sl33pinging/SplitSys/docs/HW_CHECKLIST.md

# SplitSys Phase H hardware checklist

Owner: `fpga-integrator`. Other agents contribute rows through the lead.
Phase H starts only after `red-team-reviewer` passes S4 (docs/PLAN.md).

**Rules for the session.** One physical action per message. Before each step the lead states the exact command and what the human should see. On any mismatch: **stop**, capture the evidence named in the row, and hand off for simulation reproduction (`verification-engineer`) **before** any rebuild or reprogram. Never overwrite `fpga/known_good/`.

All commands run from the repo root `C:\Users\danie\FPGA_Projects\Calhack2026` in **Git Bash** unless marked otherwise.

---

## Session results (Sat 2026-10-24; source: docs/STATUS.md decisions log)

| Step | KG1 = build `52a66216` (md5 6a85a822…) | KG2 = build `38a3950a` (md5 63dea71f…) |
| --- | --- | --- |
| H-1 heartbeat / LEDs / 7-seg | PASS (~12:45–12:58). Found two issues: 7-seg digit order reversed, RGB LEDs glow (PULLUP) | PASS (14:19–16:19): `S 14.4` reads in the right order, RGB dark |
| H-2 UART echo | PASS (~13:00): 10,000 B and 100,000 B, 0 mismatched. UART direction from the schematic confirmed | not rerun (UART RTL and pins unchanged) |
| H-3 packet / memory | PASS 13:19: 10,000 frames, 0 bad bytes | not rerun |
| H-4 self-test | PASS 13:26: 0/256 OBUF bytes differ | PASS 16:19: 0/256 |
| H-5 random GEMMs | PASS 13:37: 200 GEMMs, 0 output/counter mismatches | PASS 16:29: 200 GEMMs, 0 mismatches |
| H-6 benchmarks | PASS 13:41: 56/56, model error 0.000 % | not rerun |
| H-7 dashboard cold start | PASS (dashboard part, ~13:52–14:15, not clock-read): live kiosk on the monitor, BOARD LIVE build 52a66216, scripted demo (Space) ran and ended on Scene 2 with HW data (human screenshot); 16 dashboard records @52a66216 committed cd75ccc. Cold-start drill not possible without flash → done on KG2 | PASS 17:04 (with H-8e): `start_demo.ps1` 1.9 s wall (~2 s); STATUS records total ≈ 3–5 s; target < 60 s |
| H-8 QSPI flash + boot | not flashed | PASS: flash programmed and verified 16:42 (34 s); cold power-up from flash in **~1 s** (~16:50) |
| Archived | KG1 ~13:43 (7b3af2c), kept | KG2 16:31 (ccd7e3b); **`fpga/known_good/CURRENT` → KG2** |

**Booth configuration.** The board boots KG2 from QSPI flash. **Jumper J14 must stay fitted** (M2 tied to GND = Master SPI boot). If J14 is removed, the board powers up unconfigured. The live dashboard runs on **COM3**.

**Fallbacks** (each one replaces the running design, so stop the dashboard first; then restart it as in H-7):
- **KG2 over JTAG.** `program.tcl` works with J14 fitted, so the jumper can stay: `scripts/vivado -mode batch -source fpga/tcl/program.tcl -tclargs fpga/known_good/CURRENT` → `PROGRAM_OK`. JTAG configuration lasts until the next power cycle, after which the board reboots from flash (KG2).
- **KG1 over JTAG**, if KG2 misbehaves: `scripts/vivado -mode batch -source fpga/tcl/program.tcl -tclargs fpga/known_good/KG1/top.bit` (build 52a66216; known cosmetic quirks: reversed 7-seg digits, RGB LEDs lit). Do not edit `CURRENT` by hand.
- **Flash problems**: see the H-8 failure branch (`--verify-only`, rewrite, `--erase`, remove J14).

---

## Pre-flight (do once, in order)

| # | Check | Command / action | Expected |
| --- | --- | --- | --- |
| P-1 | USB strategy | Read `docs/ENV.md` "USB strategy". Default **(b)**: host runs natively on Windows on the board's COM port; Windows Vivado programs over JTAG. | Strategy (b) confirmed by the human. |
| P-2 | Board not attached to WSL | PowerShell: `usbipd list` | The Urbana's USB device is **not** "Attached". If it is: `usbipd detach --busid <id>`. |
| P-3 | Board connected | Human: plug the micro-USB cable into the Urbana and the laptop; set the power switch on. | Board power LED on. |
| P-4 | Windows sees the COM port | PowerShell: `Get-CimInstance Win32_SerialPort \| Select-Object DeviceID,Description` (or Device Manager → Ports) | One new COM port appears when the board is plugged in. Record it here: `COM__`. |
| P-5 | Vivado sees the device | `scripts/vivado -mode batch -source fpga/tcl/program.tcl -tclargs <bit>` is the first real use; if in doubt, open Vivado Hardware Manager → Open Target → Auto Connect. | One device `xc7s50_0`. |
| P-5a | Windows host binary | PowerShell: `powershell -NoProfile -ExecutionPolicy Bypass -File scripts\win_build_host.ps1` (docs/ENV.md "Windows host build (USB strategy b)"; needs Windows rustup/cargo, the script prints install steps and exits 2 if they are missing) | Ends with `OK: ...sw\target\release\splitsys-host.exe`; the COM ports it lists include the board's. **The exe must be newer than the last commit touching `demo/` or `sw/crates/host`** (the dashboard is compiled into the binary): compare Git Bash `git log -1 --format=%cd -- demo sw/crates/host` with `ls -l --time-style=full-iso sw/target/release/splitsys-host.exe`; if the exe is older, or either tree has uncommitted changes (`git status --short demo sw/crates/host` not empty), rerun this script. Checked 12:37 on 2026-10-24: last change 12:20:26, exe 12:35:20 (current). With the board connected, `scripts\win_build_host.ps1 -Ping -Transport serial:COM__` once a packet bitstream (H-3 onward) is loaded. |
| P-6 | Bitstreams present and current | `cat fpga/reports/<tag>/summary.json` for each tag used below; `git log --oneline -1` | `"pass":true`, `"git_dirty":"false"`, `wns_ns` ≥ 0. The `build_id` you will see on the board is the `build_id` field. If `fpga/build/<tag>/top.bit` is missing (it is gitignored), rebuild with the command in the row; the build_id then changes to the new HEAD hash. |

---

## Board facts (verified in Phase S from the vendor files; confirmed on hardware in Phase H)

Sources: master XDC `fpga/xdc/urbana_master.xdc` ("URBANA BOARD CONSTRAINTS V2I1 1/3/2023") and the schematic `C:\Users\danie\Downloads\Urbana_V2I1_SCH_2023-01-03.PDF` (19 pages, V2I1). Schematic facts were read from the PDF's embedded net/pin annotations (text extraction with pypdf; the pages were not rendered).

| Fact | Value | Evidence |
| --- | --- | --- |
| Clock | 100 MHz on FPGA N15 | master:2–4; sch p11: oscillator IC16 `ASEM1-100.000MHZ` → buffer IC15 → net `CLK_100MHZ` → N15 |
| USB-UART direction | **FPGA receives on B16, transmits on A16.** The master-XDC names are from the FTDI's side. | sch p12: B16 = net `UART_TXD`, A16 = net `UART_RXD`. sch p10: `UART_TXD` = FT2232HQ (IC6) pin 38 = BDBUS0, `UART_RXD` = pin 39 = BDBUS1; channel A pins 16–19 are JTAG (FT_TCK/TDI/TDO/TMS), so channel B is the UART, where BDBUS0 = TXD (FTDI output) and BDBUS1 = RXD (FTDI input), per the FTDI DS_FT2232H pin table (vendor datasheet, from knowledge; not in the repo). Project XDC: port `UART_RXD` → B16, `UART_TXD` → A16. **Confirmed on hardware at H-2** (2026-10-24, COM3, build 52a66216): 10,000-byte echo and a 100,000-byte soak, 0 mismatched, with the default pins. |
| Buttons BTN0–3 | **Active high** (pressed = 1), external 10k pull-down | sch p4: each button ties `VCCp2V5` to a node with 10k to GND (R60–R63); that node reaches net BTNn through 10k (R43/R47/R52/R57). FPGA pins J2/J1/G2/H2 (sch p13, master:48–51). **Confirmed on hardware at H-1**: BTN0–3 held → LED8–11 on (`BTN_ACTIVE_LOW = 0` is correct). |
| LEDs LD0–15 | **Active high** | sch p4: net LDn → 330R → LED anode; all LED cathodes on GND. **Confirmed on hardware at H-1** (LED14 steadily on, LED15 1 Hz). |
| 7-seg anodes D0/D1_AN | **Active low** | sch p4: each AN net drives a PNP (MBT3906DW1) high-side switch base through 1.5k. Master XDC also says "Active LOW". |
| 7-seg segments D0/D1_SEG | **Active low**, SEG[0..7] = A, B, C, D, E, F, G, DP | sch p4: SEG nets → 100R → cathode pins of the common-anode KW4-281ASB (SEG_0→pin 11 CA, SEG_1→7 CB, SEG_2→4 CC, SEG_3→2 CD, SEG_4→1 CE, SEG_5→10 CF, SEG_6→5 CG, SEG_7→3 DP). |
| Which display is left; which AN is the leftmost digit | **D0 is the LEFT display; AN[0] is the LEFTMOST digit of each display** (AN[3] the rightmost). Left to right the 8 digits are D0 AN[0..3], then D1 AN[0..3]. | **Measured at H-1** (2026-10-24): `heartbeat_uart_echo` showed `6.126 6A25` for build_id 0x52A66216 (see H-1 item 3 for the derivation). The schematic cannot tell this (layout). rtl-designer set `LEFT_IS_D1 = 0`, `AN0_IS_RIGHT = 0` in `rtl/top.sv` / `rtl/board_io.sv` in dc1dea0, **after** the 52a66216 build: every bitstream at 52a66216, including `top` / KG1, still has the old assumption (`LEFT_IS_D1 = 1`, `AN0_IS_RIGHT = 1`), so on those bitstreams any host `SET_DISPLAY` text reads **reversed** (logical digit p appears at physical position 7−p). All-`-` (the H-4 power-up display) looks the same either way. Fixed in the first build after dc1dea0: build 38a3950a (KG2 candidate; synth log binds `LEFT_IS_D1`/`AN0_IS_RIGHT` to 1'b0 in `top`/`top_nostrip`, `packet_mem` uses the 0/0 board_io defaults). `heartbeat_uart_echo` has its own display glue, so at H-1 it still shows the build_id reversed with the DP after the first digit: `A.059 3A83` for 0x38A3950A. |
| RGB LEDs RGB0/RGB1 | Not used by any SplitSys top. **Lit at full brightness on every 52a66216 bitstream** (cosmetic, not a failure). | **Seen at H-1.** The unused pins (C9 A9 A10 / A11 C10 B11, master:54–59) get the bitstream's unused-pin pull; the XDC copied `BITSTREAM.CONFIG.UNUSEDPIN PULLUP` from master:465, and sch p4 shows each RGBn_x net driving the IN pin of a low-side switch (Q5–Q10, pins GND/IN/OUT) on a VCCp5V0 LED, so a pull-up turns it on. `fpga/xdc/urbana_splitsys.xdc` now sets **PULLDOWN** (also the Vivado default); effective from the next build only. |
| Unused-pin pull-down safety | PULLDOWN is safe on this board | Dedicated config/JTAG pins (CCLK, DONE, INIT_B, PROGRAM_B, M0–M2, TCK/TMS/TDI/TDO, CFGBVS) are not user I/O, so UNUSEDPIN does not touch them. The pull applies only after configuration, so it cannot affect a later JTAG or QSPI boot. The multi-function bank-14 pins that become user I/O after configuration do get it (QSPI FCS_B M13, D00–D03 K17/K18/L14/M15, QSPI_RESET_B N13, PUDC_B L15), but sch p11 shows external pull-ups to VCCp3V3 on QSPI_CS_B (R168, 4.7k), DQ2 (R165), DQ3 (R166) and QSPI_RESET_B (R167, 4.7k). Those beat the FPGA's weak pull-down (tens of µA), so the flash stays deselected and out of reset. Other unused peripherals only see a weak low: the MAX3421E USB host is held in reset (USB_RESET_B V13), the DDR3 stays in reset (ddr3_reset_n M5, CKE T5), and SPKL/SPKR are silent. **Some unused pins are active low, so the pull-down asserts them:** USB_SS_B (T12) is the MAX3421E's SPI chip select, and ddr3_ras_n/cas_n/we_n (U2/U1/T2) are the DDR3 command strobes. That is harmless because the reset of each device (USB_RESET_B, ddr3_reset_n) is pulled low too, so both stay in reset and ignore their selects and strobes. SEL_JOYSTICK (F6) also goes low. The master XDC does not say what it selects, and no SplitSys top uses it. No power-switch control was found (checked by pin name in the master XDC; the schematic was read from extracted text, not rendered). Observed on KG2 (PULLDOWN): H-1/H-4/H-5/H-8 pass, RGB LEDs dark. The XDC comment points here. |
| QSPI flash and boot-mode jumper | Flash **IC10 = Micron MT25QL128ABA8ESF** (3 V, 128 Mbit = 16 MB). Vivado 2025.2.1 cfgmem part **`mt25ql128-spi-x1_x2_x4`**. Boot mode is set by **jumper J14** (2-pin header on M2): **J14 fitted = M[2:0] 001 = Master SPI (boots from flash at power-up)**; J14 open = 101 = JTAG (the board's default). JTAG programming works in both positions. | sch p11 ("FPGA BANK 0, XADC and Clock"): IC10 `MT25QL128ABA8ESF` with SDI/DQ0, SDO/DQ1, WP/DQ2, HOLD/DQ3, SCK, CS, RESET# on nets QSPI_DQ0..3, QSPI_SCK (CCLK_0 C8 via R174 0R), QSPI_CS_B, QSPI_RESET_B; the table "Configuration Mode M[2:0]: Master SPI 001, JTAG 101 Default"; M0_0 (T10) 1k pull-up R169, M1_0 (U10) 100R R171 to GND, M2_0 (U9) 1k pull-up R170 and J14 pin 1; J14 pin 2 = GND (net list). sch p12: QSPI_DQ0..3 = K17/K18/L14/M15 (IO_L1P_T0_D00_MOSI_14 .. IO_L2N_T0_D03_14), QSPI_CS_B = M13 (IO_L6P_T0_FCS_B_14); master:143-149 agree (QSPI_RESET_B = N13, 4.7k pull-up R167). `get_cfgmem_parts *mt25ql128*`: `mt25ql128-spi-x1_x2_x4` is the entry with `COMPATIBLE_PARTS` incl. spartan7, Micron, `MEM_DENSITY` 128, `MEM_TYPE` spi (the `-qspi-` names are Zynq-only). Read from extracted PDF text, not a rendered drawing: J14's position on the PCB was **not** checked; find it by the silkscreen label `J14`. |

---

## Bitstream manifest

Generated by `python fpga/tcl/manifest.py` (called by `fpga/tcl/s4_rebuild.sh`); do not edit by hand. Every Phase H bitstream comes from ONE commit. Before programming, compare the md5 of `fpga/build/<tag>/top.bit` with this table (PowerShell `Get-FileHash -Algorithm MD5 <file>`); a mismatch means the file on disk is not the reviewed build: rebuild with `fpga/tcl/s4_rebuild.sh`.

**`top_uartswap` is retired** (H-2 confirmed the default UART pins). It was removed from the default `TAGS` in `fpga/tcl/manifest.py` (2026-10-24), and `s4_rebuild.sh` never built it, so its row disappears the next time the manifest is regenerated. Its 52a66216 reports stay committed in `fpga/reports/top_uartswap/` for history. `heartbeat_uart_echo_uartswap` and `packet_mem_uartswap` are retired for the same reason: dropped from `s4_rebuild.sh` and the manifest `TAGS` (2026-10-24), so the rebuild is 4 tags; their 52a66216 reports stay committed for history.

<!-- MANIFEST:BEGIN -->
| Tag | Used at | build_id | git | WNS / WHS (ns) | UART pins | bit md5 |
| --- | --- | --- | --- | --- | --- | --- |
| `heartbeat_uart_echo` | H-1, H-2 | `0x38A3950A` | `38a3950a` | +5.769 / +0.118 | RX B16 / TX A16 | `20fc1de9b4ae92bed3da9df622fa8126` |
| `packet_mem` | H-3 | `0x38A3950A` | `38a3950a` | +2.780 / +0.082 | RX B16 / TX A16 | `225d7a576ca4af5b5c50949b72000e1a` |
| `top` | H-4 .. H-7 (KG source) | `0x38A3950A` | `38a3950a` | +0.744 / +0.029 | RX B16 / TX A16 | `63dea71fd7e8c151f836143c8bac2b2a` |
| `top_nostrip` | cost build only (results/cost.json); never programmed for the demo | `0x38A3950A` | `38a3950a` | +2.188 / +0.040 | RX B16 / TX A16 | `5159a21b81870acfd325c9a72fd90d49` |
<!-- MANIFEST:END -->

---

## H-1 — Heartbeat, LEDs, 7-segment lamp test

| Field | Value |
| --- | --- |
| Bitstream | `fpga/build/heartbeat_uart_echo/top.bit` |
| Build | `scripts/vivado -mode batch -source fpga/tcl/build.tcl -tclargs heartbeat_uart_echo heartbeat_uart_echo PHYS_OPT=AggressiveFanoutOpt POST_ROUTE_PHYS_OPT=1` (normally run by `fpga/tcl/s4_rebuild.sh`; result `fpga/reports/heartbeat_uart_echo/summary.json`) |
| build_id | See **Bitstream manifest** (top of this file), row `heartbeat_uart_echo`: build_id, git hash and bit md5. Check the md5 of the file you program: PowerShell `Get-FileHash -Algorithm MD5 fpga\build\heartbeat_uart_echo\top.bit`. |
| Program command | `scripts/vivado -mode batch -source fpga/tcl/program.tcl -tclargs fpga/build/heartbeat_uart_echo/top.bit` |
| Physical action | None beyond pre-flight. After programming: **watch the board for 5 seconds**, then **press and hold BTN0** for 2 s, release, and do the same for BTN1, BTN2, BTN3 (one at a time). |
| Host command | none |
| Expected observation | 1. Console prints `PROGRAM_OK` and `DONE pin = '1'`.<br>2. For the first **2 s** every segment and every decimal point of all **8** digits is lit (lamp test).<br>3. Then the display shows the `heartbeat_uart_echo` build_id from the manifest, **written backwards, with one DP after the leftmost digit**. For the current bitstream (build_id `0x52A66216`) you read, left to right: **`6.126 6A25`**. This is what H-1 showed on 2026-10-24. Why: the bring-up logic (`fpga/bringup/heartbeat_uart_echo/heartbeat_uart_echo.sv`, left unchanged on purpose as a diagnostic) puts BUILD_ID[15:0] on D0 and BUILD_ID[31:16] on D1, shows nibble k of each half on AN[k], and lights only the DP of D0 AN[0]. On this board D0 is the left display and AN[0] is the leftmost digit (Board facts). So physical position p (0 = leftmost … 7 = rightmost) shows BUILD_ID nibble p: positions 0–3 are D0 AN[0..3] = nibbles 0–3, and positions 4–7 are D1 AN[0..3] = nibbles 4–7. General rule: take the 8 hex digits of the build_id, reverse them, and put the DP after the first one. `52A66216` reversed is `61266A25` → `6.126 6A25`. `A` is the uppercase A shape (segments a b c e f g); `6` has its top segment lit. Any other string (e.g. `52A6 6216.`) means the wrong bitstream or a different board: stop and capture a photo.<br>4. **LED15 blinks at 1 Hz** (0.5 s on, 0.5 s off: count 10 blinks in ~10 s).<br>5. **LED14 is steadily on.** All other LEDs off (LED3 may flash once if the COM port is opened). RGB0/RGB1 glow at full brightness on every 52a66216 bitstream: this is cosmetic (unused-pin pull-up, Board facts) and not a failure.<br>6. While a button BTNn is held, LED(8+n) is **on**; it goes off when released (the schematic says the buttons are active high). |
| Record (resolved at H-1 on 2026-10-24; now re-checks only) | (a) the exact 8-character string read left to right and where the lit DP is. It must be the build_id reversed with the DP after the first digit (`6.126 6A25` for `0x52A66216`). H-1 recorded exactly that, which settled D0 = left display and AN[0] = leftmost digit (Board facts).<br>(b) confirm LED8–11 are off when released and on when pressed (active high, sch p4). **Confirmed at H-1**, so `BTN_ACTIVE_LOW = 0` is right. (If a different board ever shows them reversed, `top` needs `BTN_ACTIVE_LOW=1` from `rtl-designer`, or BTN1 holds `top` in reset.)<br>(c) LED14 lit (LED logic 1 = on, sch p4). **Confirmed at H-1.** |
| Failure branch | Capture: the full program console output, a photo of the board (LEDs + display), and `usbipd list`. Likely causes, in order: (1) no JTAG target → cable/power, or device attached to WSL (P-2); (2) `PROGRAM_FAIL: DONE` → wrong part or corrupt bit, rebuild; (3) programmed but nothing lit → check LED14 (active high per sch p4; all-dark means the design is not running: check DONE, the clock); (4) LED15 wrong rate → clock is not 100 MHz (check schematic oscillator; SPEC CLK_HZ must change via `spec-steward`); (5) 7-seg blank but LEDs fine → anode/segment polarity (active-low per master XDC and sch p4). |

## H-2 — UART echo, 10,000 bytes

| Field | Value |
| --- | --- |
| Bitstream | same as H-1 (`fpga/build/heartbeat_uart_echo/top.bit`); no reprogram needed if H-1 just passed. |
| Program command | (only if power-cycled) `scripts/vivado -mode batch -source fpga/tcl/program.tcl -tclargs fpga/build/heartbeat_uart_echo/top.bit` |
| Physical action | none |
| Host command | Windows (strategy b): `splitsys-host --transport serial:COM__ echo --bytes 10000` (default baud 115200 from the spec). Before it, a quick link check with the Windows build script: `powershell -NoProfile -ExecutionPolicy Bypass -File scripts\win_build_host.ps1 -Ping -Transport serial:COM__` (**on this bitstream the ping is EXPECTED to fail**: the echo top has no packet layer, so the host gets its own request bytes back, never a response frame, and after its retries prints `splitsys-host: error: PING ...` (timed out / retries exhausted) followed by the red `win_build_host: ping over serial:COM__ failed (exit 1)` and a non-zero exit. That is a pass for this step if the error is a timeout and not an `I/O error` / port-open error: it shows only that the port opens and the binary runs). Link settings: 115200 baud, 8N1, no flow control. <br>Fallback sanity check if the host is not ready: PuTTY (Serial, COM__, 115200, 8N1, flow control None); type characters. |
| Expected observation | Host prints exactly one line, **`ECHO 10000 bytes, 0 mismatched, <ms> ms`** (format from `sw/crates/host/src/main.rs` `Cmd::Echo`; `<ms>` with one decimal; expect a few seconds, since the 10,000 bytes go out in 64-byte bursts and each burst waits for its echo, so the time includes USB-serial latency; it is not a pass criterion), and exits 0. Any nonzero `mismatched` count exits 1. A missing-byte failure is not this line but `splitsys-host: error: echo: timeout after N of 10000 bytes returned` (2 s per 64-byte burst). LED3 lit during the transfer. LED4 (frame error) and LED5 (FIFO overflow) stay **off**. In PuTTY: each typed character appears once. |
| Board facts used | FPGA **receives on B16** (schematic net `UART_TXD` = FTDI TXD) and **transmits on A16** (net `UART_RXD` = FTDI RXD); see Board facts (sch p10, p12). **Confirmed by this step on 2026-10-24** (COM3: `ECHO 10000 bytes, 0 mismatched`, 2.5 s; 100,000-byte soak, 0 mismatched). Effective baud = 100 MHz / (54 × 16) = 115,741 (+0.47 %); the echo top has a 64-byte FIFO, and RX tolerates about ±4 %. |
| Failure branch | Capture: host console output (`> h2_echo.log`), first 64 bytes sent vs received in hex, LED3/4/5 states, a photo.<br>**UART-swap branch: NOT NEEDED. H-2 passed with the default pins on 2026-10-24, so the direction is confirmed.** The branch below is kept for the record only. `top_uartswap` is retired (see the Bitstream manifest note). On this board a 0-byte echo means a COM-port or cable problem, not the pins.<br>Historical: **`echo: timeout after 0 of 10000 bytes returned`** (0 bytes echoed, the COM port is right and not held by another program) → the UART pins may be the other way round; the FT2232H pin function behind the default came from the datasheet as recalled, not a file in the repo. Program the prebuilt fallback and repeat H-2:<br>`scripts/vivado -mode batch -source fpga/tcl/program.tcl -tclargs fpga/build/heartbeat_uart_echo_uartswap/top.bit`<br>(FPGA RX = A16, TX = B16; build_id and md5 in the manifest, row `heartbeat_uart_echo_uartswap`).<br>**If H-2 needs the swap (the swap bitstream echoes correctly): H-3 uses `fpga/build/packet_mem_uartswap/top.bit`, H-4 and later use `fpga/build/top_uartswap/top.bit`** (both prebuilt at the same commit, rows `packet_mem_uartswap` / `top_uartswap` in the manifest; `top_uartswap` = the full `top`, ENABLE_STRIP=1, FPGA RX = A16 / TX = B16; read-only copy in `C:\Users\danie\FPGA_Projects\SplitSys_reviewed_bits\52a66216\top_uartswap\top.bit`). No rebuild is needed. KG1 then archives `top_uartswap` instead of `top` (H-6). The cost build `top_nostrip` is never programmed, so its pins do not matter. **Record that the default pin mapping (RX B16 / TX A16 in `fpga/xdc/urbana_uart.xdc`) was wrong**: write it in docs/ENV.md and in the H-2 result here. Do not edit the XDC during Phase H; flipping the default means rebuilding and re-reviewing every bitstream, so it waits until after the demo.<br>Other likely causes, in order: (1) wrong COM port or the port held by another program; (2) LED3 lights but nothing comes back (`timeout after 0 of 10000`) → TX pin (swap as above); `timeout after N of 10000` with N > 0 → bytes stopped mid-run: check LED5/LED4 and see (4)/(5); (3) garbage bytes → baud mismatch (host not at 115200, or clock not 100 MHz: compare the H-1 heartbeat rate); (4) occasional drops with LED5 on → host sending much faster than 115200 or the FIFO too small (report to lead); (5) LED4 on only after opening the port → a glitch on port open; press and release BTN1 (clears LED4/LED5) and retry. |
| Then | If the plan raises the baud (SPEC §3.8: only after 10,000 packets at 115200 pass), that is a later H-3 decision, not part of this bitstream. |

## H-3 — Packet layer and memory round trips

| Field | Value |
| --- | --- |
| Bitstream | `fpga/build/packet_mem/top.bit` (top `fpga/bringup/packet_mem/packet_mem.sv`: production uart_rx/tx + packet + 4× buffers + board_io; sequencer, self-test and counters are **stubs**) |
| Build | `scripts/vivado -mode batch -source fpga/tcl/build.tcl -tclargs packet_mem packet_mem PHYS_OPT=AggressiveFanoutOpt POST_ROUTE_PHYS_OPT=1` (normally run by `fpga/tcl/s4_rebuild.sh`; result `fpga/reports/packet_mem/summary.json`) |
| build_id | See **Bitstream manifest** (top of this file), row `packet_mem`. |
| Program command | `scripts/vivado -mode batch -source fpga/tcl/program.tcl -tclargs fpga/build/packet_mem/top.bit` (the swap variant is not needed: the UART pins were confirmed at H-2) |
| Physical action | none |
| Host command | 1. `splitsys-host --transport serial:COM__ ping`<br>2. `splitsys-host --transport serial:COM__ memtest --frames 10000 --seed 1` (random region, unaligned address and length; WRITE_MEM then READ_MEM and compare; added by host-dashboard in 93f0944) |
| Expected observation | 1. `PING ok: build_id <packet_mem build_id from the manifest, lowercase, no 0x>  proto v1`.<br>2. `MEMTEST PASS`, NACK_CRC 0, and all four `regions (frames)` counts > 0 (WBUF, ABUF, OBUF, RQPARAM). LED15 1 Hz heartbeat, LED3 flickers during traffic. The 7-segment display shows `-` on every digit (board_io before the first SET_DISPLAY). |
| Do NOT use with this bitstream | `selftest` (the stub answers pass = 0 with zero checksums), `run` / `bench` (RUN_GEMM is accepted but nothing is computed), `READ_COUNTERS` (all zeros). |
| Failure branch | Capture: host console with `RUST_LOG`/verbose output if available, the failing frame (region, address, length, first differing byte), a photo. Likely causes, in order: (1) PING times out but H-2 echo passed → packet-layer bug: reproduce with `bash fpga/bringup/packet_mem/sim/run.sh` and the same bytes (`verification-engineer`); (2) NACK_CRC bursts → link noise or baud mismatch: rerun H-2; (3) data mismatches in one region only → buffers or mux for that region; (4) mismatches at word boundaries → byte-enable handling. |

## H-4 — Self-test (BTN0 and SELFTEST opcode)

| Field | Value |
| --- | --- |
| Bitstream | `fpga/build/top/top.bit` (full design, ENABLE_STRIP=1; result `fpga/reports/top/summary.json`, timing in the manifest, 96 DSP, 26 BRAM; self-test ROM read from `sw/crates/vec/out/selftest_rom.mem` and kept as 1 RAMB18 in `u_selftest`). If `rtl/` changes after this commit, rebuild and update this row. |
| Build | `scripts/vivado -mode batch -source fpga/tcl/build.tcl -tclargs top top PHYS_OPT=AggressiveFanoutOpt POST_ROUTE_PHYS_OPT=1` (ROM `sw/crates/vec/out/selftest_rom.mem`; must have `"pass":true`, `"git_dirty":"false"`, `dsp` ≥ 64) |
| build_id | See **Bitstream manifest** (top of this file), row `top`. |
| Program command | `scripts/vivado -mode batch -source fpga/tcl/program.tcl -tclargs fpga/build/top/top.bit` (`top_uartswap` is retired: the UART pins were confirmed at H-2) |
| Physical action | After programming: **press BTN0 once** (short press). |
| Host command | then `splitsys-host --transport serial:COM__ ping`, then (primary) `splitsys-host --transport serial:COM__ selftest --dump` (runs the SELFTEST opcode, then reads back each job's OBUF and diffs it against golden; host-dashboard e7ad5bf) |
| Expected observation | 1. After programming: LED15 heartbeat at 1 Hz; display shows `-` on every digit; LED0/LED1 off.<br>2. BTN0: the self-test takes about 2.3k cycles (~23 µs), so LED2 (busy) is too short to see; **LED0 (FULL pass) and LED1 (STRIP pass) light and stay lit**. BTN0 starts the self-test only while the packet layer is idle; if nothing happens, press again.<br>3. `ping` prints `PING ok: build_id <build_id>  proto v1`.<br>4. `selftest --dump` prints `SELFTEST FULL : PASS (fletcher32 6c1d81af)` and `SELFTEST STRIP: PASS (fletcher32 8b1c6e80)`, then for both jobs a PASS with **0 differ**, and read-back checksums equal to the ROM values 6c1d81af / 8b1c6e80; exit 0. The expected values are from `sw/crates/vec/out/selftest_expected.json`; recheck them if the ROM is regenerated. |
| Failure branch | Capture: the full `selftest --dump` output, in particular **every per-byte `C[m,n] tile PE(r,c) Qk` line** (output element, tile, PE and quadrant of each differing byte); then dump the raw OBUF: `splitsys-host --transport serial:COM__ dump --region obuf --addr 0 --len 256 --out h4_obuf.bin`; plus a LED0/1/2 photo and the `ping` output. Hand these to verification-engineer via triage **T-1** below. Likely causes, in order: (1) nothing happens on BTN0 and LED0/1 stay off, but `selftest` over UART passes → button polarity or debounce (`BTN_ACTIVE_LOW`; H-1 record (b)); (2) the design looks held in reset (no heartbeat) → BTN1 polarity: `BTN_ACTIVE_LOW` is wrong, so BTN1 reads as held; (3) FULL fails with a checksum different from expected → datapath bug: hand the checksum to `verification-engineer` to reproduce in `tb/system` with the same ROM; (4) FULL passes, STRIP fails → STRIP-specific path (skew/lower-half alignment); (5) `selftest` times out → the self-test engine never pulses `st_done`. **Verification triage:** see "Hardware failure triage (verification)" at the end of H-5, branches T-1 (self-test) and T-4 (hardware-only suspects). |

## H-5 — Random GEMMs, both modes

| Field | Value |
| --- | --- |
| Bitstream | same as H-4 (`fpga/build/top/top.bit`); no reprogram after H-4 passes. |
| Physical action | none |
| Host command | `splitsys-host --transport serial:COM__ run --random 100 --mode both --seed 1` (100 random GEMMs per mode, each checked bit-exact against golden and counters against the model; added by host-dashboard in 93f0944). Keep the OBUF poisoning on (do not pass `--no-poison`), so 100 runs per mode take several minutes at 115200. |
| Expected observation | `BATCH PASS: ... mismatches 0 counter_mismatches 0 invariant_failures 0 errors 0`, i.e. bit-exact and every counter equal to the cycle model. All latencies were confirmed in sim (D-017). If hardware counters still differ from the model by a constant, PLAN allows one calibration (perf-modeler, via spec-steward), after which the latencies are frozen and the batch is rerun; anything else is a bug. Run records go to `results/hw/` with `source: "hw"`. |
| Failure branch | Capture: the full console output, and **copy the `first failure:` line** (it carries the exact `splitsys-vec gemm ...` sim command, the job index, desc_hex, and the PE/quadrant of the first differing output); hand it to `verification-engineer` for sim reproduction before any change. Also keep the run-record JSON from `results/hw/`. Likely causes, in order: (1) counters off by a constant in every run → provisional latency; calibrate once (perf-modeler); (2) mismatches only in STRIP → STRIP datapath; (3) mismatches only for some M/N → tiling/edge handling in the sequencer; (4) sporadic mismatches that don't repeat with the same seed → UART/link issue: rerun H-3 memtest. |

### Hardware failure triage (verification)

Contributed by `verification-engineer`. These branches apply to **H-4 and H-5**.

The rule is the same in every branch:
1. Capture the evidence first.
2. Reproduce the failure in simulation, using the RTL that is in the bitstream.
3. Only then change anything.

RTL is frozen at `adca4a3` for Phase H. Never edit RTL, golden, or the cycle model to make hardware match.

All commands below run from the repo root in Git Bash. `<B>` is the 8-hex-digit git hash that `ping` prints as `build_id`. For the reviewed S4 build it is the `build_id` / git column of the **Bitstream manifest** row `top` (at the time of writing `52a66216`, built and recorded by commit 8ccb333; `rtl/` is identical from `adca4a3` to `52a66216`). Pass it as `RTL_REV=<B>`. The testbench then simulates exactly the `rtl/` that went into the bitstream (`git archive <B> rtl`).

**Before any triage**, check these two things:
- `splitsys-host --transport serial:COM__ ping` must print the build_id in the H-4 row. If it doesn't, the wrong bitstream is loaded: reprogram and stop triaging.
- `git diff <B> -- sw/crates/vec/out/selftest_rom.mem sw/crates/vec/out/selftest_expected.json` must print nothing. If it prints anything, the expected values on the laptop no longer match the ROM inside the bitstream.

| Branch | Trigger | Capture (save under `results/hw/triage/<time>/`) | Simulation reproduction (WSL, through `scripts/wsl '...'`) | Decision |
| --- | --- | --- | --- | --- |
| **T-1 Self-test fails** (H-4) | LED0 and/or LED1 off after BTN0, or `selftest` prints FAIL | <ul><li>Full console output of `ping` and `selftest`, including both `fletcher32` values.</li><li>A photo of LED0/1/2/15 and the 7-segment display.</li><li>The `ping` build_id.</li></ul> | 1. `scripts/wsl 'SPLITSYS_CACHE_TAG=hw make -C tb/system SUITES=selftest RTL_REV=<B>'`. This runs the same ROM through the real UART pins of `top` (SELFTEST opcode, BTN0, BUSY cases). It must print PASS with `fletcher32` FULL `6c1d81af` / STRIP `8b1c6e80`.<br>2. Repeat with the X-initial-state variant: append `RAND_RESET=1`.<br>3. Localize on hardware without reprogramming: `splitsys-host --transport serial:COM__ run --random 4 --mode both --seed 1`. Each failing run reports `first mismatch`; map it with the table in T-2. | <ul><li>Sim fails with the same checksum → RTL bug. Hand to `rtl-designer` with the sim command; `verification-engineer` minimizes it with `tb/core`.</li><li>Sim passes, hardware fails → T-4.</li><li>Both checksums wrong and equal to the checksum of an all-zero OBUF → suspect the ROM `$readmemh` path (T-4 item 4).</li></ul> |
| **T-2 Random GEMM mismatch** (H-5) | `BATCH FAIL` with `mismatches` > 0 or `errors` > 0 | <ul><li>The whole console output.</li><li>**The `first failure:` line, verbatim.** It contains the job name (e.g. `gemm_full_s1_17`), the job index, the exact `splitsys-vec gemm --seed S --n N --mode M --max-m 64 --max-k 256 --max-n 256` command, M/K/N, requant, `desc_hex`, and the seed.</li><li>The run-record JSONs in `results/hw/`. `check.first_mismatch` is the row-major index `m*N+n` of the first wrong in-bounds output.</li></ul> | 1. Same job, same generator, through the UART pins: `scripts/wsl 'SPLITSYS_CACHE_TAG=hw make -C tb/system SUITES=<mode> N_FULL=<N> N_STRIP=<N> SEED=<S> ONLY=<job name> RTL_REV=<B>'`. `<mode>` is `full` or `strip`, and `<N>` is the `--n` from the `first failure:` line. tb/system uses the same generator and the same default limits as the host, so `ONLY=gemm_full_s1_17` is the identical job.<br>2. Add `WAVES=1` for an FST of that job only, under the run's log directory in `waves/`.<br>3. Repeat with `RAND_RESET=1`.<br>4. Whole H-5 batch in sim: `scripts/wsl 'SPLITSYS_CACHE_TAG=hw make -C tb/system SUITES=full,strip N_FULL=100 N_STRIP=100 SEED=1 RTL_REV=<B>'`. | **Map `first_mismatch` to hardware.** With m = idx / N and n = idx % N:<ul><li>FULL: tile row r = m % 8 and column c = n % 8 give PE(r, c), in quadrant 2·⌊r/4⌋ + ⌊c/4⌋.</li><li>STRIP: i = m % 4 and j = n % 16. If j < 8 the element is in PE(i, j); otherwise it is in PE(4+i, j−8), the lower half fed by W lanes 8–15.</li></ul>If sim reproduces the failure → RTL bug, minimized by `verification-engineer` in `tb/core`. If sim passes → T-4. |
| **T-3 Counters-only mismatch** (H-5) | Outputs bit-exact (`mismatches 0`) but `counter_mismatches` > 0 (`counter <name>: measured vs model` lines) | <ul><li>Every `counter ...` line.</li><li>The run records (`counters` and `model` blocks).</li><li>Note whether the difference is the same constant on every run, or depends on M/N/K or the mode.</li></ul> | Run the same job in sim (T-2 step 1). tb/system compares every counter against `splitsys-cycle predict`. For a faster check without UART, run `scripts/wsl 'SPLITSYS_CACHE_TAG=hw make -C tb core RTL_REV=<B>'`; it compares all 12 counters on 300+ jobs, and was 0 diffs at sign-off. | <ul><li>**Never tweak the model, the latencies, or the RTL to match.**</li><li>Sim counters equal the model but hardware differs → a hardware-only effect. A synchronous design should not do this, so suspect timing or clock (T-4 items 5 and 3). Hand the evidence to `perf-modeler` and the lead.</li><li>Sim differs too → model/RTL disagreement → `perf-modeler` reconciles via `spec-steward`.</li><li>PLAN allows **one** calibration, only for a constant offset seen on every run. After it the model is frozen and the batch is rerun. Record the decision in `docs/DECISIONS.md`.</li></ul> |
| **T-4 Sim passes, hardware fails** | Any of T-1 to T-3 where the reproduction with `RTL_REV=<B>` passes | The `build_id`, `fpga/reports/top/summary.json`, the build log, and the H-1 to H-3 results. | — | Check the hardware-only suspects below, in order. |

**Hardware-only suspects for T-4, in order:**
1. **Wrong or stale bitstream.**
   - Check: `ping` build_id and the bit md5 against the H-4 row.
2. **Pins / UART swap.**
   - H-2/H-3 passed with the default pins (FPGA RX = B16 / TX = A16) on 2026-10-24, so the UART pins are proven for data. The swap fallback was not used.
   - Data errors with an intact frame CRC are not a pin problem.
3. **Clock / baud divisor.**
   - Check `DIV_OVERRIDE`: `grep -n "Parameter DIV_OVERRIDE bound to" fpga/reports/top/build.log` must show only `32'b00000000000000000000000000000000` lines (one per UART instance; build.tcl refuses a nonzero override). `summary.json` does **not** carry DIV_OVERRIDE or CLK_HZ; it has only `clk_period_ns` (must be `10.0`) and the `generics` (BUILD_ID, ENABLE_STRIP, ROM_FILE).
   - Check `CLK_HZ`: it is a package constant, not a generic: `git show <B>:rtl/gen/splitsys_pkg.sv | grep "CLK_HZ ="` must print `100000000`, matching `create_clock -period 10.000` on `CLK_100MHZ` (N15) in `fpga/xdc/urbana_splitsys.xdc`.
   - A wrong divisor breaks H-2 first.
4. **BRAM init / ROM `$readmemh` path.**
   - The self-test ROM must come from `sw/crates/vec/out/selftest_rom.mem` at `<B>`.
   - Check the build log for `$readmemh` warnings or "file not found", and `summary.json` for the ROM path.
   - An all-zero ROM gives the zero-output checksum on both jobs.
5. **Timing.**
   - Check: `fpga/reports/top/summary.json` `wns_ns`/`whs_ns` ≥ 0 for this exact build, equal to the manifest row `top` (S4 build: **+0.523 / +0.036 ns**), and the bit md5 equal to the manifest.
   - Errors that are data-dependent, sporadic, or temperature-dependent point here.
   - There is **no** prebuilt fallback bitstream (no 75 MHz or alternate-clock build exists). If a timing-related failure is suspected: first re-run the sim reproduction (T-1/T-2 with `RTL_REV=<B>`, plus `RAND_RESET=1`); only if it passes in sim and the evidence points at timing does the lead decide on a rebuild: `rtl-designer` adds `max_fanout` on the reset replica nets (`u_board/rst_r` → `rst_core_reg_rep__*`, the worst paths of `top` in `fpga/reports/top/paths.rpt`) and on the sequencer `int32_q`, full sim regression (`make -C tb signoff`, `make -C tb/system SIGNOFF=1`), then `bash fpga/tcl/s4_rebuild.sh` (new build_id, new manifest), then `red-team-reviewer` re-review before the board is touched. Never debug on a build with negative slack.
6. **Reset polarity / button level** (`BTN_ACTIVE_LOW`, H-1 record (b)).
   - No heartbeat → BTN1 is read as held, so the design sits in reset.
   - BTN0 does nothing but the SELFTEST opcode passes → BTN0 polarity or debounce.
7. **Power-up state.**
   - Sim with `RAND_RESET=1` covers random initial flops.
   - BRAM powers up as zero, and OBUF poisoning is on in H-5.
   - If only the first job after power-up fails, power-cycle and rerun H-4 before H-5.
8. **USB-UART link drops.**
   - Failures don't repeat with the same seed, and NACK_CRC or timeouts appear in the log → rerun the H-3 memtest.
   - The link is not the datapath.

Only after the cause is identified and the fix is re-verified in simulation (`make -C tb signoff` and `make -C tb/system SIGNOFF=1`) is a new bitstream built and the board touched again.

## H-6 — Benchmarks and KG1

| Field | Value |
| --- | --- |
| Bitstream | same as H-4/H-5 |
| Physical action | none |
| Host command | `splitsys-host --transport serial:COM__ bench bench`, then `splitsys-host --transport serial:COM__ bench sweep` |
| Expected observation | Every run bit-exact, counters equal the model; records in `results/hw/`. |
| Archive KG1 (lead runs it; fpga-integrator checks) | Run this **before any rebuild**: `s4_rebuild.sh` deletes `fpga/build/top/`. First save each step's console output to a file (the H-3, H-4 and H-5 logs; add the H-6 bench log if there is one). Then, from the repo root in Git Bash:<br>`bash fpga/tcl/archive_kg.sh KG1 top <h3 log> <h4 log> <h5 log> [<h6 log>]`<br>The script only reads `fpga/build/`. It **refuses (exit 1, writes nothing)** in these cases:<ul><li>the md5 of `fpga/build/top/top.bit` is not the md5 in the `top` row of `fpga/reports/manifest.json` (`6a85a822b28e7d9f2097a8a902d865bf`);</li><li>`fpga/reports/top/summary.json` is not pass, clean, and at the manifest's git hash;</li><li>`fpga/known_good/KG1` already exists;</li><li>a log file is missing or empty.</li></ul>Otherwise it writes `fpga/known_good/KG1/` with:<ul><li>`top.bit` (md5 checked again after the copy);</li><li>`reports/` (a copy of `fpga/reports/top/`);</li><li>`summary.json`;</li><li>`manifest_row.json`;</li><li>`git_hash.txt` = the **build** commit `52a66216`, which is what `ping` prints (not the HEAD at archive time);</li><li>`archive.txt` (archive time, HEAD at archive time, md5, where each log came from);</li><li>`logs/`.</li></ul>It then sets `fpga/known_good/CURRENT` to `fpga/known_good/KG1/top.bit` and commits only those two paths. Expected last lines: `archive_kg: committed <hash> [fpga-integrator] KG1: archive top bit (md5 6a85a822b28e7d9f2097a8a902d865bf, build 52a66216) ...` and `ARCHIVE_KG_OK KG1 top 6a85a822b28e7d9f2097a8a902d865bf`. Check: `cat fpga/known_good/CURRENT` and `git show --stat HEAD`. To inspect before committing, add `--no-commit`. Never overwrite or delete an existing KG; the next one is `KG2`. |
| Archive failure branch | `md5 ... != manifest`: `fpga/build/top/top.bit` is not the file that was tested. **Do not rebuild.** Compare it with the read-only reviewed copy `C:\Users\danie\FPGA_Projects\SplitSys_reviewed_bits\52a66216\top\top.bit` (md5 `6a85a822b28e7d9f2097a8a902d865bf`, checked 2026-10-24 13:38) and with `ping` (must print build_id 52a66216), then ask the lead. `already exists`: use the next KG number. `summary ...` errors: the reports changed after the build; stop and ask the lead. |
| Failure branch | As H-5. If only the sweep fails at some M, keep the passing bench results, record the failing M, and do not archive KG1 until the lead decides. |

## H-7 — Dashboard cold start

| Field | Value |
| --- | --- |
| Bitstream | `fpga/known_good/CURRENT` (now `fpga/known_good/KG2/top.bit`, build `38a3950a`; check with `cat fpga/known_good/CURRENT`). At the booth the board already boots this KG from QSPI flash (H-8, Booth configuration), so the program command below is the JTAG fallback, not a required step. |
| Program command | `scripts/vivado -mode batch -source fpga/tcl/program.tcl -tclargs fpga/known_good/CURRENT` (program.tcl follows the pointer file) |
| Physical action | Human: **power-cycle the board** (switch off, on), start a stopwatch. |
| Host command | 1. the program command above; 2. PowerShell: `powershell -ExecutionPolicy Bypass -File demo\start_demo.ps1 -Transport serial:COM__` (prebuilt `sw\target\release\splitsys-host.exe` required). |
| Expected observation | Within **60 s** of the power-cycle: board programmed (`PROGRAM_OK`, `DONE pin = '1'`). The start script (`demo/start_demo.ps1`) then prints, in order:<br>`host: C:\Users\danie\FPGA_Projects\Calhack2026\sw\target\release\splitsys-host.exe` (unless `SPLITSYS_HOST` is set)<br>`PING ok: build_id <B>  proto v1  via serial:COM__ ...  source hw`, where `<B>` = `git_hash.txt` in the KG directory that `fpga/known_good/CURRENT` points to (= the `top` row of `fpga/reports/manifest.json`), lowercase; with CURRENT → KG2 that is **`38a3950a`** (H-8e saw exactly this). `source hw`, never `model`. If you deliberately fell back to KG1 over JTAG, expect `52a66216` instead<br>`server pid <pid> on http://127.0.0.1:8080/`<br>`ready in <N> s. Keys: 1/2/3 scenes, Space demo, A attract, R replay, F fullscreen. Alt+F4 closes the kiosk.` (green)<br>Not expected: the yellow `PING failed. Check the USB cable / COM port ...` or the red `dashboard did not come up on http://127.0.0.1:8080/` (script exits 1). Then Edge opens in kiosk mode with dashboard Scene 1 live on the monitor, with a green `BOARD LIVE` badge and HW-labelled data, and the build_id on screen matches the CURRENT KG's `git_hash.txt` (KG2: `38a3950a`). On the board (KG2): LED15 heartbeat; RGB0/RGB1 dark; `SET_DISPLAY` text reads in the right order. Only on the KG1 fallback: RGB0/RGB1 lit at full brightness (cosmetic, unused-pin pull-up) and `SET_DISPLAY` text reversed (built before the H-1 display fix); see Board facts. |
| Failure branch | Capture: the timings of each step, the start-script console output. Likely causes: (1) programming takes most of the 60 s, or Vivado is unavailable → boot from QSPI flash instead (**H-8**); (2) PING fails → COM port changed after the power cycle (use `-Transport serial:auto` or recheck P-4); (3) dashboard shows MODEL/SIM data → wrong results directory, or the exe is older than the dashboard sources (P-5a); (4) `splitsys-host.exe not found` → run P-5a; (5) `dashboard did not come up` → port 8080 in use by an old server: close the minimized `splitsys-host` window (or PowerShell `Stop-Process -Name splitsys-host`) and rerun. |

## H-8 — Flash KG to QSPI + cold-start drill

Prepared 2026-10-24 16:30 PDT; **run and passed 16:42–17:04** (see "Session results" at the top). Run this **after KG2 is archived** (`cat fpga/known_good/CURRENT` gives `fpga/known_good/KG2/top.bit`). When this works, the board configures itself at power-up and the demo needs neither Vivado nor JTAG. The H-7 JTAG path (`program.tcl`) stays available as the fallback: JTAG works whether J14 is fitted or not. **Do not start H-8 while a host batch is running:** step H-8b first loads Vivado's SPI helper design into the FPGA, which replaces the running SplitSys design until the boot at the end.

| Field | Value |
| --- | --- |
| Bitstream | `fpga/known_good/CURRENT` → `fpga/known_good/KG2/top.bit`, build_id `0x38A3950A` (`38a3950a`), md5 `63dea71fd7e8c151f836143c8bac2b2a` (manifest row `top`). The reviewed `.bit` is used **unchanged**, with no rebuild and no re-review: at 38a3950a the project XDC already sets `BITSTREAM.Config.SPI_buswidth 4`, `CONFIG_VOLTAGE 3.3`, `CFGBVS VCCO`, `BITSTREAM.GENERAL.COMPRESS TRUE`; `CONFIGRATE` stays at the default. |
| Flash part | IC10 **MT25QL128ABA8ESF** (16 MB); Vivado part `mt25ql128-spi-x1_x2_x4`. Evidence: Board facts row "QSPI flash and boot-mode jumper". |
| Flash image | `fpga/build/flash/KG2.bin` (+ `KG2.prm`, `KG2.txt` with both md5s), written by `fpga/tcl/flash.tcl` with `write_cfgmem -format bin -interface SPIx4 -size 16 -loadbit {up 0x00000000 <bit>}`. **Expected md5 `81547a2596be6283032d9b1e3448c4ba`**, 1,315,316 bytes, address range 0x000000–0x1411F3. That md5 is from the same `.bit` before archiving (`fpga/build/flash/top.bin`, 16:23). The image is deterministic (generated twice, same md5) and equals the `.bit` minus its 131-byte header (`cmp` checked). Pre-check, no hardware involved: `scripts/vivado -mode batch -source fpga/tcl/flash.tcl -tclargs fpga/known_good/CURRENT --image-only` → `FLASH_IMAGE_OK: .../fpga/build/flash/KG2.bin`, then `md5sum fpga/build/flash/KG2.bin`. If the md5 differs, **stop**: the archived `.bit` is not the reviewed one. |
| H-8a physical action | Human: **power switch off; fit a jumper on J14** (2-pin header labelled `J14`, which ties mode pin M2 to GND); **power switch on**. The USB cable stays plugged in. |
| H-8a expected | Board power LED on. The FPGA tries to boot from the flash (blank or an old image), so it is most likely **unconfigured**: no LED15 heartbeat, display dark. This is expected at this point. |
| H-8b program command | `scripts/vivado -mode batch -source fpga/tcl/flash.tcl -tclargs fpga/known_good/CURRENT` (default mode `--program`: image, erase, blank-check, program, verify, `boot_hw_device`, DONE check) |
| H-8b expected | Console, in order:<br>`FLASH: cfgmem part mt25ql128-spi-x1_x2_x4 (Micron, 128 Mbit, spi x1_x2_x4)`<br>`FLASH: bit .../fpga/known_good/KG2/top.bit md5 63dea71fd7e8c151f836143c8bac2b2a`<br>`FLASH: image .../fpga/build/flash/KG2.bin (1315316 bytes) md5 81547a2596be6283032d9b1e3448c4ba`<br>`FLASH: mode program, operations: ERASE 1 BLANK_CHECK 1 CFG_PROGRAM 1 VERIFY 1`<br>`FLASH: program_hw_cfgmem (program) ok in <N> s` (N is roughly 30–120 s, an estimate, not measured)<br>`FLASH: after boot_hw_device DONE pin = '1'`<br>`FLASH_OK: ... written, verified, FPGA booted from flash`, exit 0.<br>Board: during the flash step it shows nothing (the helper design is running); after the boot it shows the H-4 power-up state: **LED15 heartbeat at 1 Hz, `-` on all 8 digits, LED0/LED1 off, RGB LEDs off**. |
| H-8c physical action (cold-start drill) | Human: **power switch off, wait 5 s, power switch on**, start a stopwatch. Do not run Vivado. |
| H-8c expected | Within about **2 s** of switch-on (estimate: 1.3 MB compressed bitstream, x4 bus at the default CCLK rate), the board configures from the flash by itself: **LED15 heartbeat at 1 Hz, `-` on all 8 digits, LED0/LED1 off, RGB LEDs off**. If the board's green DONE LED is present, it lights (sch p11 draws LD21 GREEN in the DONE circuit; its silkscreen position was not checked). |
| H-8d physical action | Human: **press BTN0 once**. |
| H-8d expected | **LED0 (FULL pass) and LED1 (STRIP pass) light and stay lit**, with no Vivado and no host involved (as in H-4 item 2). |
| H-8e host command | `splitsys-host --transport serial:COM__ ping` (check the COM port again after the power cycle: P-4), then the H-7 start script **without** the program step: PowerShell `powershell -ExecutionPolicy Bypass -File demo\start_demo.ps1 -Transport serial:COM__` |
| H-8e expected | `PING ok: build_id 38a3950a  proto v1` (= `fpga/known_good/KG2/git_hash.txt`). The start script prints the H-7 sequence with `build_id 38a3950a ... source hw` and reaches `ready in <N> s`; the dashboard shows `BOARD LIVE`. Record the stopwatch time from switch-on to `ready`. Optional flash check: `scripts/vivado -mode batch -source fpga/tcl/flash.tcl -tclargs fpga/known_good/CURRENT --verify-only` → `FLASH_VERIFY_OK` (this re-boots the FPGA from the flash; run it only between host sessions). |
| Failure branch | Capture: the full `flash.tcl` console (Vivado log in `fpga/build/vivado_logs/`), a photo of the board LEDs and display (including the DONE/INIT LEDs near the FPGA), the J14 position, the stopwatch time. Branches:<br>**`FLASH_FAIL: open_hw_target` / `hw_device`** → P-2 (usbipd detach) and P-3 (cable, power), then rerun.<br>**`FLASH_FAIL: create_hw_cfgmem` / `cfgmem_helper_bitstream` / `program_hw_cfgmem`** (an ID, erase, blank-check or verify error) → rerun once. If it fails again, **stop**: read the marking on IC10 against `MT25QL128ABA8ESF` and the board revision against V2I1. Do not try other cfgmem part names by guesswork. Restore the demo over JTAG (below).<br>**exit 4 `FLASH_BOOT_FAIL`** (flash written and verified, DONE low after boot) → most likely J14 is not fitted or not making contact. Power off, reseat J14, power on: the board should come up as in H-8c, with no rewrite needed. If it is still dark, run `--verify-only`.<br>**Cold start dark (H-8c)** → (1) J14 not fitted; (2) flash content wrong: `--verify-only`; (3) this board revision straps the mode pins differently from the V2I1 schematic: stop and report.<br>**Wrong build_id at H-8e** → the flash holds another image: check `fpga/build/flash/KG2.txt` and `cat fpga/known_good/CURRENT`, then rerun H-8b.<br>**Restore the demo at any time over JTAG** (works with J14 fitted or open): `scripts/vivado -mode batch -source fpga/tcl/program.tcl -tclargs fpga/known_good/CURRENT` → `PROGRAM_OK`, then continue as in H-7.<br>**Undo flash boot**: remove J14 (power off first). The board then powers up unconfigured as before, and the flash content does not matter. To also erase the image: `scripts/vivado -mode batch -source fpga/tcl/flash.tcl -tclargs fpga/known_good/CURRENT --erase` → `FLASH_ERASE_OK` (this erases the image's address range and leaves the SPI helper design in the FPGA), then run the JTAG restore command above. |

---

## KG3 (1,562,500 baud) qualification

Prepared 2026-10-24 21:46 PDT by `fpga-integrator`; **not yet run on hardware**. KG3 is the D-020 baud change only: spec commit `21dd685` sets `BAUD` 1,562,500 / `BAUD_DIV` 4 (exact at 100 MHz; 64 cycles per bit, 6.4 µs per character). From KG2 (`38a3950a`) to `21dd6850` the build inputs differ only in `rtl/gen/splitsys_pkg.sv` (`BAUD`, `BAUD_DIV`) and a comment in `fpga/xdc/urbana_splitsys.xdc`. `rtl/*.sv`, `fpga/bringup/`, `fpga/tcl/build.tcl` and the self-test ROM are byte-identical (`git diff --stat 38a3950a 21dd6850 -- rtl sw/crates/vec/out fpga/xdc fpga/bringup fpga/tcl/build.tcl`). The datapath is unchanged, so `results/cost.json` keeps the KG2 cost numbers and was not rebuilt.

**KG2 stays the demo and the fallback until every step below passes.** The board boots KG2 (115200) from QSPI flash. Every KG3 step up to Q-8 programs over JTAG, which is volatile: **a power cycle always brings back KG2 at 115200**. Do not flash or archive anything before Q-8. The Bitstream manifest table above and `fpga/reports/manifest.json` still describe KG2 and are not changed by KG3. The KG3 bitstreams have their own manifest, `fpga/reports/kg3_manifest.json` (`python fpga/tcl/manifest.py --out fpga/reports/kg3_manifest.json kg3_heartbeat_uart_echo kg3_packet_mem kg3_top`):

| Tag | Used at | build_id | git | WNS / WHS (ns) | LUT / FF / DSP / BRAM | bit md5 |
| --- | --- | --- | --- | --- | --- | --- |
| `kg3_heartbeat_uart_echo` (`fpga/build/kg3_heartbeat_uart_echo/top.bit`) | Q-1 | `0x21DD6850` | `21dd6850` | +5.145 / +0.024 | 176 / 308 / 0 / 0 | `7429e8659d6994a1363e280336b1d502` |
| `kg3_packet_mem` (`fpga/build/kg3_packet_mem/top.bit`) | optional (not in the steps; H-3-style memtest at 1,562,500) | `0x21DD6850` | `21dd6850` | +3.230 / +0.089 | 1332 / 1236 / 0 / 25 | `5ef34d4aa4421b54a1c4b41a3795cd04` |
| `kg3_top` (`fpga/build/kg3_top/top.bit`) | Q-2 .. Q-8 (KG3 source) | `0x21DD6850` | `21dd6850` | +0.473 / +0.022 | 7377 / 7928 / 96 / 26 | `94bb7160ee61aff4b7f8cb9112cd7ed9` |

Built 21:28–21:40 PDT 2026-10-24 with the canonical flow (`PHYS_OPT=AggressiveFanoutOpt POST_ROUTE_PHYS_OPT=1 GIT_HASH=21dd6850`): `"pass":true`, `"git_dirty":"false"`, 0 DRC errors, 0 latches, `kg3_top` DSP 96 (≥ 64 enforced, top = `top`). Each build log (`fpga/reports/kg3_*/build.log`) binds every `DIV_OVERRIDE` to 0. `kg3_top` binds `LEFT_IS_D1`/`AN0_IS_RIGHT` to 0 and reads the ROM (`$readmem data file ... is read successfully`; 1 RAMB18 kept in `u_selftest`). The XDC sets `UNUSEDPIN PULLDOWN`. **The divisor actually used is 4:** in the routed netlists of all three tags `u_rx/div_cnt` is 2 bits ($clog2(4)) and `u_tx/cyc` is 6 bits ($clog2(4 × 16)); the KG2 heartbeat netlist (`BAUD_DIV` 54) has 6 and 10 bits. Read-only copies: `C:\Users\danie\FPGA_Projects\SplitSys_reviewed_bits\21dd6850\<tag>\top.bit`. Against KG2 `top` (38a3950a): LUT 7,377 vs 7,389 and FF 7,928 vs 7,936 (the smaller UART counters), DSP 96 and BRAM 26 equal, WNS +0.473 vs +0.744 ns (a different placement; the worst setup path is the reset replica `rst_core_reg_rep__8`, not the UART). `results/cost.json` keeps the KG2 numbers.

**Host binary.** Every host command below passes **`--baud 1562500` explicitly**. The Windows `sw\target\release\splitsys-host.exe` (built 19:57) predates `21dd685`, so its default is still 115200. A host rebuilt at or after `21dd685` defaults to 1,562,500, and then needs **`--baud 115200`** to talk to KG2. `demo\start_demo.ps1` has no `-Baud` option yet (host-dashboard follow-up in D-020), so it talks at the exe's default baud.

| Step | Program command / physical action | Host command (Git Bash, repo root) | Expected observation | Failure branch |
| --- | --- | --- | --- | --- |
| Q-0 pre-flight | Stop every host process using COM3 (the LM recording, the dashboard: PowerShell `Stop-Process -Name splitsys-host`). Check md5s: PowerShell `Get-FileHash -Algorithm MD5 fpga\build\kg3_heartbeat_uart_echo\top.bit, fpga\build\kg3_top\top.bit` | — | md5s equal the table above. `usbipd list` shows the Urbana not attached (P-2). | md5 differs → the file on disk is not the reviewed build: compare with the read-only copy in `SplitSys_reviewed_bits\21dd6850\`. Do not rebuild without the lead. |
| Q-1 UART echo at 1,562,500 | `scripts/vivado -mode batch -source fpga/tcl/program.tcl -tclargs fpga/build/kg3_heartbeat_uart_echo/top.bit` | `splitsys-host --transport serial:COM3 --baud 1562500 echo --bytes 100000` | `PROGRAM_OK`, `DONE pin = '1'`. After the 2 s lamp test the display reads, left to right, **`0.586 dd12`** (build_id `21DD6850` reversed with the DP after the first digit, the H-1 rule; `d` is the lowercase d shape). LED15 1 Hz, LED14 on. Host: **`ECHO 100000 bytes, 0 mismatched, <ms> ms`**, exit 0. LED4 (frame error) and LED5 (FIFO overflow) stay off. Optional negative check: `splitsys-host --transport serial:COM3 --baud 115200 echo --bytes 64` must **fail** (mismatches or a timeout), which shows the bitstream is not at 115200. | Capture the console (`> q1_echo.log`) and a photo of LED3/4/5 and the display. Wrong display string → wrong bitstream (Q-0). `timeout after 0 of 100000` → the host is not at 1,562,500 (check `--baud`) or the FTDI driver refused the rate (look for a port-open or baud error). Mismatches with LED4 on → baud error at the bridge (the FT2232H is +0.72 % / −0.90 % off at this rate, inside the 2 % budget of D-014): stop and report. LED5 on → FIFO overflow in the echo top: report to the lead. **Any failure: stop KG3 here and power-cycle → KG2 at 115200.** |
| Q-2 program KG3 top | `scripts/vivado -mode batch -source fpga/tcl/program.tcl -tclargs fpga/build/kg3_top/top.bit` (JTAG, volatile; the flash still holds KG2) | `splitsys-host --transport serial:COM3 --baud 1562500 ping` | `PROGRAM_OK`, `DONE pin = '1'`. LED15 1 Hz, `-` on all 8 digits, LED0/LED1 off, RGB dark. **`PING ok: build_id 21dd6850  proto v1`**. | PING timeout → rerun Q-1 (link) before suspecting the packet layer. Wrong build_id → wrong bitstream. |
| Q-3 self-test | Press **BTN0** once: LED0 and LED1 light and stay lit. Then the host command. | `splitsys-host --transport serial:COM3 --baud 1562500 selftest --dump` | `SELFTEST FULL : PASS (fletcher32 6c1d81af)`, `SELFTEST STRIP: PASS (fletcher32 8b1c6e80)`, 0 differ in both read-backs, exit 0 (the ROM is unchanged since KG2). | As H-4 / triage T-1, with `RTL_REV=21dd6850`. |
| Q-4 SPEC §3.8 gate: 10,000 packets | none | `splitsys-host --transport serial:COM3 --baud 1562500 memtest --frames 10000 --seed 1` | **`MEMTEST PASS`**, **NACK_CRC 0**, all four region counts > 0. This is the SPEC §3.8 / D-020 gate: 10,000 packets with zero errors at the new baud, on hardware. | Any NACK_CRC, timeout or mismatch fails the gate. Capture the log; KG3 is not trusted at this baud. Do not rerun until it passes by luck: report to the lead (KG2 at 115200 stays). |
| Q-5 random GEMMs | none | `splitsys-host --transport serial:COM3 --baud 1562500 run --random 100 --mode both --seed 1` | `BATCH PASS: ... mismatches 0 counter_mismatches 0 invariant_failures 0 errors 0`. The counters count on-chip cycles, so the baud does not change them. | As H-5 / triage T-2..T-4, with `RTL_REV=21dd6850`. |
| Q-6 LM timing run (FTDI latency timer as it is) | none | `mkdir -p results/hw/logs/KG3` then `splitsys-host --transport serial:COM3 --baud 1562500 lm --tokens 8 2>&1 \| tee results/hw/logs/KG3/G5_lm_stories260k_8tok_lat16.log` | Text equals golden (`Once upon a time, there was a little girl`), 444/444 linear-layer GEMMs bit-exact, counters equal to the model. Record the wall time per step. KG2 at 115200 took **30.76 s per step** (`results/hw/logs/KG2/G5_lm_stories260k_8tok.log`); D-020 projects about 9 s (a projection, not a measurement). | Wrong text or a mismatch → as H-5 (sim reproduction first). Correct but slow → not a failure; continue. |
| Q-7 human: FTDI latency timer → 1 ms | Human (Windows): **Device Manager → Ports (COM & LPT) → USB Serial Port (COM3) → Properties → Port Settings → Advanced… → Latency Timer (msec) = 1 → OK → OK.** Write down the old value first (FTDI default 16). Close every program using COM3 before the change. | `splitsys-host --transport serial:COM3 --baud 1562500 ping`, then rerun Q-6 with the log name `G5_lm_stories260k_8tok_lat1.log` | PING ok `21dd6850`. LM text and checks as in Q-6, and the wall time per step should drop (at this baud the per-request USB turnaround dominates). The setting belongs to the COM port on this laptop, so it also applies to KG2 at 115200 (harmless). | COM3 renamed or missing after the change → recheck P-4. No speedup → record both numbers; not a failure. |
| Q-8 archive KG3, then flash (lead runs; **only if Q-1 to Q-7 all passed**) | Save the console logs to files first. Archive: `MANIFEST=fpga/reports/kg3_manifest.json bash fpga/tcl/archive_kg.sh KG3 kg3_top <q1 log> <q3 log> <q4 log> <q5 log> <q6 log> <q7 log>`. Then stop all host processes and flash: `scripts/vivado -mode batch -source fpga/tcl/flash.tcl -tclargs fpga/known_good/CURRENT` (image `fpga/build/flash/KG3.bin`). Then human: **power off, wait 5 s, power on** (J14 stays fitted). | `splitsys-host --transport serial:COM3 --baud 1562500 ping`. Dashboard: `demo\start_demo.ps1` only with a host exe whose default baud is 1,562,500 (rebuilt at or after `21dd685`, P-5a), or once the script has a `-Baud` option. | `ARCHIVE_KG_OK KG3 kg3_top <kg3_top md5 from the table>`. `cat fpga/known_good/CURRENT` → `fpga/known_good/KG3/top.bit`. `fpga/known_good/KG3/git_hash.txt` = `21dd6850`. KG1 and KG2 stay. `FLASH_OK`. After the power cycle: LED15 1 Hz and `-` on all digits within about 2 s, `PING ok: build_id 21dd6850`, dashboard `BOARD LIVE` with build `21dd6850`. | Archive `md5 ... != manifest` → **do not rebuild**: compare with the read-only copy and with `ping`, then ask the lead. Flash problems → as H-8. |

**Fallback to KG2 (115200) at any point:**
- **Before Q-8 flashes KG3:** **power-cycle the board.** It boots KG2 from flash. Every host command then uses `--baud 115200` (required with a host exe built at or after `21dd685`; the 19:57 exe already defaults to 115200). `ping` must print `build_id 38a3950a`.
- **After KG3 is in flash:** JTAG `scripts/vivado -mode batch -source fpga/tcl/program.tcl -tclargs fpga/known_good/KG2/top.bit` → `PROGRAM_OK` (volatile), host at `--baud 115200`. To make the board boot KG2 again: `scripts/vivado -mode batch -source fpga/tcl/flash.tcl -tclargs fpga/known_good/KG2/top.bit` (image md5 `81547a2596be6283032d9b1e3448c4ba`, H-8). Only the lead changes `fpga/known_good/CURRENT`. Never edit it by hand, and never delete a KG.
