sl33pinging/SplitSys/docs/ENV.md

# ENV — machine facts for SplitSys (verified 2026-10-24, toolchain-engineer)

Every fact here was observed on this laptop with the commands shown, not taken from memory.
Re-check everything with:

```
scripts/wsl 'scripts/check_env.sh'            # from Git Bash (or: scripts/check_env.sh, it re-execs in WSL)
source scripts/env.sh && scripts/check_env.sh # from a WSL shell at the repo root
scripts/check_env.sh --quick                  # skip launching Vivado (~30 s)
scripts/check_env.sh --smoke                  # also run the cocotb+Verilator smoke test
```

Last result: `ALL REQUIRED OK`, exit 0. Optional WARNs: socat, ccache, mold (wait on the sudo command below), Windows-side cargo (pre-Phase-H item).

## How to run things (read this first)

| From | Linux tools (cargo, verilator, make, cocotb) | Vivado |
| --- | --- | --- |
| Git Bash (agents' Bash tool) | `scripts/wsl '<command>'` | `scripts/vivado -mode batch -source fpga/tcl/x.tcl -tclargs ...` (or via `scripts/wsl 'vivado ...'`) |
| WSL shell at repo root | `source scripts/env.sh` once, then run normally | `vivado ...` (resolves to `scripts/vivado` after `env.sh`) |

- **`scripts/wsl '<cmd>'`** runs `<cmd>` with `bash` in WSL, `cd` to the repo root (`/mnt/c/Users/danie/FPGA_Projects/Calhack2026`), with `scripts/env.sh` sourced. The command string is base64-encoded on the Windows side, so quotes, `$`, and `/mnt/...` paths reach WSL unchanged (no `MSYS_NO_PATHCONV` needed). The exit status is preserved (`scripts/wsl 'exit 7'` returns 7); stdin is forwarded. It also works when called from inside WSL.
- **`scripts/env.sh`** (source it; idempotent, never touches rc files) exports:
  - `SPLITSYS_ROOT` (repo root), `SPLITSYS_CACHE=~/.cache/splitsys`
  - `CARGO_TARGET_DIR=~/.cache/splitsys/target`: Rust builds live on ext4, **not** in `sw/target`. Binaries are at `$CARGO_TARGET_DIR/{debug,release}/<bin>`.
  - `SPLITSYS_VENV=~/.cache/splitsys/venv`, and activates it (`VIRTUAL_ENV`, PATH)
  - `SPLITSYS_SIM_BUILD=~/.cache/splitsys/sim_build`: the suggested root for cocotb/Verilator build directories (`SIM_BUILD=$SPLITSYS_SIM_BUILD/<module>` in tb Makefiles). This keeps the slow C++ compile off `/mnt/c`.
  - `SPLITSYS_VIVADO_VERSION=2025.2.1`
  - `OBJCACHE=ccache` and `CCACHE_DIR` when ccache is installed (Verilator picks this up automatically)
  - PATH order: venv/bin, ~/.local/bin, ~/.cargo/bin, `$SPLITSYS_ROOT/scripts`, then the system PATH. The WSL PATH also carries the Windows PATH (interop `appendWindowsPath`), so `vivado` resolves to the **2025.1** install unless `env.sh` is sourced. Always source `env.sh`.
- **`scripts/wsl_keepalive start|status|stop`**: stops WSL from shutting down when idle (see Known issues). **Recommended for every session.** Run `start` once at the beginning. It is running now: at 17:09 PDT on 2026-10-24, `status` showed pid 927, with the distro up 18303 s (since about 12:04, with no idle restarts).
- **`scripts/screenshot <url> <out.png> [W,H]`**: a headless Windows Edge screenshot. See "Dashboard screenshots".

## Inventory

**Host and WSL**
- Laptop: ASUS ROG Zephyrus G14 (2025), Windows 11 Home 10.0.26200.
- WSL 2.6.1.0, kernel `6.6.87.2-microsoft-standard-WSL2`, WSLg 1.0.66. Distro **Ubuntu 24.04.3 LTS**, user `qwer`, `/etc/wsl.conf` has only `[boot] systemd=true`. No `C:\Users\danie\.wslconfig`, so networking is the default NAT with localhost forwarding.
- 24 CPUs (`nproc`), 15 GiB RAM, WSL root ext4 1007 GB with 937 GB free. `C:` (`/mnt/c`) has 160 GB free of 875 GB.

**Tools on PATH before any install** (`command -v` / `--version`)
- apt: build-essential (gcc/g++ 13.3.0), GNU Make 4.3, git 2.43.0, flex 2.6.4, bison 3.8.2, perl 5.38.2, m4, python3 3.12.3 (+venv, dev, pip), libfl-dev, zlib1g-dev, cmake, pkg-config, iverilog 12.0, gtkwave 3.3.116, node v18.19.1 / npm 9.2.0, curl, wget.
- Pre-existing under `$HOME` (not installed by us): `~/.local/bin/uv` 0.9.21, `~/.local/bin/z3` 5.1.0 (Verilator's configure picked it up as its constraint solver), `~/.local/bin/python3.12`.
- Rust: rustup stable 1.99.1 with clippy and rustfmt in `~/.cargo` (installed earlier by the lead; verified, not reinstalled).
- `/usr/local/bin`: `openFPGALoader`, `magic`, `netgen`, `xschem`, `ext2sim`, `ext2spice`, `rawtovcd`. There is **no `/usr/local/bin/vivado` wrapper** (CLAUDE.md assumed one; `scripts/vivado` replaces it). `/opt` is empty.
- `~/oss-cad-suite` (2026-08-18 bundle, **not on PATH**) has yosys, nextpnr-*, iverilog, and a *devel* Verilator 5.051 (`rev v5.050-196`). Keep it off PATH: it would shadow our pinned Verilator.
- Missing: autoconf, automake, help2man, ccache, mold, libgoogle-perftools-dev, numactl, socat, unzip, any Linux Chromium or Playwright. apt's verilator candidate is only 5.020, which is too old for cocotb 2.1.0.

**Other `$HOME` contents (existence noted only, not opened; hackathon rule):** `~/6205_python`, `~/eda`, `~/workspace`, `~/downloads`, `~/src` (ours, see below), `~/openFPGALoader` (source checkout), `~/vivado-boards` (`new/board_files/zedboard`, `old/board_parts`; no Urbana board files). Under `C:\Users\danie\FPGA_Projects` there are old projects (`18240`, `lab01`..`lab04`, `Mini_GPU`, `Simple_CPU`, `Syetemverilog_CPU`, `Projects`, a few loose `.sv`/`.bit` files). **None of their code was opened or copied.**

**Windows side (read-only)**
- `C:\Xilinx`: `2025.1`, `2025.2.1`, `DocNav`, `Downloads`, `xic`.
- The Vivado user init script `C:\Users\danie\AppData\Roaming\Xilinx\Vivado\Vivado_init.tcl` runs on **every** Vivado launch. Its single line is `set_param board.repoPaths [list "//wsl.localhost/Ubuntu-24.04/home/qwer/vivado-boards/new/board_files"]`. It adds a board repo on a `\\wsl.localhost` UNC path, which has no Urbana board file. Vivado reports critical warnings about that repo; `fpga-integrator` silences them in `fpga/tcl`. `scripts/vivado` needs no change. The file was not modified.
- Microsoft Edge: `C:\Program Files (x86)\Microsoft\Edge\Application\msedge.exe`. Chrome: `C:\Program Files\Google\Chrome\Application\chrome.exe`.
- usbipd-win 5.3.0 at `C:\Program Files\usbipd-win\usbipd.exe`.
- Windows Rust: `where.exe cargo rustup` finds nothing. **Not installed** (see USB strategy).
- Windows Python 3.13 and nvm/node exist on the Windows PATH (not used by the project).

## Installed (what and how). All user-level, no sudo.

| What | How | Where |
| --- | --- | --- |
| autoconf 2.72 | `scripts/setup_env.sh autotools` (GNU tarball, `./configure --prefix=~/.local`) | `~/.local/bin/autoconf`, source in `~/src/autoconf-2.72` |
| help2man 1.49.3 | same | `~/.local/bin/help2man` |
| **Verilator 5.052** (tag `v5.052`, 2026-09-05, the latest stable tag on GitHub at setup time) | `scripts/setup_env.sh verilator`: git clone, checkout tag, `autoconf && ./configure --prefix=$HOME/.local && make -j24 && make install`. Build log: `~/.cache/splitsys/verilator_build.log` | `~/.local/bin/verilator`, `~/.local/share/verilator`; source `~/src/verilator` |
| Python venv (python 3.12.3) with cocotb 2.1.0, pytest 9.1.1 | `scripts/setup_env.sh venv` (`pip install -r scripts/requirements.txt`) | `~/.cache/splitsys/venv` |
| rust-std for `x86_64-pc-windows-msvc` (WSL-side rustup target, 23.6 MB) | `rustup target add x86_64-pc-windows-msvc`. Lets WSL type-check the host for Windows (`cargo check --target x86_64-pc-windows-msvc`). It cannot link Windows binaries. | `~/.rustup` |

**Venv decision:** the venv is at `~/.cache/splitsys/venv` (ext4), not `.venv/` on `/mnt/c`, for import and build speed. `env.sh` activates it. `.venv/` is unused (and gitignored).

Verilator was configured before the optional apt packages arrived, so it has no tcmalloc and no mold. That costs only some speed. Do **not** rebuild it mid-event (it works). ccache *is* used at simulation time once installed, via `OBJCACHE`.

Recreate everything: `scripts/setup_env.sh` (steps `rust verilator venv`; each skips what already exists).

## Versions (pinned)

| Tool | Version | Pin location |
| --- | --- | --- |
| rustc / cargo | 1.99.1 stable (clippy 0.1.99, rustfmt 1.10.0) | rustup default `stable-x86_64-unknown-linux-gnu`. Do not `rustup update` mid-event. |
| Verilator | 5.052 | `VERILATOR_TAG` in `scripts/setup_env.sh` |
| cocotb | 2.1.0 | `scripts/requirements.txt` |
| cocotb's minimum Verilator | **5.036** ("cocotb supports Verilator 5.036+", https://docs.cocotb.org/en/v2.1.0/simulator_support.html) | enforced by `check_env.sh` |
| pytest | 9.1.1 | `scripts/requirements.txt` |
| matplotlib / numpy / pillow | 3.9.2 / 2.5.4 / 13.0.0 (installed by demo-storyteller for `results/plots/make_plots.py`; `check_env` requires matplotlib 3.9.2) | `scripts/requirements.txt` (a fresh venv from it gives an identical `pip freeze`) |
| Python | 3.12.3 | system python3 (venv base) |
| Vivado | **2025.2.1** (64-bit), batch mode verified | `SPLITSYS_VIVADO_VERSION` in `scripts/env.sh` |
| iverilog | 12.0 (apt, optional) | |

cocotb 2.x notes for testbench authors: use `COCOTB_TOPLEVEL` / `COCOTB_TEST_MODULES` in Makefiles (the 1.x names `TOPLEVEL`/`MODULE` are deprecated), `Clock(dut.clk, 10, unit="ns")` (`unit`, not `units`), and `cocotb.start_soon(...)`. `scripts/smoke_cocotb.sh` is a minimal working example of all three.

## Vivado path rules

**Chosen: Vivado 2025.2.1** at `C:\Xilinx\2025.2.1\Vivado\bin\vivado.bat`. It is the version CLAUDE.md names, it runs in batch mode, and it has the target part. 2025.1 is also installed and is a fallback (`SPLITSYS_VIVADO_VERSION=2025.1 scripts/vivado ...`), but it was not smoke-tested.

**Smoke test** (`scripts/vivado -mode batch -source scripts/vivado_smoke.tcl`, about 30 s, exit 0):
```
SMOKE_VERSION: 2025.2.1
SMOKE_PARTS: xc7s50csga324-1 xc7s50csga324-1IL xc7s50csga324-1Q xc7s50csga324-2 xc7s50fgga484-1 ... xc7s50ftgb196-2
SMOKE_OK xc7s50csga324-2
```
So `xc7s50csga324-2` exists. The csga324 speed grades available are -1, -1IL, -1Q, and -2. The grade on the physical board still has to be confirmed against its marking or the RealDigital docs in Phase H. CLAUDE.md says -2.

**`scripts/vivado` rules** (it works the same from Git Bash and WSL):
1. Vivado is a Windows program, started as `cmd.exe /d /c C:\Xilinx\2025.2.1\Vivado\bin\vivado.bat <args>`. Its working directory must be on `C:`. If you call it from a WSL-only directory (`/tmp`, `~`), the script `cd`s to the repo root first.
2. **Prefer repo-relative paths with forward slashes** (`fpga/tcl/build.tcl`). Vivado's Tcl accepts `/` on Windows.
3. Absolute `/mnt/c/...` (WSL) or `/c/...` (Git Bash) arguments are rewritten to `C:/...`. Absolute paths that exist only in WSL (`/home/...`, `/tmp/...`) are **rejected** (exit 2). Vivado on `\\wsl.localhost\...` UNC paths is unreliable, so keep every Vivado input and output under the repo. Inside Tcl, derive paths from `[file dirname [info script]]`, not from WSL paths.
4. No spaces or cmd metacharacters (`& | < > ^ %`) in any argument (rejected, exit 2), because cmd.exe re-parses the command line.
5. Unless you pass `-log/-journal/-nolog/-nojournal`, logs go to `fpga/build/vivado_logs/vivado_<stamp>.{log,jou}` (gitignored), not the cwd. `-version` gets no log flags.
6. The exit code propagates: Tcl `exit 3` gives `scripts/vivado` exit 3 (tested from WSL with `-tclargs foo bar`, and `$argv` arrived as `foo bar`).
7. `scripts/vivado --which` prints the `.bat` that would run.
8. Inside WSL after `source scripts/env.sh`, plain `vivado` is `scripts/vivado`, so the canonical commands in CLAUDE.md (`vivado -mode batch -source fpga/tcl/build.tcl -tclargs <tag>`) work as written from the repo root.

## Board files and XDC

**Found:** the RealDigital Urbana master XDC.
- **Origin:** `C:\Users\danie\Downloads\Urbana.xdc` (WSL: `/mnt/c/Users/danie/Downloads/Urbana.xdc`), 24993 bytes, 468 lines, mtime 2026-03-04, md5 `efdc408b5aab32e8ff03770e47cd6c47` (CRLF original). Header: `# URBANA BOARD CONSTRAINTS V2I1 1/3/2023`. It covers every board resource (100 MHz clock, switches, LEDs, buttons, RGB LEDs, two 7-segment displays, HDMI, USB host, SD, audio, analog, UART + BLE UART, servo, PMODs, DDR3).
- **Copied verbatim** to `fpga/xdc/urbana_master.xdc`. Git normalizes it to LF on commit (`.gitattributes`); the content is otherwise unchanged.
- The same folder holds the schematic `C:\Users\danie\Downloads\Urbana_V2I1_SCH_2023-01-03.PDF` (plus two duplicate downloads). It was not copied; read it in place when needed.
- Facts read from the file: clock `CLK_100MHZ` on **N15** LVCMOS33 (its `create_clock` line is commented out and names port `clk_100MHz`). USB-UART lines: the master's port names are `UART_TXD` on B16 and `UART_RXD` on A16 (LVCMOS33). **These names are from the USB bridge's side, not the FPGA's; see the table below.** Switches use LVCMOS25, LEDs LVCMOS33. `CFGBVS VCCO`, `CONFIG_VOLTAGE 3.3`, `SPI_buswidth 4`.

### Board facts (copied from `docs/HW_CHECKLIST.md`, owner `fpga-integrator`; that file is authoritative)

`fpga-integrator` extracted these from the master XDC and the schematic `C:\Users\danie\Downloads\Urbana_V2I1_SCH_2023-01-03.PDF` (19 pages, V2I1). The PDF's embedded net/pin annotations were read with pypdf text extraction; the pages were not rendered. "sch pN" means schematic page N, and "master:N" means line N of `fpga/xdc/urbana_master.xdc`.

| Fact | Value | Evidence |
| --- | --- | --- |
| Clock | 100 MHz on FPGA N15 | master:2–4; sch p11: oscillator IC16 `ASEM1-100.000MHZ` → buffer IC15 → net `CLK_100MHZ` → N15 |
| USB-UART direction | **FPGA receives on B16, transmits on A16.** The master-XDC names are from the FTDI's side. | sch p12: B16 = net `UART_TXD`, A16 = net `UART_RXD`. sch p10: `UART_TXD` = FT2232HQ (IC6) pin 38 = BDBUS0, `UART_RXD` = pin 39 = BDBUS1. Channel A pins 16–19 are JTAG, so channel B is the UART, where BDBUS0 = TXD (FTDI output) and BDBUS1 = RXD (FTDI input). Project XDC: port `UART_RXD` → B16, `UART_TXD` → A16. |
| Buttons BTN0–3 | **Active high** (pressed = 1), external 10k pull-down | sch p4: R60–R63 pull-downs, R43/R47/R52/R57 series. FPGA pins J2/J1/G2/H2 (sch p13, master:48–51). |
| LEDs LD0–15 | **Active high** | sch p4: net LDn → 330R → LED anode; cathodes to GND. |
| 7-seg anodes D0/D1_AN | **Active low** | sch p4: each AN net drives the base of a PNP (MBT3906DW1) high-side switch through 1.5k; the master XDC also says "Active LOW". |
| 7-seg segments D0/D1_SEG | **Active low**, SEG[0..7] = A, B, C, D, E, F, G, DP | sch p4: SEG nets → 100R → cathodes of the common-anode KW4-281ASB. |
| Which display is left; which AN is the leftmost digit | **D0 is the LEFT display; AN[0] is the LEFTMOST digit of each display** (AN[3] the rightmost) | **Measured at H-1** (2026-10-24, build 52a66216: `heartbeat_uart_echo` showed `6.126 6A25` for 0x52A66216). The schematic cannot tell this (layout). RTL defaults `LEFT_IS_D1 = 0`, `AN0_IS_RIGHT = 0` since dc1dea0; bitstreams built at 52a66216 (incl. KG1) still have the old assumption (D1 left, AN[3] leftmost). Details: docs/HW_CHECKLIST.md Board facts. |
| QSPI flash and boot mode | Flash IC10 = **Micron MT25QL128** (MT25QL128ABA8ESF, 3 V, 128 Mbit = **16 MB**). Vivado cfgmem part **`mt25ql128-spi-x1_x2_x4`** (the `-qspi-` names are Zynq-only). **Jumper J14 fitted = Master SPI (boots from flash at power-up); J14 open = JTAG (the board's default).** JTAG programming works in both positions. **KG2 is in the flash (H-8, Sat 2026-10-24) and the board boots from it in about 1 s**; cold start to dashboard takes about 2 s. | sch p11 (IC10, mode table "Master SPI 001, JTAG 101 Default", J14 on M2). `get_cfgmem_parts *mt25ql128*`. H-8: `results/hw/logs/KG2/H-8_flash_program.log` (`program_hw_cfgmem ok in 34 s`, `DONE pin = '1'`, `FLASH_OK`, image md5 `81547a2596be6283032d9b1e3448c4ba`). Flash commands and the undo steps: docs/HW_CHECKLIST.md H-8. |

**UART direction: confirmed on hardware at H-2** (2026-10-24, COM3, build 52a66216). With the default pins (FPGA RX = B16, TX = A16) a 10,000-byte echo and a 100,000-byte soak both came back with 0 mismatched bytes. The FTDI pin-direction step in the table, which was from memory of DS_FT2232H, is therefore settled. The swapped-pin fallback bitstream was not needed and has been retired. Source: docs/HW_CHECKLIST.md H-2 row.
- **Vendor-file quirks (do not "fix" the master; handle them in the project XDC):** every `set_property` line is *active* (318 of them, none commented out), so a project XDC must use only the needed lines. HDMI lines use the misspelled IOSTANDARD `TDMS_33` (Vivado's name is `TMDS_33`). There is a port typo `HDMI_DO_P` (letter O) and a port name with a hyphen, `HDMI_I2C-SDA`. The header says V2I1. Confirm against the board silkscreen in Phase H.

**Searches run (bounded, read-only):**
```
find $HOME -maxdepth 4 (prune .cache .cargo .rustup src) \( -iname '*urbana*' -o -iname '*.xdc' -o -iname '*board*' \)
find ~/vivado-boards -maxdepth 6 \( -iname '*urbana*' -o -iname '*.xdc' \)
find /mnt/c/Xilinx -maxdepth 6 \( -iname '*urbana*' -o -iname '*realdigital*' \)
find /mnt/c/Users/*/{Downloads,Documents,Desktop} /mnt/c/Users/*/OneDrive/{Documents,Desktop} -maxdepth 4 \( -iname '*urbana*' -o -iname '*.xdc' \)
find /mnt/c/Users/danie/FPGA_Projects -maxdepth 3 (prune Calhack2026) \( -iname '*urbana*' -o -iname '*.xdc' \)
```
Other candidates found and **not used**: `Downloads/Boolean240.xdc` and `Downloads/boolean_original.xdc` (Boolean board, a different board), `Downloads/pwm_servo_control.xdc` (a project file), openFPGALoader `spiOverJtag/constr_*.xdc` (generic), and `FPGA_Projects/{lab01,lab02}/xdc/top_level.xdc` (coursework derived from the Urbana file; not opened beyond line 1, not copied). There are no Urbana Vivado board files in `/mnt/c/Xilinx` or `~/vivado-boards`. They are not needed, because the project uses the part number plus the XDC.

## Dashboard screenshots

Use **Windows-side headless Edge**. No Linux browser and no sudo needed.
```
scripts/screenshot http://127.0.0.1:8080/ results/plots/scene1.png 1920,1080
```
- Verified: `python3 -m http.server 8765 --bind 127.0.0.1` in WSL gives HTTP 200 from Windows `curl` (WSL2 localhost forwarding works). Edge rendered it to a 1920x1080 PNG, from both Git Bash and WSL.
- Options: `--timeout-s N` sets a hard timeout (default 30 s; on expiry, exit 1). `--budget-ms N` gives page JS N ms of *virtual* time before the shot. `--kill-stale` kills leftover headless Edge processes from older runs, then exits.
- **Do not use `--budget-ms` on pages that keep a connection open (SSE, WebSocket, long-poll).** Edge's virtual time does not advance while a fetch is pending, so Edge never takes the shot and keeps running. Reproduced with an SSE test page: with the budget there was no PNG and 16 msedge.exe processes were left behind; without it the PNG was written in about 2 s. Without a budget, the shot is taken at page load. For an SSE dashboard, the first event had already rendered ("tick 0"). On a static page, `--budget-ms 5000` correctly waited for a 2 s JS timer.
- Process hygiene: every run uses its own profile directory, `%TEMP%\splitsys_edge_headless\run_<time>_<pid>_<rand>`. After success, failure, or timeout, the script kills **only** the `msedge.exe` processes whose command line contains that run's directory (found with PowerShell `Get-CimInstance Win32_Process`). Concurrent runs do not interfere. `scripts/screenshot --kill-stale` kills any process using a `splitsys_edge_headless*` profile. Use it only when no other screenshot run is in flight.
- Raw command, if needed: `"C:\Program Files (x86)\Microsoft\Edge\Application\msedge.exe" --headless=new --disable-gpu --hide-scrollbars --no-first-run --user-data-dir=%TEMP%\splitsys_edge_headless\run_X --window-size=1920,1080 --screenshot=C:\path\out.png http://127.0.0.1:8080/`
- Gotchas: `--user-data-dir` is required (without it, Edge hands off to the running browser instance and writes nothing). The `msedge.exe` launcher can return at once while the browser keeps running, so the script polls for the PNG until its size is stable, not for the launcher. The output must be on `C:` (any repo path works).
- Playwright and Linux Chromium were **not** installed. They would need sudo for system libraries.

## USB strategy

**In use: (b), confirmed in Phase H.** Build and run `splitsys-host` natively on Windows against the board's COM port. Windows Vivado programs over JTAG (or the board boots KG2 from QSPI flash with J14 fitted; see Board facts). Nothing moves between WSL and Windows during the demo.
- Windows-side Rust is **installed and the host build is verified** (next section).
- **COM port facts seen in Phase H:** the board's USB bridge is an **FT2232H, VID:PID 0403:6010**. **Channel B = UART = COM3** on this laptop (its PnP DeviceID is `FTDIBUS\...B\0000`), and **channel A = JTAG** (used by Vivado's hw_server). `usbipd list` shows the device as **Shared**, not Attached. That is correct for (b): Windows keeps the device. Only strategy (a) would need `usbipd attach --wsl`. COM numbers are per machine, so on another laptop use `serial:auto` or check Device Manager.
- Strategy (a) fallback: usbipd-win 5.3.0 is installed (`usbipd.exe` present), so `usbipd attach --wsl` is available if (b) fails. Attaching takes the device away from Windows (COM3 and Vivado JTAG disappear), so run `usbipd detach` before going back to (b) (docs/HW_CHECKLIST.md P-2).

## Windows host build (USB strategy b)

**Status: verified in Phase H (2026-10-24).** Windows rustup is installed with toolchain **`1.99.1-x86_64-pc-windows-msvc`** (the same pin as WSL). `scripts\win_build_host.ps1` builds `sw\target\release\splitsys-host.exe` with the MSVC linker; a release build takes **about 52 s**. The host ran every Phase H step over `serial:COM3`. The subsections below are the pre-install check and the install steps, kept for rebuilding on another machine.

### What the Windows side had before the install (read-only check, 2026-10-24)
- **Rust: absent at the time** (installed since; see Status above). No `cargo`, `rustup`, or `rustc` on PATH, and no `%USERPROFILE%\.cargo` or `%USERPROFILE%\.rustup`.
- **MSVC: present.** `vswhere.exe` reports **Visual Studio Build Tools 2026** (18.2.11415.280) at `C:\Program Files (x86)\Microsoft Visual Studio\18\BuildTools`. It has the workload `Microsoft.VisualStudio.Workload.VCTools` ("Desktop development with C++") and the component `VC.Tools.x86.x64`. `link.exe` is at `...\BuildTools\VC\Tools\MSVC\14.50.35717\bin\Hostx64\x64\link.exe`. `cl`/`link` are not on the normal PATH, which is expected: rustc finds them through the VS installer.
- **Windows SDK: present.** Component `Windows11SDK.26100`, and `C:\Program Files (x86)\Windows Kits\10\Lib\10.0.26100.0\{um,ucrt}\x64\{kernel32,ucrt}.lib` exist.
- No MinGW gcc. C: has 150 GB free.

### Toolchain choice: MSVC (`1.99.1-x86_64-pc-windows-msvc`)
The C++ build tools and the SDK are already installed, so the MSVC toolchain needs **no** Visual Studio download. Only rustup and Rust itself are needed. The GNU toolchain would not save anything: its rustc archive alone is 103 MB against 77 MB for MSVC, and it is the less common Windows target. It stays a fallback (below). The version is pinned to **1.99.1**, the same as WSL, because CLAUDE.md forbids upgrading toolchains mid-event. `splitsys-host`'s dependency tree (serde, serde_json, clap, serialport with default features off, windows-sys) has **no C code** (`cc` is not in `Cargo.lock`), so only the linker matters.

Verified from WSL: `cargo check --locked --release -p splitsys-host --target x86_64-pc-windows-msvc` passes. The Windows code paths, including serialport's, type-check. Linking was later verified natively on Windows (Status above).

### Steps for the human (one time; done on this laptop)
1. Download `https://static.rust-lang.org/rustup/dist/x86_64-pc-windows-msvc/rustup-init.exe` (12.7 MB).
2. In PowerShell, from the download folder:
   `.\rustup-init.exe -y --profile minimal --default-toolchain 1.99.1-x86_64-pc-windows-msvc`
   It downloads about **111 MB** (measured archive sizes: rustc 77.1 MB, rust-std 23.6 MB, cargo 9.9 MB), so about **124 MB** in total with rustup-init. That takes well under a minute on a fast link and a few minutes on venue Wi-Fi. Unpacking adds roughly 1–3 minutes (Defender scanning; an estimate, not measured), and it uses several hundred MB of disk. rustup adds `%USERPROFILE%\.cargo\bin` to the user PATH; that is its only system change.
3. Open a **new** PowerShell window (to get the new PATH) and run:
   `powershell -NoProfile -ExecutionPolicy Bypass -File C:\Users\danie\FPGA_Projects\Calhack2026\scripts\win_build_host.ps1`
   This runs `cargo build --release --locked -p splitsys-host` in `C:\Users\danie\FPGA_Projects\Calhack2026\sw` with `CARGO_TARGET_DIR=sw\target`. It fetches 43 crates (7.8 MB, measured with `cargo fetch --target x86_64-pc-windows-msvc`). It then checks that `sw\target\release\splitsys-host.exe --help` and `--version` run, and prints the COM ports it sees. Expected: a cold release build in roughly 1–3 minutes. That is an estimate; the WSL `cargo check` of the same tree took 17 s. It ends with `OK: ...splitsys-host.exe`.
   - **CARGO_TARGET_DIR = `sw\target`** on purpose. It is NTFS and native for Windows, it is gitignored, and it is exactly where `demo\start_demo.ps1` looks for the binary. The WSL side builds into `~/.cache/splitsys/target`, so the two never share build artifacts.
   - If cargo is missing, the script exits 2 and prints the install steps. If linking fails with `link.exe not found`, the VS C++ workload is broken: in the VS Installer, *Modify* Build Tools 2026, then *Desktop development with C++*. That should not be needed; it is installed.
   - GNU fallback, only if MSVC linking fails: `rustup toolchain install 1.99.1-x86_64-pc-windows-gnu --profile minimal` (about 150 MB), then `cd sw; cargo +1.99.1-x86_64-pc-windows-gnu build --release --locked -p splitsys-host`. It ships its own MinGW linker parts (`rust-mingw`).
4. Optional board check once the board is plugged in: `scripts\win_build_host.ps1 -Ping`, or `-Ping -Transport serial:COM5`.

### Finding the COM port
- `splitsys-host --transport serial:auto ping` uses the port if exactly one exists. With zero or several, it fails and prints every port as `COMn (USB vid:pid product)`.
- Device Manager → *Ports (COM & LPT)* → "USB Serial Port (COMn)". PowerShell: `[System.IO.Ports.SerialPort]::GetPortNames()`, or `Get-CimInstance Win32_PnPEntity | Where-Object Name -match 'COM\d+' | Select-Object Name, DeviceID`.
- The Urbana's FT2232H has two channels. Per the schematic, channel A is JTAG and **channel B is the UART**. If Windows shows **two** COM ports for the board, `serial:auto` refuses. Pick channel B: its FTDI `DeviceID` usually ends in `B` (for example `FTDIBUS\VID_0403+PID_6010+...B\0000`). **Seen in Phase H on this laptop:** VID/PID 0403:6010, channel B = COM3 with DeviceID `FTDIBUS\...B\0000`, and channel A = JTAG (see USB strategy). If Vivado's JTAG driver claims channel A, only one COM port appears.
- Close PuTTY or any other program holding the port before running the host. Only one program can open a COM port at a time.

### Running the demo (`demo\start_demo.ps1`, owner host-dashboard)
`powershell -NoProfile -ExecutionPolicy Bypass -File demo\start_demo.ps1 [-Transport serial:COM5] [-Port 8080] [-Replay results\hw] [-Attract] [-NoBrowser]`, or double-click `demo\start_demo.bat`, which takes an optional `serial:COM5` argument. What it does:
1. Uses `$env:SPLITSYS_HOST` if set, else `sw\target\release\splitsys-host.exe`, else `sw\target\debug\...`. It does not build: build first with step 3.
2. Runs `ping` on the transport (default `serial:auto`). A failure is only a warning, which suggests the COM port or `-Replay results\hw`.
3. Starts `splitsys-host --transport <T> --results results serve --port <P>` minimized, and waits up to 15 s for `http://127.0.0.1:<P>/api/state`.
4. Opens Edge in kiosk mode (`--kiosk`, profile `%TEMP%\splitsys_kiosk`). Alt+F4 closes it. The server process keeps running until it is closed.

## Sudo request (one command, optional)

The lead has already sent this. Nothing *required* waits on it:
```
sudo apt-get update && sudo apt-get install -y autoconf automake help2man ccache mold libgoogle-perftools-dev numactl socat unzip
```
It provides: `socat` (handy for cosim debugging; `check_env` marks it OPTIONAL), `ccache` (faster repeated Verilator C++ builds, auto-enabled by `env.sh`), and `unzip`. autoconf and help2man are already user-built in `~/.local`. No other sudo packages are needed.

## Known issues

- **WSL shuts itself down when idle, which kills every WSL process and wipes `/tmp`.**
  - **Evidence:** `journalctl --list-boots` shows 5 boots between 09:08 and 11:32 on 2026-10-24, with gaps of 2–18 min between them (boot end/start: 10:52:46/10:54:17, 11:00:32/11:18:26, 11:23:00/11:26:29, 11:30:14/11:32:14). Each boot's journal ends abruptly, with no systemd shutdown sequence and no kernel panic. The last line is `Operation canceled @p9io.cpp:258 (AcceptAsync)`, which is the host tearing down the VM's file-share channel. The pattern fits WSL's documented idle shutdown, though the journal cannot prove the trigger: a distro with **no `wsl.exe` client** for `instanceIdleTimeout` (`.wslconfig` `[general]`, default **15000 ms**) is terminated, then the VM after `vmIdleTimeout` (`[wsl2]`, default **60000 ms**). Source: learn.microsoft.com/windows/wsl/wsl-config. Agents call WSL in short `wsl.exe` bursts, so gaps of more than about 15 s between calls let it shut down. **A distro-only restart was caught directly:** inside one kernel boot, `journalctl -b 0` shows `systemd[1]: Startup finished` at 11:32:15, then `AcceptAsync` canceled and a second `Startup finished` at 11:32:48. That came after a gap of about 30 s between two of my calls, so it was the distro being terminated, not the VM. Hence `uptime`/`boot_id` alone miss distro restarts; use the systemd PID 1 age (`ps -o etimes= -p 1`), which `scripts/wsl_keepalive status` prints. Keepalive check: it started at 11:33:43, I made no WSL calls for 130 s, and afterwards the same keepalive pid was alive with no new `Startup finished`. Other agents' WSL calls during that window cannot be excluded, so this is supporting evidence, not proof. Detached Linux background processes (`nohup … &`) do **not** count as activity and die with it.
  - **Mitigation (repo-side, no Windows config change):** run `scripts/wsl_keepalive start` once per session (Git Bash or WSL; idempotent). It launches a hidden, detached Windows `wsl.exe` client (PowerShell `Start-Process`) running `sleep infinity` under the name `splitsys-keepalive`, and that open client keeps the distro from counting as idle. Use `scripts/wsl_keepalive status` to check (prints the pid, boot time, and boot_id) and `scripts/wsl_keepalive stop` to end it. The keepalive itself dies with `wsl --shutdown` or a Windows reboot, so run `start` again after either.
  - **Permanent fix (the human's choice, Windows side, not applied):** create `C:\Users\danie\.wslconfig` (it does not exist today) with
    ```
    [general]
    instanceIdleTimeout=-1
    ```
    (`-1` = "disable auto shutdown" per the docs; this key is documented but not tested on this WSL 2.6.1). It takes effect only after `wsl --shutdown`, which kills all running WSL work, so apply it at a quiet moment. Running WSL distros also keep the VM up, so `vmIdleTimeout` does not need changing.
  - **Rule for everyone:** never keep anything in `/tmp` that must survive between calls (sim outputs, logs, servers' state, scratch repos). Use `~/.cache/splitsys/` (ext4, persistent) or the repo. Single-call temp dirs, like `scripts/smoke_cocotb.sh`'s `mktemp`, are fine. A long simulation or server started in WSL must be started from a call that stays open, or with the keepalive running.
- **WSL PATH includes Windows PATH.** Without `source scripts/env.sh`, `vivado` is Vivado **2025.1**, and Windows tools (`make` from ezwinports, Git's `usr/bin`) sit at the end of PATH. Always source `env.sh` (`scripts/wsl` does it for you).
- **Builds on `/mnt/c` are slow** (drvfs). Keep build outputs under `~/.cache/splitsys` (`CARGO_TARGET_DIR`, `SPLITSYS_SIM_BUILD`). Sources stay in the repo on `C:` so Windows Vivado can read them.
- A cocotb+Verilator smoke run takes about 30 s, mostly Verilator's C++ compile. ccache will help once installed.
- Vivado batch startup is about 30 s per launch. Batch several steps into one Tcl run.
- cmd.exe prints `UNC paths are not supported` if a Windows program is started from a WSL-only cwd. `scripts/vivado` and `scripts/screenshot` avoid this by using a `C:` cwd.
- Twice, early in setup, stdout from a `scripts/wsl` call was missing from the agent tool output when that call was chained with other Windows commands in the same Bash invocation. It did not reproduce in isolation (10+ reruns). If output looks truncated, rerun the `scripts/wsl` call alone and trust its exit code. Related: the agents' Bash tool appears to show **only stderr** when a command's overall exit status is non-zero. This was seen again with a failing heredoc. End diagnostic chains with `; true`, or print `rc=$?`, if you need the stdout.
- `C:` has 160 GB free. Vivado runs under `fpga/build/` are fine, but do not keep many full runs.
