sl33pinging/SplitSys/demo/screens/disconnected.png

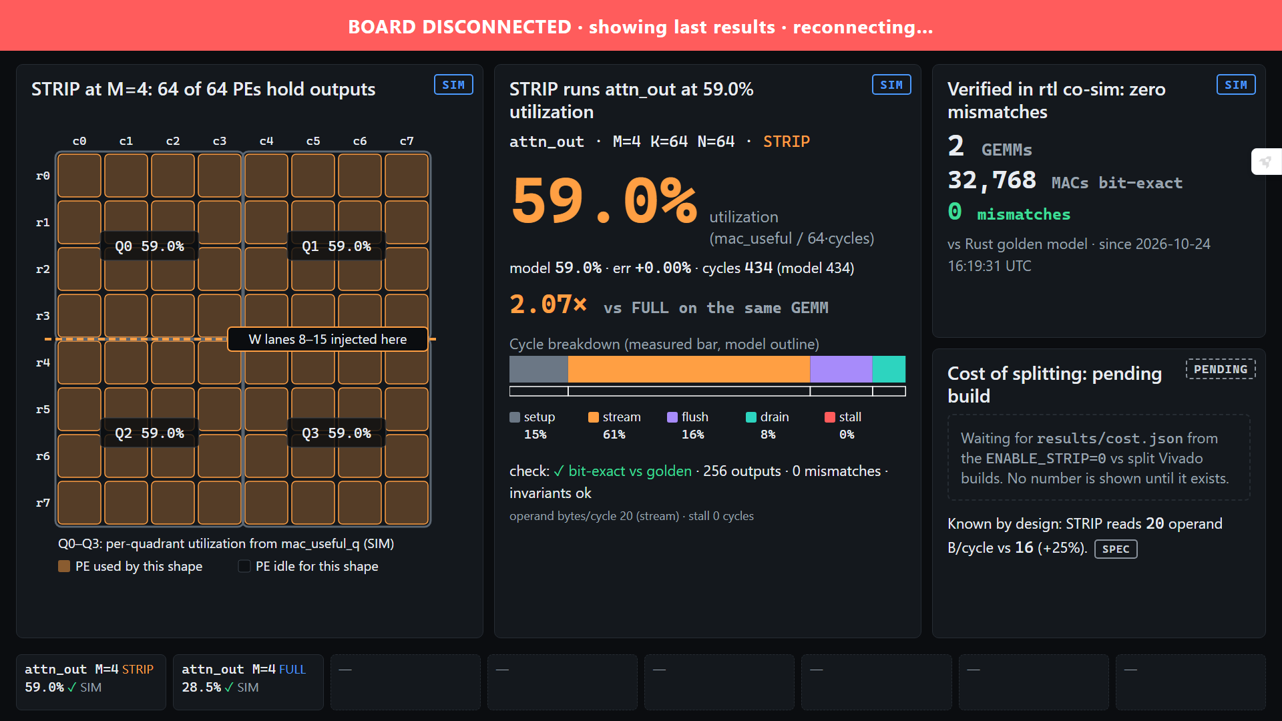
demo/screens/disconnected.png
