sl33pinging/SplitSys/demo/screens/scene1.png

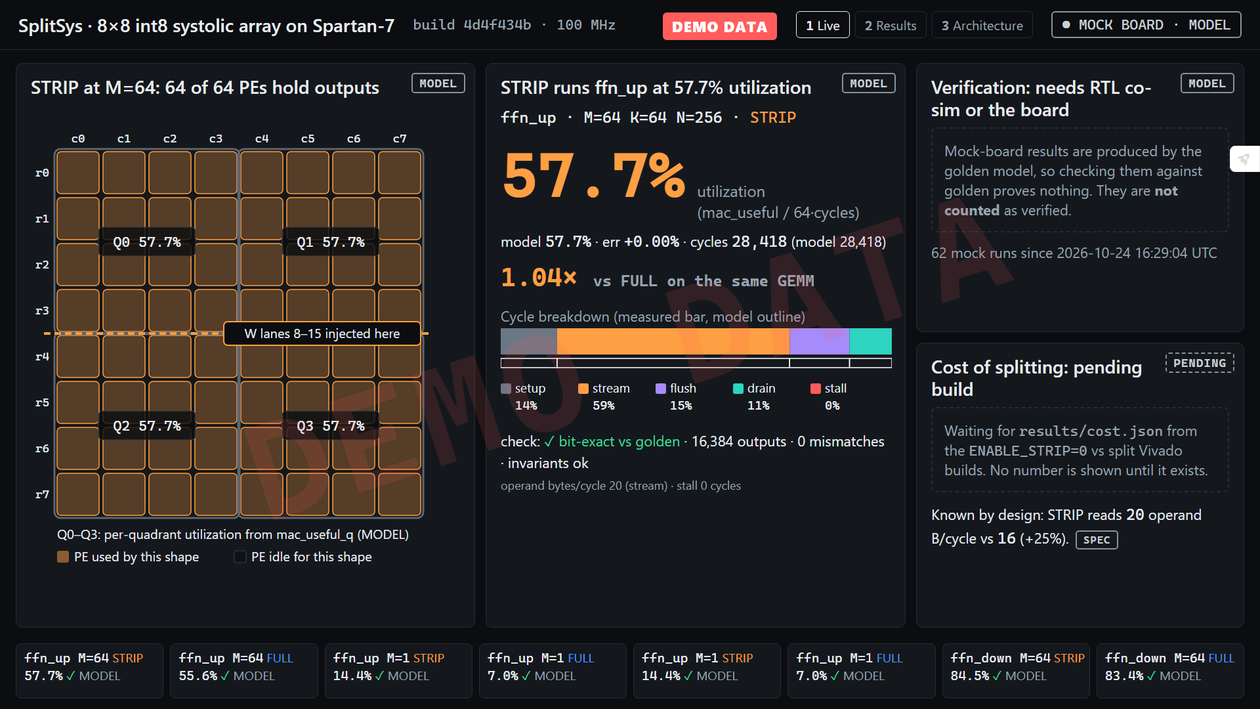
demo/screens/scene1.png
