sl33pinging/SplitSys/demo/screens/scene2.png

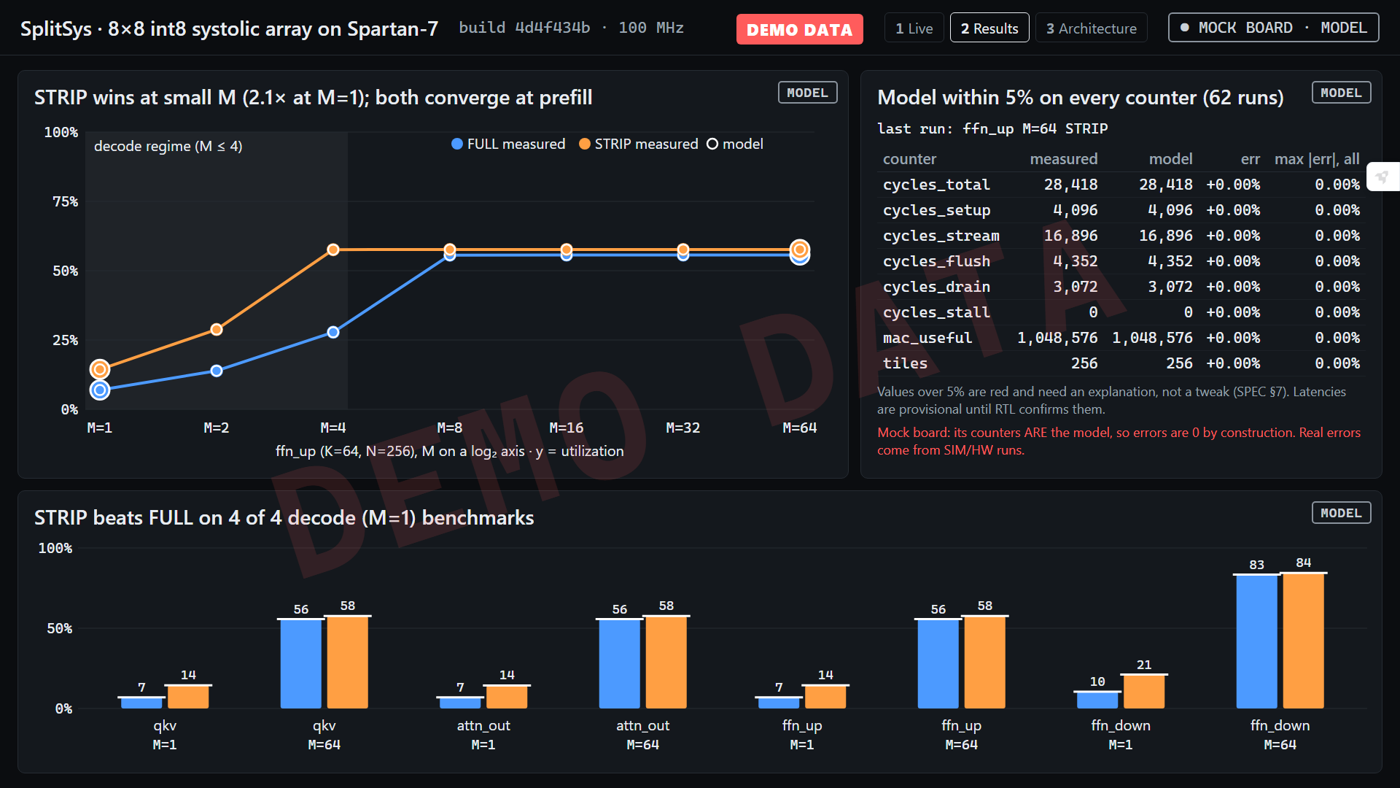
demo/screens/scene2.png
