sl33pinging/SplitSys/demo/screens/scene3.png

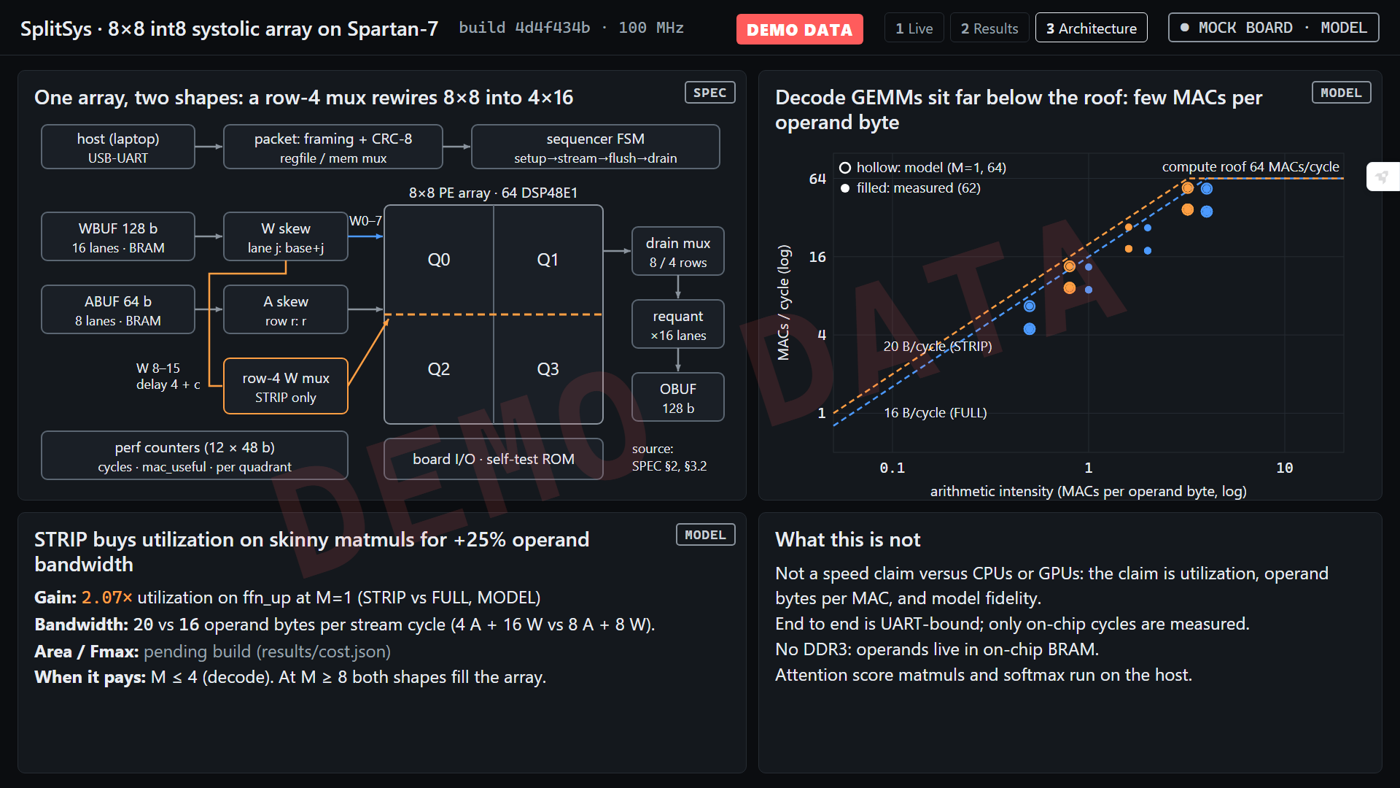
demo/screens/scene3.png
