sl33pinging/SplitSys/demo/screens/sim_scene1.png

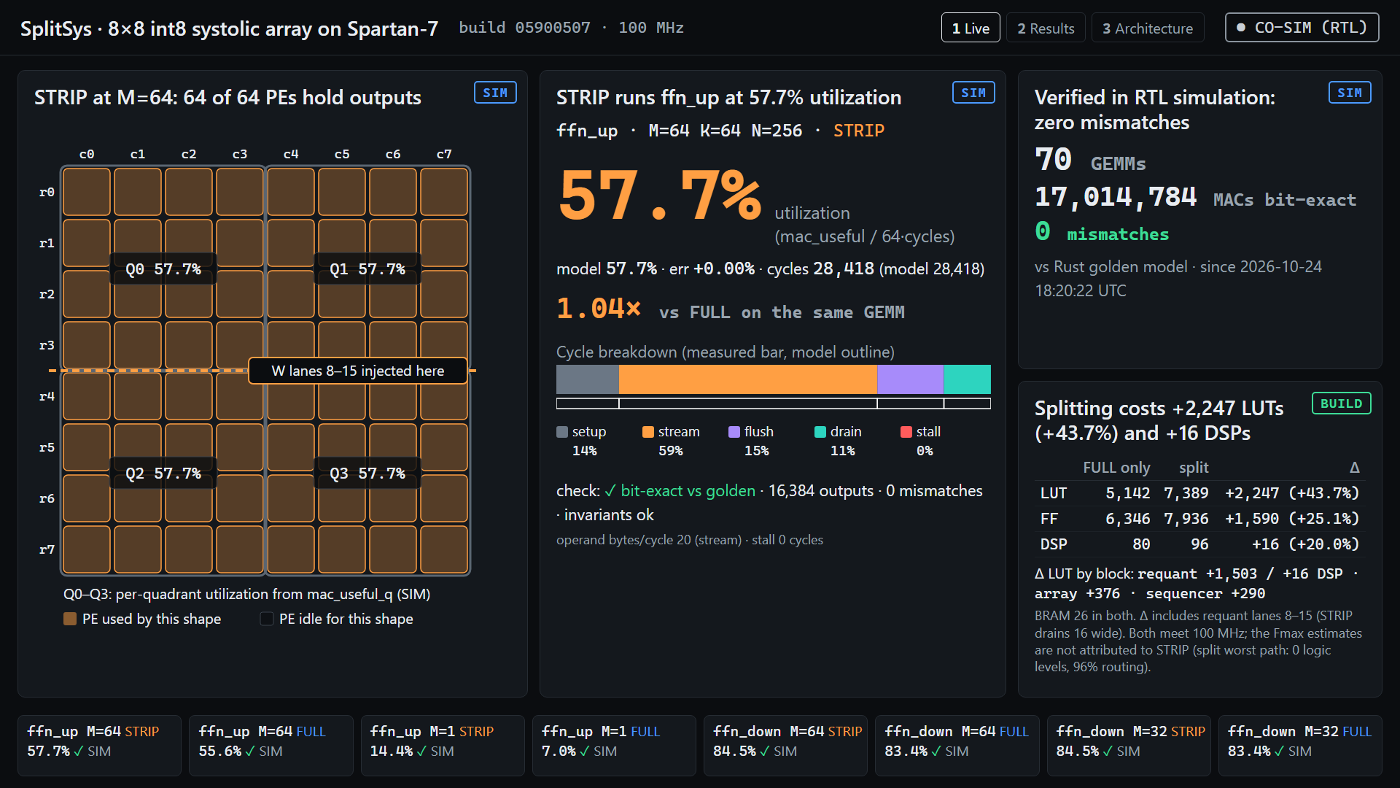
demo/screens/sim_scene1.png
