sl33pinging/SplitSys/demo/screens/sim_scene2.png

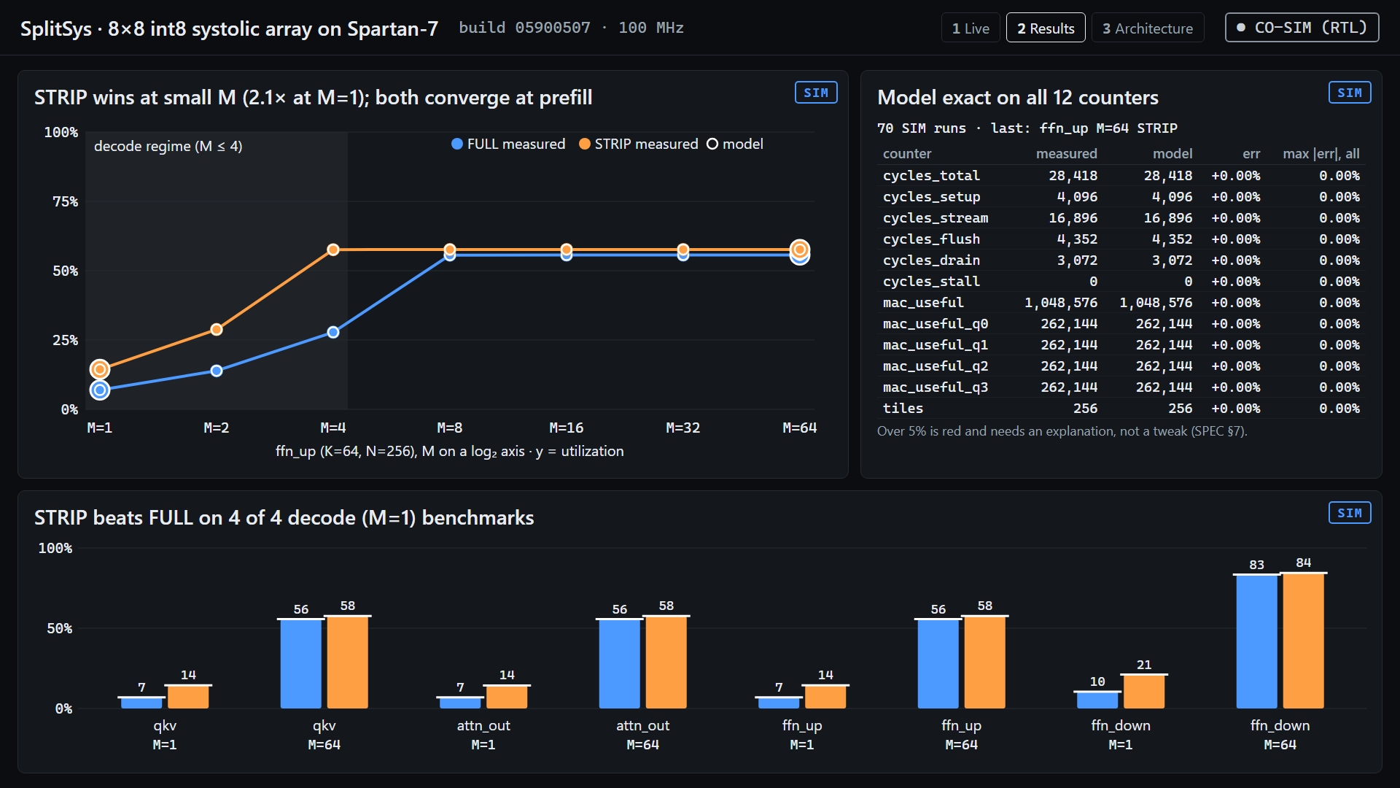
demo/screens/sim_scene2.png
