sl33pinging/SplitSys/demo/screens/sim_scene3.png

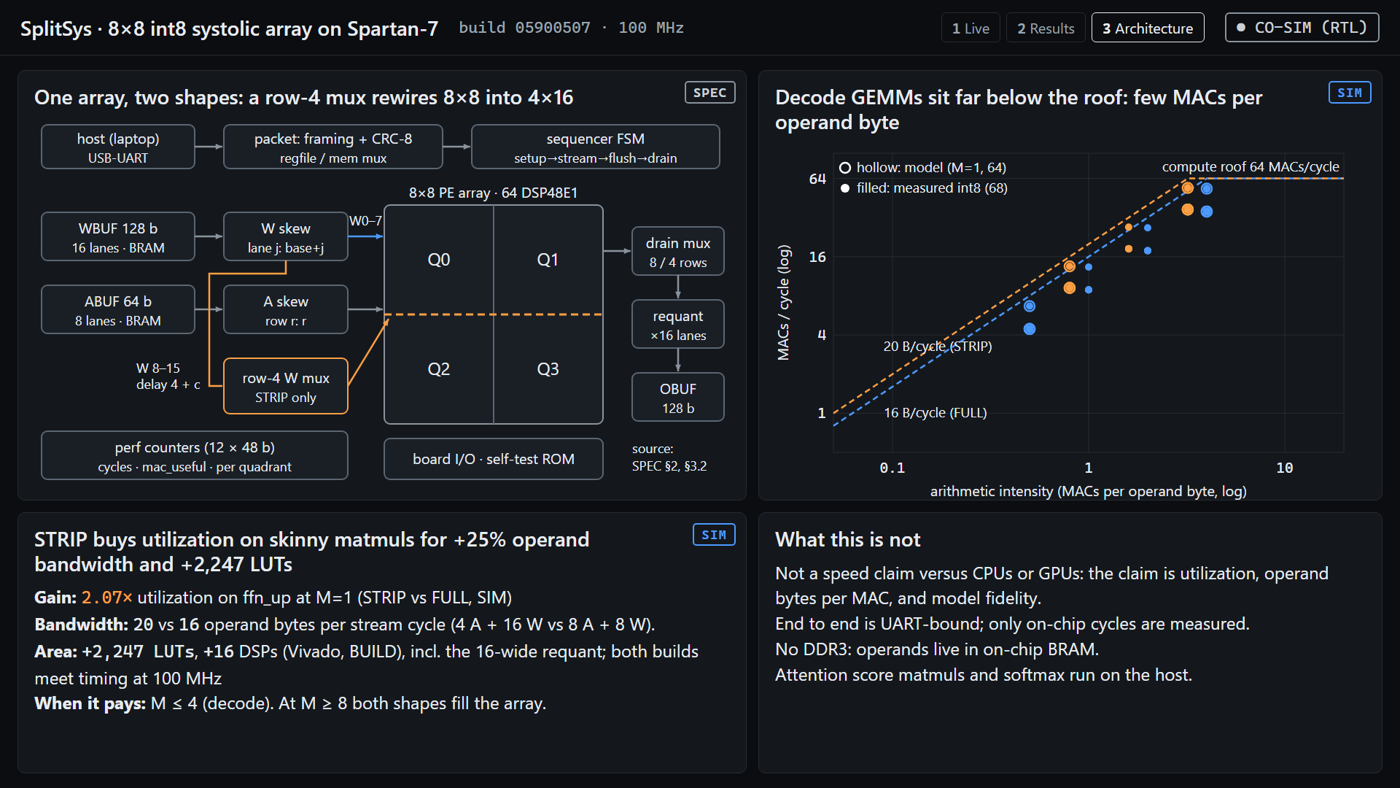
demo/screens/sim_scene3.png
