sl33pinging/SplitSys/results/plots/cost_dark.png

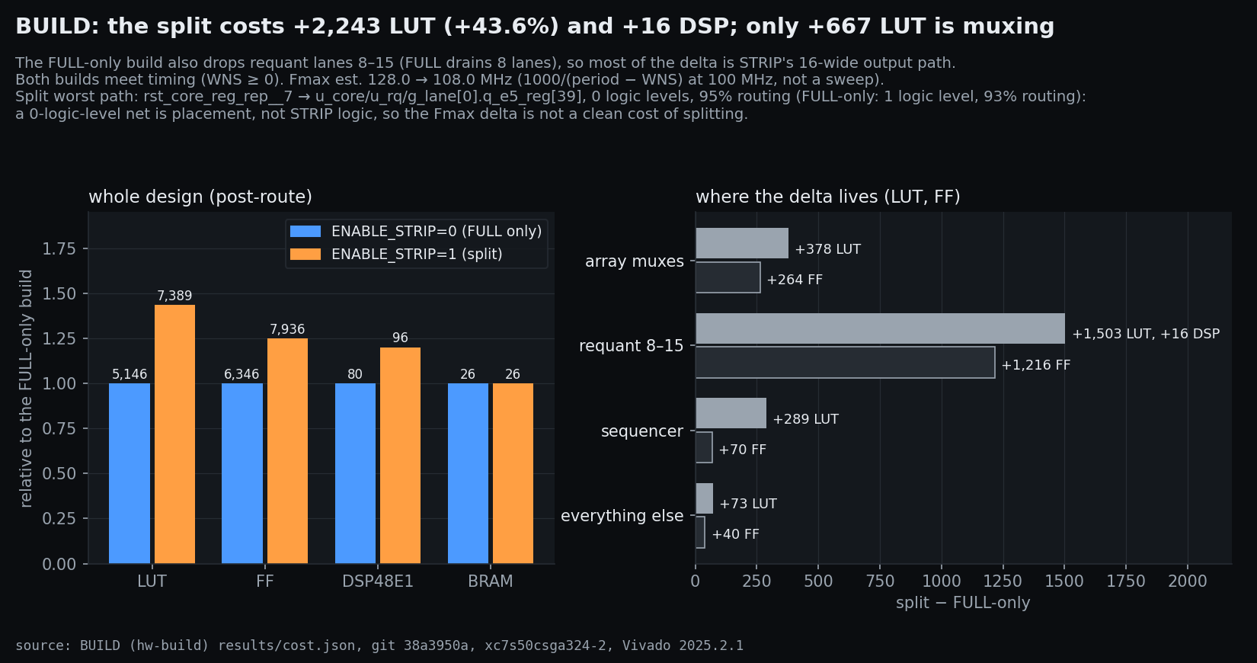
results/plots/cost_dark.png
