sl33pinging/SplitSys/results/model/README.md

# SplitSys cycle model — results (source: model)

Generated by `cargo run -p splitsys-cycle -- explain` at model_git_hash `72da65248adf` (latencies confirmed against the RTL in spec.toml, D-017). Every number below comes from `sweep.json` in this directory; do not edit by hand.

Latencies used: L_ACCEPT=1, L_SETUP=16, L_RD=2, L_PE=3, L_RQ=7, L_WB=1, L_DONE=1.

**Status: MODEL predictions.** These are not measurements. Confirming the latency constants means the RTL implements these state lengths. It does not mean the model has been reconciled against counters: apart from rtl-designer's core smoke run, no Verilator system-sim or hardware counters have been compared yet. Any dashboard or pitch use must carry the `MODEL` badge until `sim`/`hw` records with per-counter error exist.

## Timing contract the model assumes

Within a tile, with `s` = first STREAM cycle: read k is issued in cycle `s + k`, and its operand word is at the array port in cycle `s + L_RD + 1 + k` (= `s + 3 + k`; one lane-select register after the BRAM data, as in `rtl/sequencer.sv`). PE(r, c) sees it in `s + L_RD + 1 + k + r + c` and its accumulator holds all K MACs from `s + L_RD + 1 + (K-1) + r + c + L_PE`. The drain mux samples the accumulators combinationally in each DRAIN cycle and registers them (that register is part of L_RQ), so every PE must be final no later than the first DRAIN cycle. For PE(7, 7) this holds with equality: FLUSH = 14 + L_PE has zero slack. The `+ 1` is implied by SPEC §3.5 (STREAM = L_RD + K, FLUSH = 14 + L_PE), not a separate tunable latency. The model's FSM walk asserts this boundary for every PE of every tile. None of it changes a counter: counters depend only on the state lengths.

## Why STRIP wins at small M and both modes converge at large M

The array always has 64 multipliers, but an output tile can only use as many PE rows as the matmul has rows. In FULL mode a tile is 8 rows × 8 columns, so a decode-shaped matmul with M = 1 keeps 1 of 8 rows busy: at most 1/8 = 12.5% of the PEs ever do useful work. STRIP rewires the same 64 PEs into a 4 × 16 tile, so M = 1 keeps 1 of 4 rows busy (at most 25%), and each tile covers twice as many output columns, so the job needs half as many tiles. Each tile costs the same fixed time whether its rows are useful or not, `T_tile = L_SETUP + (L_RD + K) + (14 + L_PE) + T_DRAIN + L_RQ + L_WB` (T_DRAIN = 8 cycles FULL, 4 STRIP with int8 output), so `utilization = M·N·K / (64 · (L_ACCEPT + ceil(M/Rt)·ceil(N/Ct)·T_tile + L_DONE))` with (Rt, Ct) = (8, 8) for FULL and (4, 16) for STRIP. For `ffn_up` (K = 64, N = 256) at M = 1 the model gives FULL 7.0% (32 tiles × 115 cycles) versus STRIP 14.4% (16 tiles × 111 cycles), 2.07× higher. STRIP already fills every PE at M = 4; once M reaches 8, both modes fill all 64 PEs on every tile and need the same number of tiles (M·N/64), so both approach K / T_tile, held below 100% only by the fixed per-tile setup, fill/flush and drain cycles: at M = 64 FULL reaches 55.6% and STRIP 57.7% (1.036×); the only remaining difference is that STRIP drains 4 rows per tile instead of 8. The price of the split is operand bandwidth: STRIP reads 4 A + 16 W = 20 bytes per stream cycle instead of 8 + 8 = 16, which is 25% more.

## Modeled utilization (requant on)

| GEMM | mode | M=1 | M=2 | M=4 | M=8 | M=16 | M=32 | M=64 |
| --- | --- | ---: | ---: | ---: | ---: | ---: | ---: | ---: |
| qkv | FULL | 7.0% | 13.9% | 27.8% | 55.6% | 55.6% | 55.6% | 55.6% |
| qkv | STRIP | 14.4% | 28.8% | 57.6% | 57.6% | 57.6% | 57.6% | 57.7% |
| attn_out | FULL | 6.9% | 13.9% | 27.8% | 55.5% | 55.6% | 55.6% | 55.6% |
| attn_out | STRIP | 14.3% | 28.7% | 57.4% | 57.5% | 57.6% | 57.6% | 57.6% |
| ffn_up | FULL | 7.0% | 13.9% | 27.8% | 55.6% | 55.6% | 55.6% | 55.6% |
| ffn_up | STRIP | 14.4% | 28.8% | 57.6% | 57.6% | 57.6% | 57.6% | 57.7% |
| ffn_down | FULL | 10.4% | 20.8% | 41.7% | 83.3% | 83.4% | 83.4% | 83.4% |
| ffn_down | STRIP | 21.1% | 42.2% | 84.3% | 84.4% | 84.5% | 84.5% | 84.5% |

## Mapping-only ceilings (N a multiple of 16, before any overhead)

| M | FULL | STRIP |
| ---: | ---: | ---: |
| 1 | 12.5% | 25.0% |
| 2 | 25.0% | 50.0% |
| 4 | 50.0% | 100.0% |
| 8 | 100.0% | 100.0% |
| 16 | 100.0% | 100.0% |
| 32 | 100.0% | 100.0% |
| 64 | 100.0% | 100.0% |

Files: `sweep.json` (every counter for every point, DEMO.md §4 `model` blocks), `roofline.json` (x = MACs per operand byte streamed, y = MACs/cycle; roofs: 64 MAC/cycle compute, 16 B/cycle FULL, 20 B/cycle STRIP). Regenerate: `cd sw && cargo run -p splitsys-cycle -- all`.
