sl33pinging/SplitSys/results/plots/bench_bars_dark.png

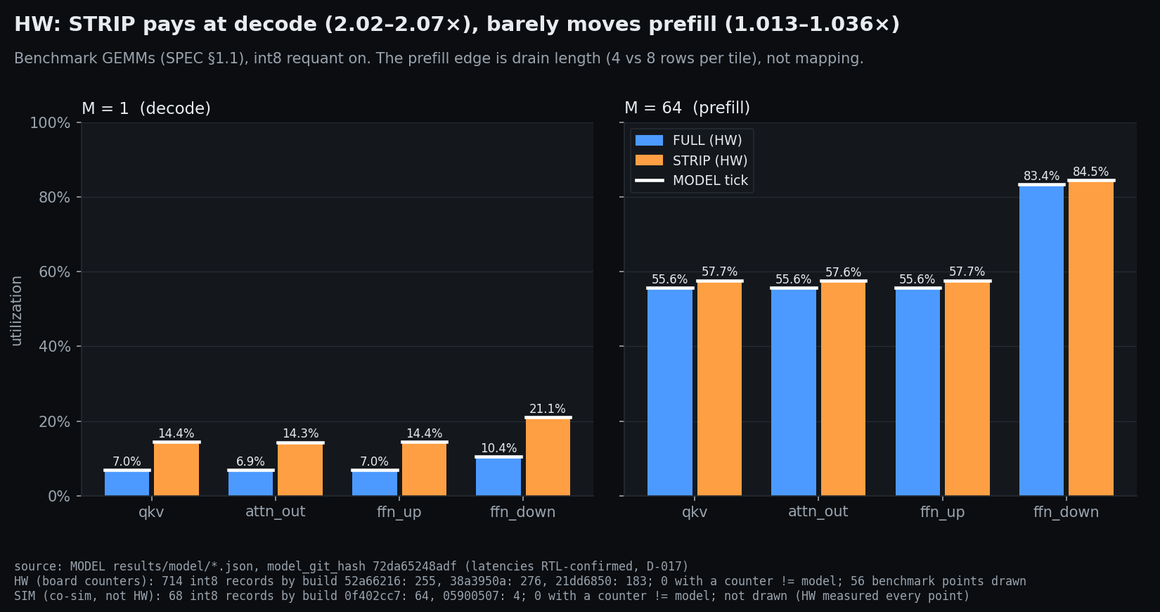
results/plots/bench_bars_dark.png
