sl33pinging/SplitSys/results/plots/roofline_dark.png

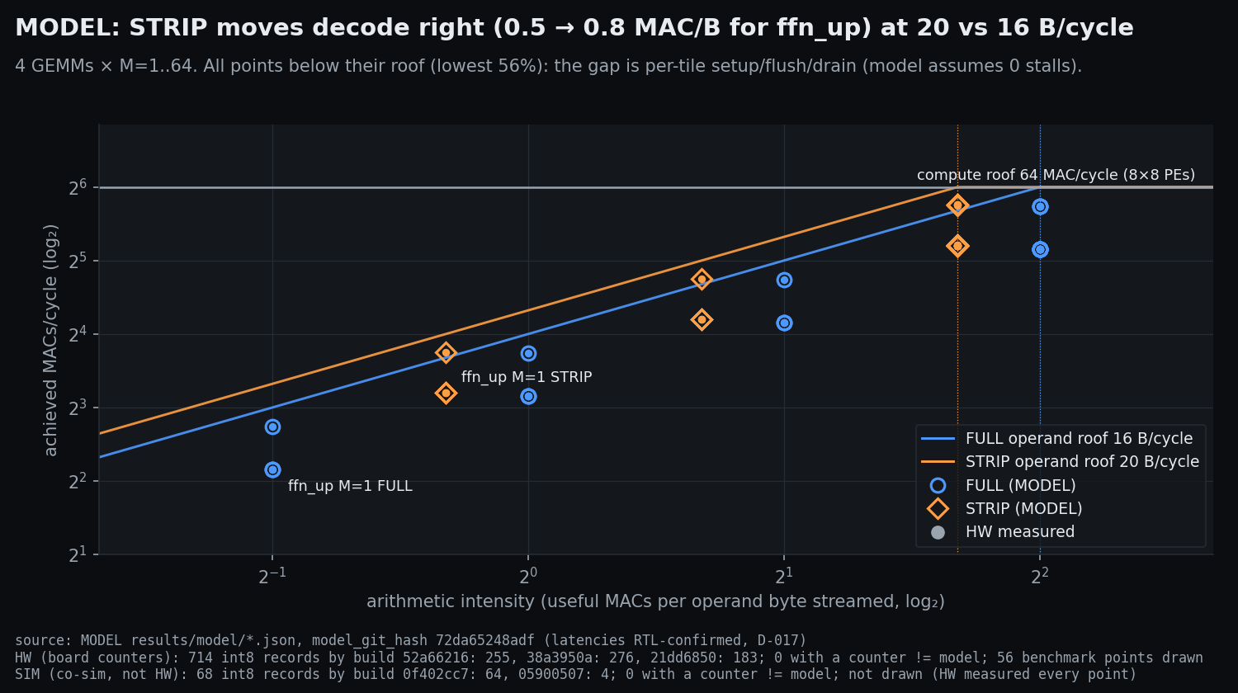
results/plots/roofline_dark.png
