sl33pinging/SplitSys/results/plots/util_vs_m_all_dark.png

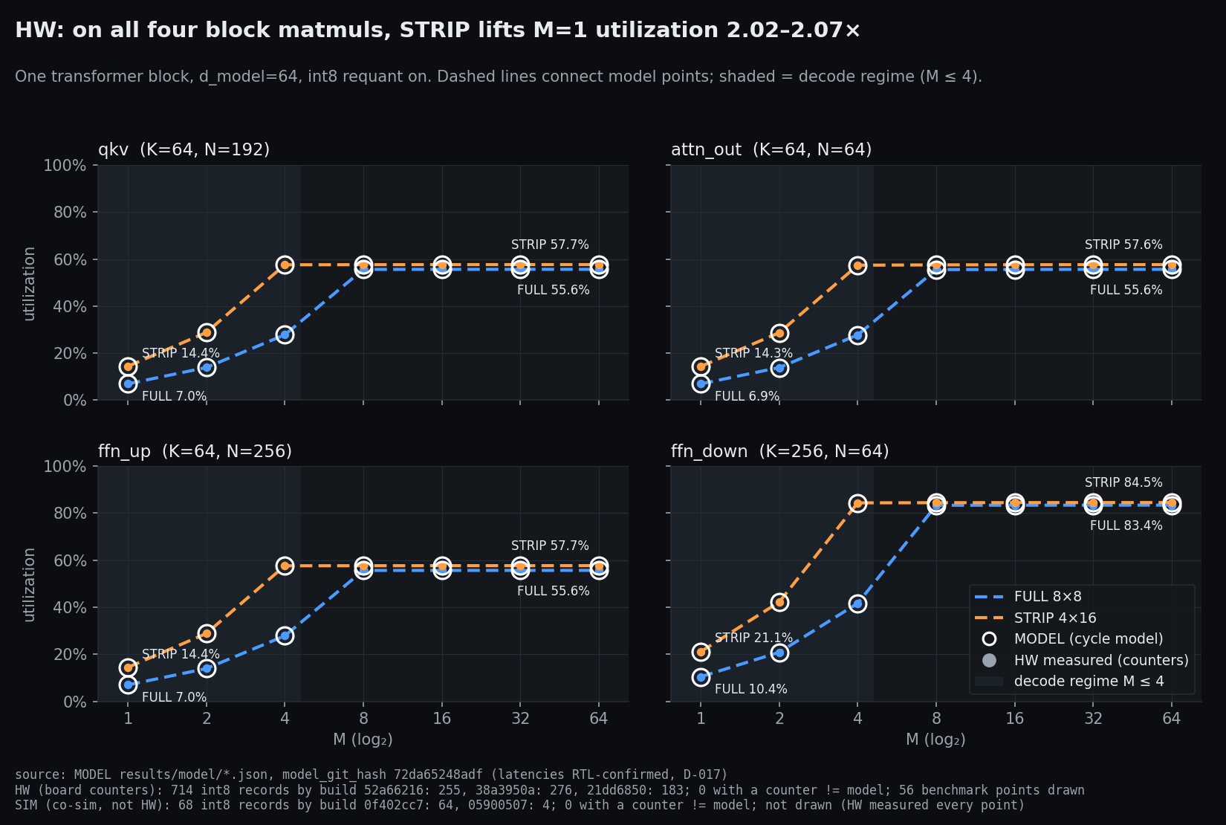
results/plots/util_vs_m_all_dark.png
