sl33pinging/SplitSys/results/plots/util_vs_m_all_light.png

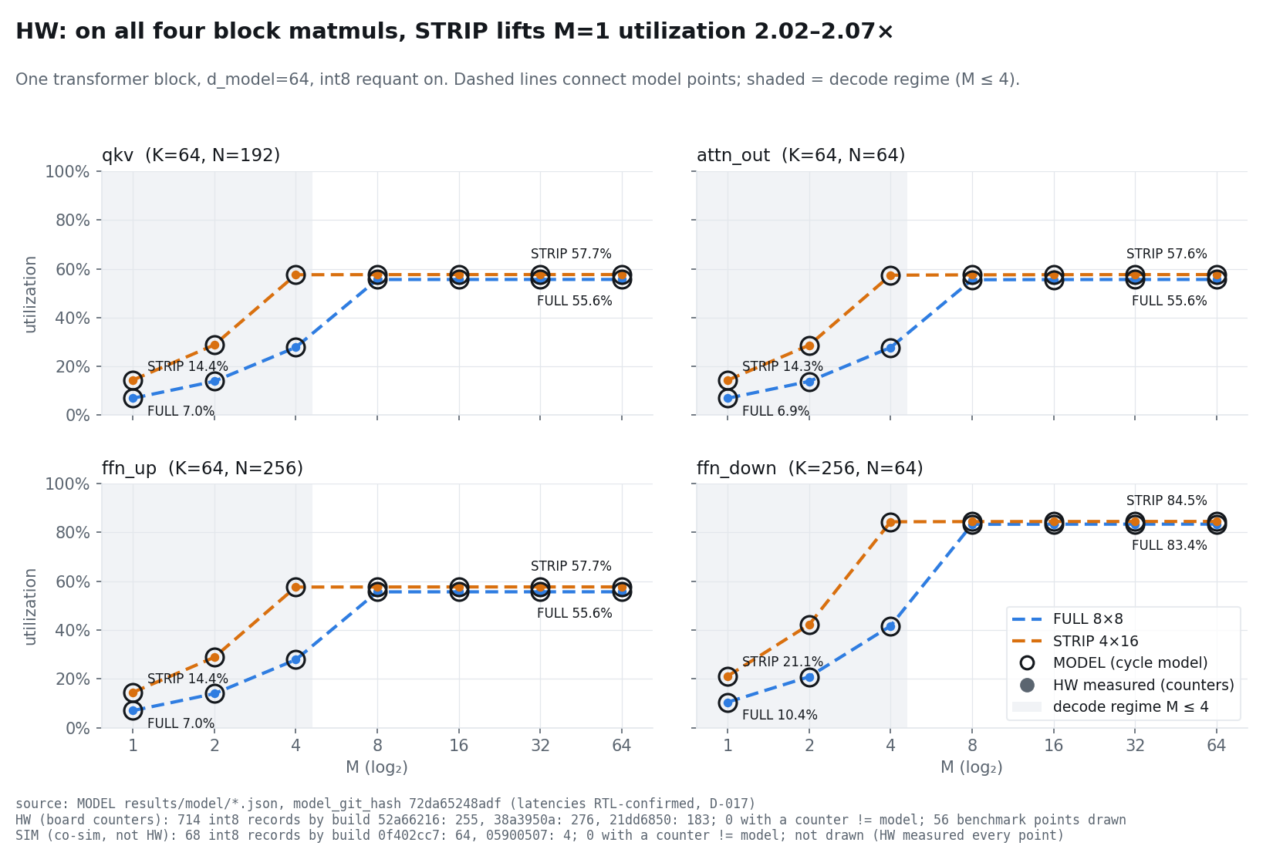
results/plots/util_vs_m_all_light.png
