sl33pinging/SplitSys/results/plots/video_cards/01_title.png

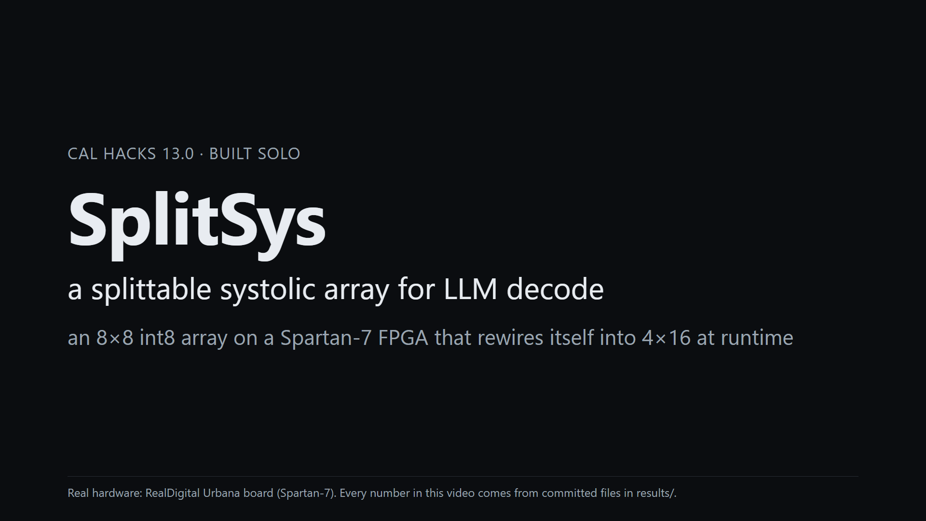
results/plots/video_cards/01_title.png
