sl33pinging/SplitSys/results/plots/video_cards/02_idle_rows.png

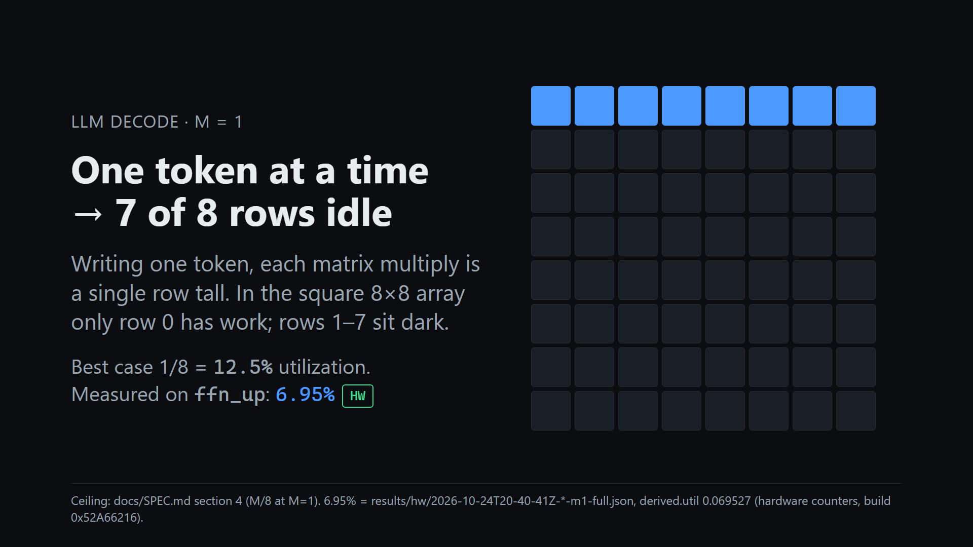
results/plots/video_cards/02_idle_rows.png
