sl33pinging/SplitSys/results/plots/video_cards/03_stat.png

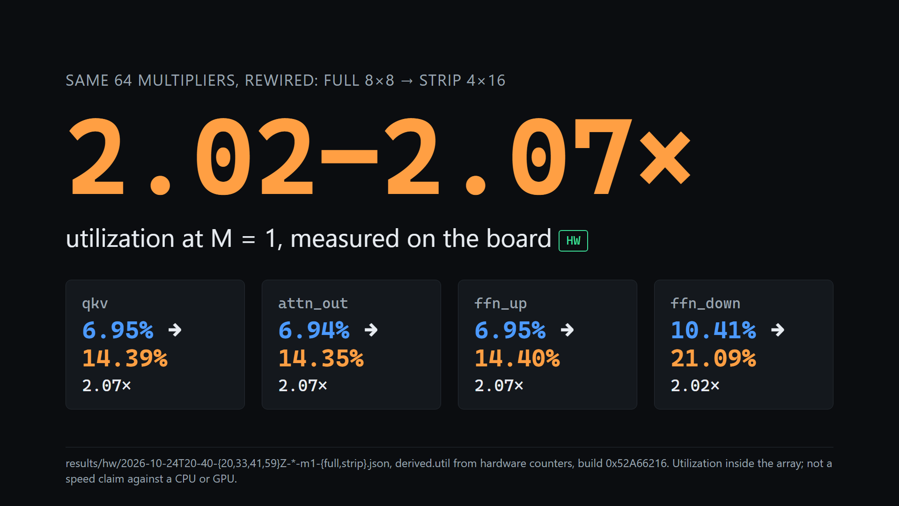
results/plots/video_cards/03_stat.png
