sl33pinging/SplitSys/results/plots/video_cards/04_model_exact.png

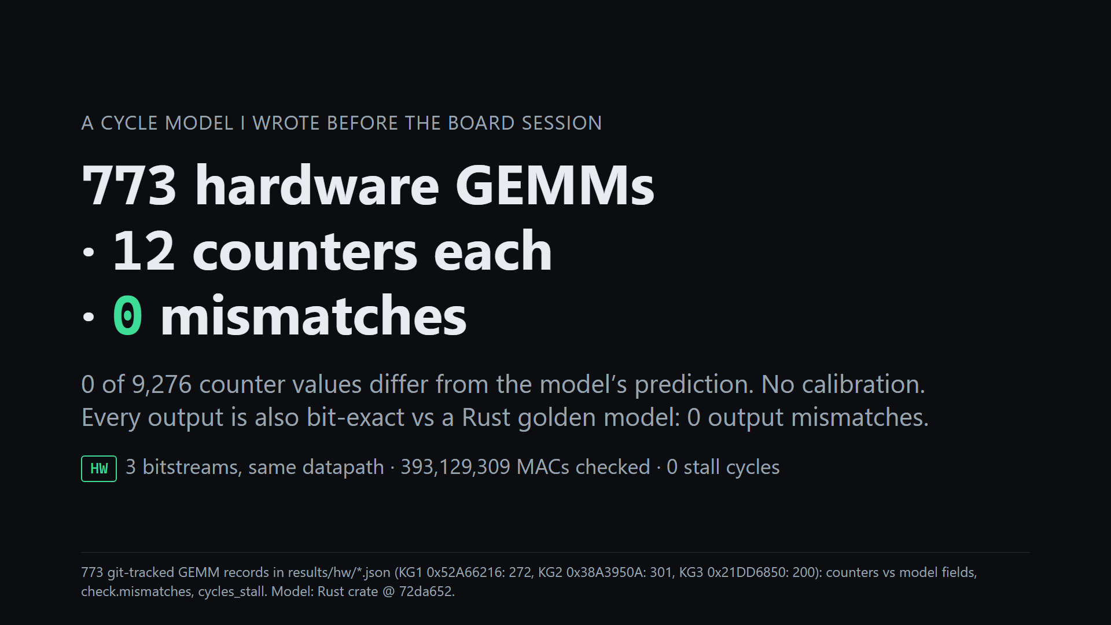
results/plots/video_cards/04_model_exact.png
