sl33pinging/SplitSys/results/plots/video_cards/05_llm.png

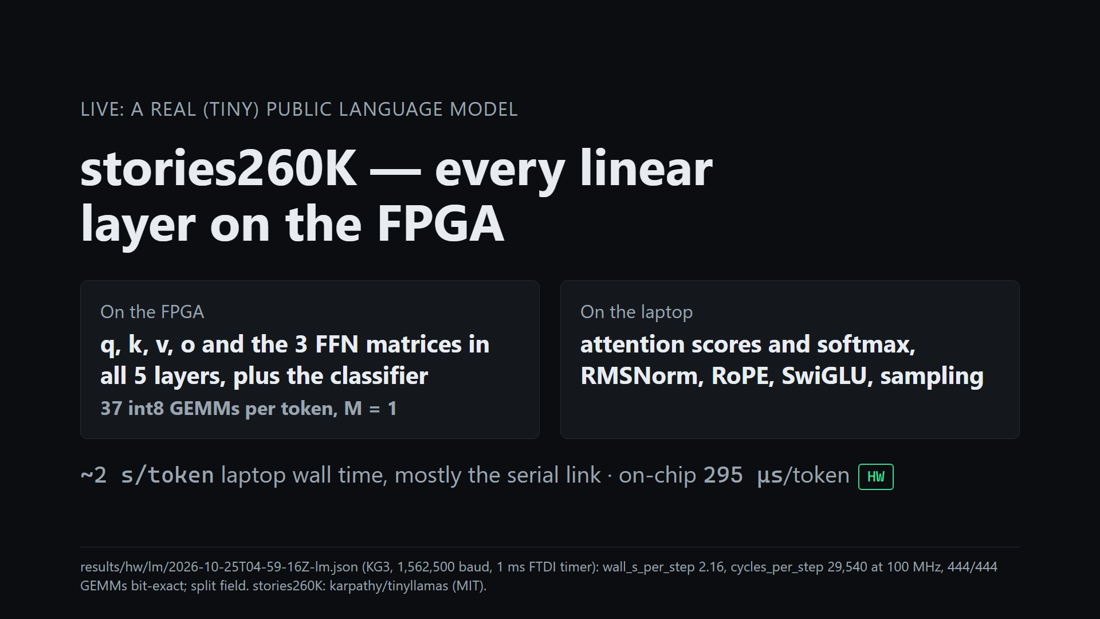
results/plots/video_cards/05_llm.png
