sl33pinging/SplitSys/results/plots/video_cards/06_limits.png

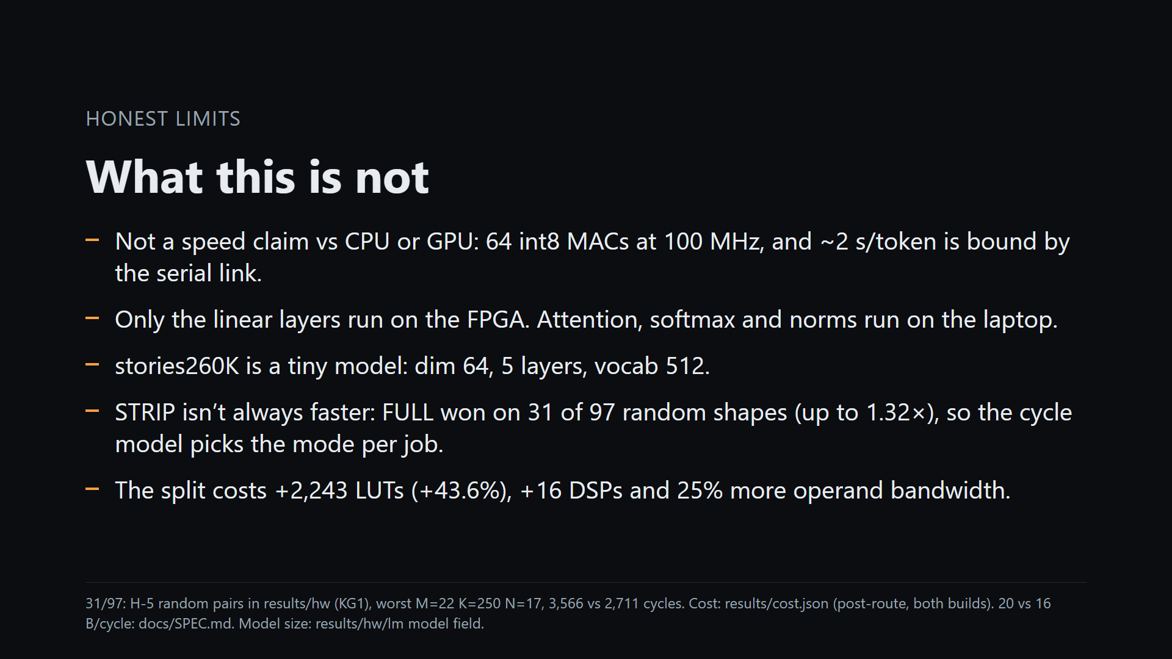
results/plots/video_cards/06_limits.png
