sl33pinging/SplitSys/results/plots/video_cards/07_end.png

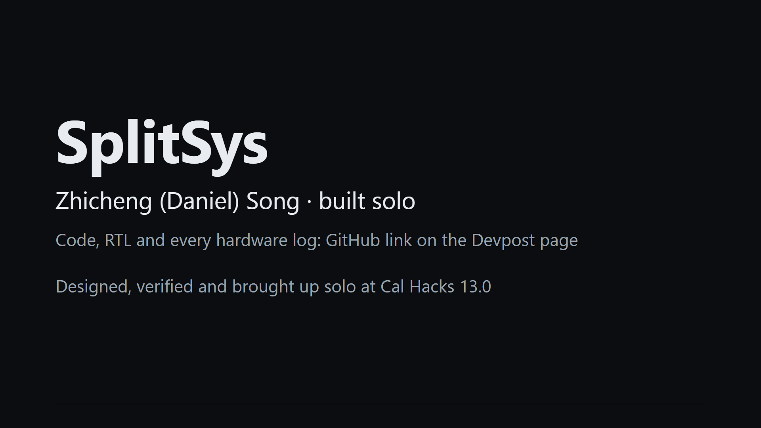
results/plots/video_cards/07_end.png
