sl33pinging/SplitSys/sw/crates/host/src/record.rs

//! Run records (DEMO.md §4 schema), session totals, and result paths.

use serde::{Deserialize, Serialize};
use serde_json::Value;
use splitsys_cycle::Counters;
use std::path::{Path, PathBuf};
use std::time::{SystemTime, UNIX_EPOCH};

#[derive(Clone, Debug, Serialize, Deserialize, PartialEq)]
pub struct GemmInfo {
    pub name: String,
    #[serde(rename = "M")]
    pub m: u64,
    #[serde(rename = "K")]
    pub k: u64,
    #[serde(rename = "N")]
    pub n: u64,
    /// "FULL" | "STRIP"
    pub mode: String,
    pub requant: bool,
}

#[derive(Clone, Debug, Serialize, Deserialize, PartialEq)]
pub struct ModelInfo {
    #[serde(flatten)]
    pub counters: Counters,
    pub model_git_hash: String,
}

#[derive(Clone, Debug, Serialize, Deserialize, PartialEq)]
pub struct Derived {
    /// mac_useful / (64 · cycles_total), measured counters.
    pub util: f64,
    /// Same from the model counters.
    pub util_model: f64,
    /// A + W bytes read per STREAM cycle by this mode's datapath (16 FULL, 20 STRIP).
    pub operand_bytes_per_cycle: f64,
    /// (measured − model) / model for cycles_total (a fraction; ×100 for %).
    pub model_err_total: f64,
    /// Operand bytes streamed (tiles·K·bytes_per_cycle) / cycles_total, measured.
    #[serde(default, skip_serializing_if = "Option::is_none")]
    pub operand_bytes_per_cycle_avg: Option<f64>,
    /// mac_useful / cycles_total, measured.
    #[serde(default, skip_serializing_if = "Option::is_none")]
    pub macs_per_cycle: Option<f64>,
    /// mac_useful / operand bytes streamed, measured.
    #[serde(default, skip_serializing_if = "Option::is_none")]
    pub arithmetic_intensity: Option<f64>,
}

#[derive(Clone, Debug, Serialize, Deserialize, PartialEq)]
pub struct Check {
    pub golden_match: bool,
    pub outputs_compared: u64,
    pub mismatches: u64,
    pub invariants_ok: bool,
    #[serde(default, skip_serializing_if = "Option::is_none")]
    pub invariant_error: Option<String>,
    #[serde(default, skip_serializing_if = "Option::is_none")]
    /// Row-major index (m*N + n) of the first mismatching in-bounds output.
    pub first_mismatch: Option<u64>,
    /// Counters that differ from the cycle model: "name: measured vs model (err%)".
    #[serde(default, skip_serializing_if = "Vec::is_empty")]
    pub counter_diffs: Vec<String>,
}

/// Extra provenance (not in the DEMO.md §4 example, all optional).
#[derive(Clone, Debug, Serialize, Deserialize, PartialEq, Default)]
pub struct Provenance {
    #[serde(default, skip_serializing_if = "Option::is_none")]
    pub transport: Option<String>,
    #[serde(default, skip_serializing_if = "Option::is_none")]
    pub seed: Option<u64>,
    /// End-to-end wall time including UART. Never an accelerator speed.
    #[serde(default, skip_serializing_if = "Option::is_none")]
    pub wall_ms_end_to_end: Option<f64>,
    #[serde(default, skip_serializing_if = "Option::is_none")]
    pub latencies_provisional: Option<bool>,
}

/// How the mode of a `--mode auto` run was chosen (G5 stretch). Present only on
/// auto runs. Both predictions are MODEL numbers (frozen `splitsys_cycle`
/// latencies); only the chosen mode was run, so only its cycles are measured
/// (`counters.cycles_total`). The un-run mode's cycles are never measured.
#[derive(Clone, Debug, Serialize, Deserialize, PartialEq, Eq)]
pub struct ModeSelect {
    /// Always "AUTO".
    pub requested: String,
    /// The mode that was run: "FULL" | "STRIP" (equals `gemm.mode`).
    pub chosen: String,
    /// True: chosen by the host, not by the user.
    pub automatic: bool,
    /// The rule, e.g. `splitsys_cycle::choose_mode: min model cycles_total, ties -> FULL`.
    pub policy: String,
    /// Model-predicted cycles_total / tiles in each mode (MODEL, not measured).
    pub model_cycles_full: u64,
    pub model_cycles_strip: u64,
    pub model_tiles_full: u64,
    pub model_tiles_strip: u64,
    /// For random-batch auto runs: which generated job supplied the operands and bases.
    #[serde(default, skip_serializing_if = "Option::is_none")]
    pub operands_from: Option<String>,
}

impl ModeSelect {
    /// Model cycles of the mode that was NOT run (MODEL only).
    pub fn model_cycles_other(&self) -> u64 {
        if self.chosen == "STRIP" {
            self.model_cycles_full
        } else {
            self.model_cycles_strip
        }
    }
    /// Model cycles of the chosen mode.
    pub fn model_cycles_chosen(&self) -> u64 {
        if self.chosen == "STRIP" {
            self.model_cycles_strip
        } else {
            self.model_cycles_full
        }
    }
}

#[derive(Clone, Debug, Serialize, Deserialize, PartialEq)]
pub struct RunRecord {
    pub run_id: String,
    pub source: String,
    pub build_id: String,
    pub git_hash: String,
    pub clock_mhz: u64,
    pub gemm: GemmInfo,
    pub counters: Counters,
    pub model: ModelInfo,
    pub derived: Derived,
    pub check: Check,
    /// True for runs on the mock board: golden_match is circular there (the mock
    /// computes its output with the same golden model), so they are never counted
    /// as verification.
    #[serde(default, skip_serializing_if = "std::ops::Not::not")]
    pub mock: bool,
    #[serde(default, skip_serializing_if = "is_default_prov")]
    pub provenance: Provenance,
    /// Present on `--mode auto` runs only: the choice and both model predictions.
    #[serde(default, skip_serializing_if = "Option::is_none")]
    pub mode_select: Option<ModeSelect>,
}

fn is_default_prov(p: &Provenance) -> bool {
    *p == Provenance::default()
}

impl RunRecord {
    pub fn verified(&self) -> bool {
        self.check.golden_match && self.check.invariants_ok && self.check.mismatches == 0
    }
}

/// Validate a JSON value against the DEMO.md §4 contract (keys and types).
/// Extra keys are allowed; missing or mistyped required keys are errors.
pub fn validate_run_json(v: &Value) -> Result<(), String> {
    fn need<'a>(v: &'a Value, path: &str, key: &str) -> Result<&'a Value, String> {
        v.get(key).ok_or_else(|| format!("missing {path}{key}"))
    }
    fn is_u(v: &Value) -> bool {
        v.as_u64().is_some()
    }
    let s = |k: &str| -> Result<(), String> {
        need(v, "", k)?
            .as_str()
            .map(|_| ())
            .ok_or_else(|| format!("{k} must be a string"))
    };
    for k in ["run_id", "source", "build_id", "git_hash"] {
        s(k)?;
    }
    let src = v["source"].as_str().unwrap_or("");
    if !["hw", "sim", "model"].contains(&src) {
        return Err(format!("source '{src}' not in hw|sim|model"));
    }
    if !need(v, "", "clock_mhz")?.is_number() {
        return Err("clock_mhz must be a number".into());
    }
    let g = need(v, "", "gemm")?;
    need(g, "gemm.", "name")?
        .as_str()
        .ok_or("gemm.name must be a string")?;
    for k in ["M", "K", "N"] {
        if !is_u(need(g, "gemm.", k)?) {
            return Err(format!("gemm.{k} must be an unsigned integer"));
        }
    }
    let mode = need(g, "gemm.", "mode")?.as_str().unwrap_or("");
    if mode != "FULL" && mode != "STRIP" {
        return Err(format!("gemm.mode '{mode}' not FULL|STRIP"));
    }
    if !need(g, "gemm.", "requant")?.is_boolean() {
        return Err("gemm.requant must be a bool".into());
    }
    for blk in ["counters", "model"] {
        let c = need(v, "", blk)?;
        for k in [
            "cycles_total",
            "cycles_setup",
            "cycles_stream",
            "cycles_flush",
            "cycles_drain",
            "cycles_stall",
            "mac_useful",
            "tiles",
        ] {
            if !is_u(need(c, &format!("{blk}."), k)?) {
                return Err(format!("{blk}.{k} must be an unsigned integer"));
            }
        }
        let q = need(c, &format!("{blk}."), "mac_useful_q")?
            .as_array()
            .ok_or(format!("{blk}.mac_useful_q must be an array"))?;
        if q.len() != 4 || !q.iter().all(is_u) {
            return Err(format!("{blk}.mac_useful_q must be 4 unsigned integers"));
        }
    }
    need(&v["model"], "model.", "model_git_hash")?
        .as_str()
        .ok_or("model.model_git_hash must be a string")?;
    let d = need(v, "", "derived")?;
    for k in ["util", "util_model", "operand_bytes_per_cycle", "model_err_total"] {
        if !need(d, "derived.", k)?.is_number() {
            return Err(format!("derived.{k} must be a number"));
        }
    }
    let c = need(v, "", "check")?;
    for k in ["golden_match", "invariants_ok"] {
        if !need(c, "check.", k)?.is_boolean() {
            return Err(format!("check.{k} must be a bool"));
        }
    }
    for k in ["outputs_compared", "mismatches"] {
        if !is_u(need(c, "check.", k)?) {
            return Err(format!("check.{k} must be an unsigned integer"));
        }
    }
    // Optional (auto runs): the choice must be auditable and match what ran.
    if let Some(ms) = v.get("mode_select").filter(|x| !x.is_null()) {
        let chosen = need(ms, "mode_select.", "chosen")?.as_str().unwrap_or("");
        if chosen != mode {
            return Err(format!("mode_select.chosen '{chosen}' != gemm.mode '{mode}'"));
        }
        if !need(ms, "mode_select.", "automatic")?.is_boolean() {
            return Err("mode_select.automatic must be a bool".into());
        }
        for k in ["model_cycles_full", "model_cycles_strip", "model_tiles_full", "model_tiles_strip"] {
            if !is_u(need(ms, "mode_select.", k)?) {
                return Err(format!("mode_select.{k} must be an unsigned integer"));
            }
        }
        let (f, s) = (ms["model_cycles_full"].as_u64().unwrap_or(0), ms["model_cycles_strip"].as_u64().unwrap_or(0));
        let want = if s < f { "STRIP" } else { "FULL" };
        if chosen != want {
            return Err(format!("mode_select.chosen {chosen} but model cycles FULL {f} STRIP {s} pick {want}"));
        }
    }
    Ok(())
}

// ---------------------------------------------------------------------------
// Time and paths
// ---------------------------------------------------------------------------

/// Seconds since the Unix epoch.
pub fn now_unix() -> f64 {
    SystemTime::now()
        .duration_since(UNIX_EPOCH)
        .map(|d| d.as_secs_f64())
        .unwrap_or(0.0)
}

/// `YYYY-MM-DDTHH:MM:SSZ` (UTC) for a Unix time.
pub fn iso_utc(unix: f64) -> String {
    let secs = unix.max(0.0) as i64;
    let (days, rem) = (secs.div_euclid(86400), secs.rem_euclid(86400));
    // Civil-from-days (Howard Hinnant's algorithm).
    let z = days + 719_468;
    let era = z.div_euclid(146_097);
    let doe = z - era * 146_097;
    let yoe = (doe - doe / 1460 + doe / 36524 - doe / 146_096) / 365;
    let y = yoe + era * 400;
    let doy = doe - (365 * yoe + yoe / 4 - yoe / 100);
    let mp = (5 * doy + 2) / 153;
    let d = doy - (153 * mp + 2) / 5 + 1;
    let m = if mp < 10 { mp + 3 } else { mp - 9 };
    let y = if m <= 2 { y + 1 } else { y };
    format!(
        "{y:04}-{m:02}-{d:02}T{:02}:{:02}:{:02}Z",
        rem / 3600,
        (rem % 3600) / 60,
        rem % 60
    )
}

/// Find the repo root (directory holding `spec/spec.toml`) from the current
/// directory upwards, else from the compile-time crate location.
pub fn repo_root() -> PathBuf {
    if let Ok(mut d) = std::env::current_dir() {
        loop {
            if d.join("spec").join("spec.toml").is_file() {
                return d;
            }
            if !d.pop() {
                break;
            }
        }
    }
    let compiled = Path::new(env!("CARGO_MANIFEST_DIR")).join("../../..");
    if compiled.join("spec").join("spec.toml").is_file() {
        return compiled;
    }
    PathBuf::from(".")
}

/// Directory for run records of a source. Mock-board (source "model") runs go to
/// `results/mock/` so they can never be mistaken for hardware or perf-modeler results.
pub fn runs_dir(results: &Path, source: &str) -> PathBuf {
    match source {
        "model" => results.join("mock"),
        s => results.join(s),
    }
}

/// Session-totals file per source (hw uses `results/session.json`, DEMO.md §4).
pub fn session_path(results: &Path, source: &str) -> PathBuf {
    match source {
        "hw" => results.join("session.json"),
        s => runs_dir(results, s).join("session.json"),
    }
}

/// File name for a run id (colons are not legal in Windows file names).
pub fn run_file_name(run_id: &str) -> String {
    format!("{}.json", run_id.replace(':', "-"))
}

/// Write JSON atomically (temp file + rename).
pub fn write_json(path: &Path, v: &impl Serialize) -> std::io::Result<()> {
    if let Some(d) = path.parent() {
        std::fs::create_dir_all(d)?;
    }
    // Unique temp name per writer, then rename: concurrent writers never see or
    // produce a torn file (the last complete rename wins).
    static SEQ: std::sync::atomic::AtomicU64 = std::sync::atomic::AtomicU64::new(0);
    let n = SEQ.fetch_add(1, std::sync::atomic::Ordering::Relaxed);
    let tmp = path.with_extension(format!("json.tmp.{}.{n}", std::process::id()));
    std::fs::write(&tmp, serde_json::to_vec_pretty(v)?)?;
    std::fs::rename(&tmp, path)
}

/// Running totals (DEMO.md §4 `results/session.json`).
#[derive(Clone, Debug, Serialize, Deserialize, PartialEq, Default)]
pub struct Session {
    pub source: String,
    pub gemms_run: u64,
    pub gemms_verified: u64,
    pub macs_verified: u64,
    pub mismatches: u64,
    pub failed_runs: u64,
    pub started_utc: String,
    pub updated_utc: String,
    /// Seconds since `started_utc` at the last update.
    pub uptime_s: u64,
    #[serde(default)]
    pub started_unix: f64,
    #[serde(default)]
    pub build_ids: Vec<String>,
    /// Provenance: totals are recomputed from these records, never accumulated.
    #[serde(default, skip_serializing_if = "Option::is_none")]
    pub derived_from: Option<String>,
}

impl Session {
    /// Totals derived from run records (never accumulated, so concurrent writers
    /// cannot lose updates). Mock records count as runs but never as verified.
    pub fn from_records(source: &str, runs: &[RunRecord]) -> Self {
        let mut s = Session {
            source: source.into(),
            ..Default::default()
        };
        let mut first: Option<&str> = None;
        let mut last: Option<&str> = None;
        for r in runs.iter().filter(|r| r.source == source) {
            s.gemms_run += 1;
            if r.mock {
                // Circular check (mock output comes from golden): never verified.
            } else if r.verified() {
                s.gemms_verified += 1;
                s.macs_verified += r.counters.mac_useful;
            } else {
                s.failed_runs += 1;
            }
            s.mismatches += r.check.mismatches;
            if !s.build_ids.contains(&r.build_id) {
                s.build_ids.push(r.build_id.clone());
            }
            let t = r.run_id.get(..20).unwrap_or("");
            if first.is_none_or(|f| t < f) {
                first = Some(t);
            }
            if last.is_none_or(|l| t > l) {
                last = Some(t);
            }
        }
        let now = iso_utc(now_unix());
        s.started_utc = first.map(str::to_string).unwrap_or_else(|| now.clone());
        s.updated_utc = last.map(str::to_string).unwrap_or(now);
        let (a, b) = (parse_iso_utc(&s.started_utc), parse_iso_utc(&s.updated_utc));
        s.started_unix = a.unwrap_or(0.0);
        s.uptime_s = match (a, b) {
            (Some(a), Some(b)) => (b - a).max(0.0) as u64,
            _ => 0,
        };
        s.derived_from = Some(format!("{} run records", s.gemms_run));
        s
    }

    /// Recompute from `runs_dir(results, source)` (top level only: sub-directories
    /// such as `archive_dirty/` are never read).
    pub fn rebuild(results: &Path, source: &str) -> Self {
        let runs = load_runs(&runs_dir(results, source));
        let mut s = Self::from_records(source, &runs);
        s.derived_from = Some(format!(
            "{} run records in {}/ (top level)",
            s.gemms_run,
            runs_dir(Path::new("results"), source).display()
        ));
        s
    }

    /// Rebuild and write `session_path(results, source)` atomically.
    pub fn rebuild_and_write(results: &Path, source: &str) -> std::io::Result<Self> {
        let s = Self::rebuild(results, source);
        write_json(&session_path(results, source), &s)?;
        Ok(s)
    }
}

/// Load run records from a directory (top level, sorted by run_id), skipping
/// anything that is not a valid DEMO.md §4 record (bench summaries, session.json).
pub fn load_runs(dir: &Path) -> Vec<RunRecord> {
    let mut v: Vec<RunRecord> = std::fs::read_dir(dir)
        .map(|rd| {
            rd.filter_map(|e| e.ok())
                .map(|e| e.path())
                .filter(|p| p.is_file() && p.extension().is_some_and(|x| x == "json"))
                .filter_map(|p| std::fs::read(&p).ok())
                .filter_map(|b| serde_json::from_slice::<Value>(&b).ok())
                .filter(|v| validate_run_json(v).is_ok())
                .filter_map(|v| serde_json::from_value::<RunRecord>(v).ok())
                .collect()
        })
        .unwrap_or_default();
    v.sort_by(|a, b| a.run_id.cmp(&b.run_id));
    v
}

/// Parse `YYYY-MM-DDTHH:MM:SSZ` to Unix seconds.
pub fn parse_iso_utc(s: &str) -> Option<f64> {
    let b = s.as_bytes();
    if b.len() < 20 || b[4] != b'-' || b[10] != b'T' || b[19] != b'Z' {
        return None;
    }
    let n = |r: std::ops::Range<usize>| s.get(r)?.parse::<i64>().ok();
    let (y, mo, d) = (n(0..4)?, n(5..7)?, n(8..10)?);
    let (h, mi, se) = (n(11..13)?, n(14..16)?, n(17..19)?);
    // Days from civil (Howard Hinnant).
    let y2 = if mo <= 2 { y - 1 } else { y };
    let era = y2.div_euclid(400);
    let yoe = y2 - era * 400;
    let mp = (mo + 9) % 12;
    let doy = (153 * mp + 2) / 5 + d - 1;
    let doe = yoe * 365 + yoe / 4 - yoe / 100 + doy;
    let days = era * 146_097 + doe - 719_468;
    Some((days * 86400 + h * 3600 + mi * 60 + se) as f64)
}

#[cfg(test)]
mod tests {
    use super::*;

    /// The JSON example of DEMO.md §4, extracted from the doc itself so the test
    /// tracks the contract.
    fn demo_example() -> Value {
        let md = std::fs::read_to_string(repo_root().join("docs/DEMO.md")).expect("docs/DEMO.md");
        let start = md.find("## 4. Data contract").expect("§4");
        let body = &md[start..];
        let j0 = body.find("```json").expect("json block") + "```json".len();
        let j1 = j0 + body[j0..].find("```").expect("end of block");
        serde_json::from_str(&body[j0..j1]).expect("DEMO.md §4 example parses")
    }

    #[test]
    fn demo_md_example_validates_and_roundtrips() {
        let ex = demo_example();
        validate_run_json(&ex).unwrap();
        let rec: RunRecord = serde_json::from_value(ex.clone()).expect("deserialize §4 example");
        let back = serde_json::to_value(&rec).unwrap();
        validate_run_json(&back).unwrap();
        // Every key of the example survives the round trip with the same value
        // (numbers compared as f64: the example writes 0.0 for derived floats).
        fn same(a: &Value, b: &Value, path: &str) {
            match (a, b) {
                (Value::Object(x), Value::Object(y)) => {
                    for (k, v) in x {
                        same(v, y.get(k).unwrap_or_else(|| panic!("lost key {path}.{k}")), &format!("{path}.{k}"));
                    }
                }
                (Value::Number(x), Value::Number(y)) => {
                    assert_eq!(x.as_f64(), y.as_f64(), "{path}")
                }
                _ => assert_eq!(a, b, "{path}"),
            }
        }
        same(&ex, &back, "");
    }

    #[test]
    fn validator_rejects_broken_records() {
        let ex = demo_example();
        let mut v = ex.clone();
        v["source"] = "live".into();
        assert!(validate_run_json(&v).is_err());
        let mut v = ex.clone();
        v["counters"]["mac_useful_q"] = serde_json::json!([0, 0, 0]);
        assert!(validate_run_json(&v).is_err());
        let mut v = ex.clone();
        v["check"].as_object_mut().unwrap().remove("mismatches");
        assert!(validate_run_json(&v).is_err());
        let mut v = ex;
        v["gemm"]["mode"] = "INDEP".into();
        assert!(validate_run_json(&v).is_err());
    }

    #[test]
    fn mode_select_roundtrips_and_is_validated() {
        let mut r: RunRecord = serde_json::from_value(demo_example()).unwrap();
        assert!(r.mode_select.is_none(), "plain records carry no mode_select");
        assert!(serde_json::to_value(&r).unwrap().get("mode_select").is_none());
        r.gemm.mode = "FULL".into();
        r.mode_select = Some(ModeSelect {
            requested: "AUTO".into(),
            chosen: "FULL".into(),
            automatic: true,
            policy: "test".into(),
            model_cycles_full: 100,
            model_cycles_strip: 132,
            model_tiles_full: 3,
            model_tiles_strip: 5,
            operands_from: Some("job 7".into()),
        });
        let v = serde_json::to_value(&r).unwrap();
        validate_run_json(&v).unwrap();
        let back: RunRecord = serde_json::from_value(v.clone()).unwrap();
        assert_eq!(back, r);
        assert_eq!(back.mode_select.as_ref().unwrap().model_cycles_other(), 132);
        // chosen must equal what ran, and must be the model's pick (ties -> FULL).
        let mut bad = v.clone();
        bad["mode_select"]["chosen"] = "STRIP".into();
        assert!(validate_run_json(&bad).is_err());
        let mut bad = v.clone();
        bad["mode_select"]["model_cycles_strip"] = 90.into();
        assert!(validate_run_json(&bad).unwrap_err().contains("pick STRIP"));
        let mut tie = v;
        tie["mode_select"]["model_cycles_strip"] = 100.into();
        validate_run_json(&tie).unwrap();
    }

    fn rec(id: &str, source: &str, mismatches: u64, mock: bool) -> RunRecord {
        let mut r: RunRecord = serde_json::from_value(demo_example()).unwrap();
        r.run_id = id.into();
        r.source = source.into();
        r.mock = mock;
        r.counters.mac_useful = 100;
        r.check.mismatches = mismatches;
        r.check.golden_match = mismatches == 0;
        r
    }

    #[test]
    fn session_is_derived_from_records() {
        let runs = vec![
            rec("2026-10-24T10:00:00Z-a", "sim", 0, false),
            rec("2026-10-24T10:00:30Z-b", "sim", 2, false),
            rec("2026-10-24T10:01:00Z-c", "sim", 0, false),
            rec("2026-10-24T10:02:00Z-d", "hw", 0, false),
        ];
        let s = Session::from_records("sim", &runs);
        assert_eq!((s.gemms_run, s.gemms_verified, s.failed_runs, s.mismatches), (3, 2, 1, 2));
        assert_eq!(s.macs_verified, 200);
        assert_eq!(s.started_utc, "2026-10-24T10:00:00Z");
        assert_eq!(s.updated_utc, "2026-10-24T10:01:00Z");
        assert_eq!(s.uptime_s, 60);
        let m = Session::from_records("model", &[rec("2026-10-24T10:00:00Z-m", "model", 0, true)]);
        assert_eq!((m.gemms_run, m.gemms_verified), (1, 0));
    }

    #[test]
    fn rebuild_reads_top_level_only_and_survives_concurrent_writers() {
        let dir = std::env::temp_dir().join(format!("splitsys_sess_{}", std::process::id()));
        let _ = std::fs::remove_dir_all(&dir);
        let sim = dir.join("sim");
        std::fs::create_dir_all(sim.join("archive_dirty")).unwrap();
        for (i, id) in ["2026-10-24T10:00:00Z-a", "2026-10-24T10:00:05Z-b"].iter().enumerate() {
            write_json(&sim.join(run_file_name(id)), &rec(id, "sim", 0, false)).unwrap();
            write_json(&sim.join("archive_dirty").join(format!("x{i}.json")), &rec(id, "sim", 9, false)).unwrap();
        }
        std::fs::write(sim.join("bench_x.json"), br#"{"kind":"bench_summary"}"#).unwrap();
        // Many concurrent rebuild+write calls: every result is complete and correct.
        let hs: Vec<_> = (0..8)
            .map(|_| {
                let d = dir.clone();
                std::thread::spawn(move || Session::rebuild_and_write(&d, "sim").unwrap())
            })
            .collect();
        for h in hs {
            let s = h.join().unwrap();
            assert_eq!((s.gemms_run, s.gemms_verified, s.mismatches), (2, 2, 0));
        }
        let on_disk: Session =
            serde_json::from_slice(&std::fs::read(sim.join("session.json")).unwrap()).unwrap();
        assert_eq!(on_disk.gemms_verified, 2);
        assert!(std::fs::read_dir(&sim)
            .unwrap()
            .all(|e| !e.unwrap().file_name().to_string_lossy().contains(".tmp")));
        let _ = std::fs::remove_dir_all(&dir);
    }

    #[test]
    fn parse_iso_roundtrip() {
        for t in [0.0, 951_782_400.0, 1_792_854_131.0] {
            assert_eq!(parse_iso_utc(&iso_utc(t)), Some(t));
        }
        assert_eq!(parse_iso_utc("garbage"), None);
    }

    #[test]
    fn iso_utc_known_values() {
        assert_eq!(iso_utc(0.0), "1970-01-01T00:00:00Z");
        assert_eq!(iso_utc(1_792_854_131.0), "2026-10-24T15:02:11Z");
        assert_eq!(iso_utc(951_782_400.0), "2000-02-29T00:00:00Z");
    }

    #[test]
    fn paths_never_mix_sources() {
        let r = Path::new("results");
        assert_eq!(runs_dir(r, "model"), Path::new("results/mock"));
        assert_eq!(runs_dir(r, "hw"), Path::new("results/hw"));
        assert_eq!(session_path(r, "hw"), Path::new("results/session.json"));
        assert_eq!(session_path(r, "model"), Path::new("results/mock/session.json"));
        assert_eq!(run_file_name("2026-10-24T15:02:11Z-x"), "2026-10-24T15-02-11Z-x.json");
    }
}
