sl33pinging/SplitSys/sw/crates/vec/src/unit.rs

//! Per-module unit vectors: `pe`, `requant`, `skew`, `packet`.

use crate::{hex, Meta, OutFile};
use serde_json::{json, Value};
use splitsys_golden::consts::{RQ_MULT_MAX, RQ_MULT_MIN, RQ_SHIFT_MAX, RQ_SHIFT_MIN};
use splitsys_golden::numerics::requant_unclamped;
use splitsys_golden::packet::{
    request_frame, response_frame, rx_reference, RxEvent, SYNC_REQ, SYNC_RSP,
};
use splitsys_golden::rng::Rng;
use splitsys_golden::{crc8, requant, requant_is_tie};

pub const MODULES: &[&str] = &["pe", "requant", "skew", "packet"];

/// Default `--n` per module.
pub fn default_n(module: &str) -> usize {
    match module {
        "pe" => 10_000,
        "requant" => 100_000,
        "skew" => 2_000,
        "packet" => 1_000,
        _ => 100,
    }
}

pub fn generate(module: &str, seed: u64, n: usize, meta: &Meta) -> Result<Vec<OutFile>, String> {
    match module {
        "pe" => Ok(pe(seed, n, meta)),
        "requant" => Ok(requant_vectors(seed, n, meta)),
        "skew" => Ok(skew(seed, n, meta)),
        "packet" => Ok(packet(seed, n, meta)),
        _ => Err(format!("unknown module '{module}'; known: {MODULES:?}")),
    }
}

// ------------------------------------------------------------------------- PE

/// One cycle of PE stimulus.
#[derive(Clone, Copy, Debug)]
struct PeCycle {
    a: i8,
    w: i8,
    vld: bool,
    first: bool,
}

/// PE vectors. Stimulus is per cycle (a, w, vld, first) at the PE inputs. `acc[t]` is
/// the accumulator value after cycle t's operands have been applied (zero-latency
/// model; the DUT shows it at `acc_out` L_PE cycles later). Each group is one
/// accumulation (from a `first` to the last valid operand before the next `first`).
pub fn pe(seed: u64, n: usize, meta: &Meta) -> Vec<OutFile> {
    let mut r = Rng::new(seed);
    let mut cyc: Vec<PeCycle> = Vec::new();
    // (start cycle, directed name) per group; the start cycle carries `first`.
    let mut starts: Vec<(usize, Option<String>)> = Vec::new();

    // Append one group: `len` valid operands, with optional vld gaps of garbage
    // operands inside (gap_prob %), then `tail_idle` idle cycles.
    #[allow(clippy::too_many_arguments)]
    fn stream(
        r: &mut Rng,
        cyc: &mut Vec<PeCycle>,
        starts: &mut Vec<(usize, Option<String>)>,
        name: Option<String>,
        len: usize,
        gen: &dyn Fn(&mut Rng, usize) -> (i8, i8),
        gap_prob: u64,
        tail_idle: usize,
    ) {
        starts.push((cyc.len(), name));
        for i in 0..len {
            if i > 0 && gap_prob > 0 {
                while r.chance(gap_prob, 100) {
                    let (a, w) = (r.i8(), r.i8());
                    cyc.push(PeCycle {
                        a,
                        w,
                        vld: false,
                        first: false,
                    });
                }
            }
            let (a, w) = gen(r, i);
            cyc.push(PeCycle {
                a,
                w,
                vld: true,
                first: i == 0,
            });
        }
        for _ in 0..tail_idle {
            let (a, w) = (r.i8(), r.i8());
            cyc.push(PeCycle {
                a,
                w,
                vld: false,
                first: false,
            });
        }
    }

    type Gen = Box<dyn Fn(&mut Rng, usize) -> (i8, i8)>;
    let directed: Vec<(&str, usize, Gen, u64, usize)> = vec![
        (
            "neg128_x_neg128_k256",
            256,
            Box::new(|_, _| (-128, -128)),
            0,
            0,
        ),
        (
            "neg128_x_pos127_k256",
            256,
            Box::new(|_, _| (-128, 127)),
            0,
            0,
        ),
        (
            "pos127_x_neg128_k256",
            256,
            Box::new(|_, _| (127, -128)),
            0,
            0,
        ),
        (
            "pos127_x_pos127_k256",
            256,
            Box::new(|_, _| (127, 127)),
            0,
            3,
        ),
        ("zeros_k64", 64, Box::new(|_, _| (0, 0)), 0, 0),
        ("single_neg128_sq", 1, Box::new(|_, _| (-128, -128)), 0, 0),
        (
            "alternating_sign",
            100,
            Box::new(|_, i| {
                if i % 2 == 0 {
                    (-128, -128)
                } else {
                    (127, -128)
                }
            }),
            0,
            0,
        ),
        (
            "vld_gaps_garbage",
            40,
            Box::new(|r, _| (r.i8(), r.i8())),
            50,
            2,
        ),
    ];
    for (name, len, f, gap, idle) in &directed {
        stream(
            &mut r,
            &mut cyc,
            &mut starts,
            Some(name.to_string()),
            *len,
            f.as_ref(),
            *gap,
            *idle,
        );
    }
    let rand_op: Gen = Box::new(|r, _| (r.i8(), r.i8()));
    // Back-to-back clears: 16 single-operand groups, no idle cycles between them.
    for i in 0..16 {
        stream(
            &mut r,
            &mut cyc,
            &mut starts,
            Some(format!("back_to_back_len1_{i}")),
            1,
            rand_op.as_ref(),
            0,
            0,
        );
    }
    // `first` mid-stream: short groups back to back (a new first while accumulating).
    for i in 0..8 {
        let len = 2 + i % 4;
        stream(
            &mut r,
            &mut cyc,
            &mut starts,
            Some(format!("first_mid_stream_{i}")),
            len,
            rand_op.as_ref(),
            0,
            0,
        );
    }
    let extreme: Gen = Box::new(|r, _| {
        (
            *r.pick(&[-128i8, 127, -1, 0, 1]),
            *r.pick(&[-128i8, 127, -1, 0, 1]),
        )
    });
    for _ in 0..n {
        let len = match r.below(4) {
            0 => r.range_usize(1, 4),
            1 => r.range_usize(200, 256),
            _ => r.range_usize(1, 256),
        };
        let g = if r.chance(1, 3) {
            extreme.as_ref()
        } else {
            rand_op.as_ref()
        };
        let gap = *r.pick(&[0u64, 0, 10, 40]);
        let idle = *r.pick(&[0usize, 0, 1, 5]);
        stream(&mut r, &mut cyc, &mut starts, None, len, g, gap, idle);
    }
    // Trailing idle cycles so the last result reaches acc_out.
    for _ in 0..8 {
        cyc.push(PeCycle {
            a: 0,
            w: 0,
            vld: false,
            first: false,
        });
    }

    // Zero-latency reference (wrapping = low 32 bits of the 48-bit P register).
    let mut acc: i32 = 0;
    let mut accs = Vec::with_capacity(cyc.len());
    for c in &cyc {
        if c.vld {
            let p = i32::from(c.a) * i32::from(c.w);
            acc = if c.first { p } else { acc.wrapping_add(p) };
        }
        accs.push(acc);
    }
    let mut groups: Vec<Value> = Vec::new();
    for (g, (s, name)) in starts.iter().enumerate() {
        let next = starts.get(g + 1).map_or(cyc.len(), |x| x.0);
        let end = (*s..next)
            .rev()
            .find(|&t| cyc[t].vld)
            .expect("group has a valid cycle");
        groups.push(json!({"index": g, "start": s, "end": end, "acc": accs[end], "name": name}));
    }

    let doc = json!({
        "meta": meta.json(seed, "unit/pe"),
        "description": "PE stimulus per cycle at the PE inputs (a_in, w_in, a_vld_in, a_first_in). \
    acc[t] = accumulator after cycle t's operands are applied (zero-latency model); compare acc_out \
    at cycle t + L_PE. groups: one accumulation each; acc at group end must appear at acc_out at end + L_PE.",
        "l_pe": splitsys_spec::L_PE,
        "cycles": cyc.len(),
        "a": cyc.iter().map(|c| c.a).collect::<Vec<_>>(),
        "w": cyc.iter().map(|c| c.w).collect::<Vec<_>>(),
        "vld": cyc.iter().map(|c| u8::from(c.vld)).collect::<Vec<_>>(),
        "first": cyc.iter().map(|c| u8::from(c.first)).collect::<Vec<_>>(),
        "acc": accs,
        "groups": groups,
    });
    let mut stim = meta.mem_header(
        seed,
        "unit/pe stimulus",
        &["one line per cycle: {first, vld, a[7:0], w[7:0]} = 18 bits".into()],
    );
    let mut exp = meta.mem_header(
        seed,
        "unit/pe expected",
        &[
            "one line per cycle: acc after that cycle (zero-latency model), int32 two's complement"
                .into(),
        ],
    );
    for (c, a) in cyc.iter().zip(&accs) {
        let v = (u32::from(c.first) << 17)
            | (u32::from(c.vld) << 16)
            | (u32::from(c.a as u8) << 8)
            | u32::from(c.w as u8);
        stim.push_str(&format!("{v:05x}\n"));
        exp.push_str(&format!("{:08x}\n", *a as u32));
    }
    vec![
        OutFile::json_compact("unit/pe.json", &doc),
        OutFile::text("unit/pe_stim.mem", stim),
        OutFile::text("unit/pe_acc.mem", exp),
    ]
}

// -------------------------------------------------------------------- requant
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
