sl33pinging/SplitSys/(commit log)

2026-10-24 [toolchain-engineer] scripts/env.sh + scripts/wsl helper — scripts/wsl 'cargo --version && pwd' passed
2026-10-24 [toolchain-engineer] scripts/vivado entry point (2025.2.1), setup_env.sh, requirements.txt — scripts/vivado -mode batch -source scripts/vivado_smoke.tcl passed (xc7s50csga324-2 found)
2026-10-24 [rtl-designer] pe.sv (DSP MAC, L_PE=3) and skew.sv (BASE[j]+j) — iverilog -g2012 smoke tb_pe/tb_skew passed
2026-10-24 [rtl-designer] uart_rx/uart_tx 8N1 16x, BAUD_DIV + DIV_OVERRIDE — iverilog smoke loopback 200B x {div 54,1,3, rx 53/55 mismatch} 0 errors passed
2026-10-24 [rtl-designer] counters.sv 12x48b, start-clear/done-freeze, snapshot read port — iverilog smoke tb_counters (3 runs + idle + frozen + midrun) passed
2026-10-24 [spec-steward] spec.toml + codegen: splitsys_pkg.sv and Rust consts (first compiling version) — cargo clippy -p splitsys-spec -D warnings, iverilog smoke, verilator --lint-only -Wall pkg passed
2026-10-24 [golden-modeler] splitsys_golden: GEMM, requant, packing, descriptor, jobs, Fletcher-32/CRC-8 + property tests — cargo test -p splitsys-golden passed; clippy -D warnings clean
2026-10-24 [perf-modeler] splitsys-cycle: cycle-stepped FSM walk + SPEC §4 closed form, all counters, choose_mode, sweep/roofline/explain CLI — cargo test -p splitsys-cycle (20 passed, 10k-case property seed 25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
2026-10-24 [perf-modeler] results/model sweep.json, roofline.json, README.md (source: model, latencies provisional, model_git_hash 8aeedea) — cargo run -p splitsys-cycle -- all, regenerated twice byte-identical
2026-10-24 [toolchain-engineer] check_env.sh, cocotb smoke, Edge screenshot helper, vendor Urbana master XDC copy — scripts/check_env.sh --smoke passed (ALL REQUIRED OK)
    fpga/xdc/urbana_master.xdc is a verbatim copy of C:\Users\danie\Downloads\Urbana.xdc (RealDigital 'URBANA BOARD CONSTRAINTS V2I1 1/3/2023', md5 efdc408b5aab32e8ff03770e47cd6c47 before LF normalization).
2026-10-24 [spec-steward] codegen tests: up-to-date, determinism, contract values, 22 rejection cases — cargo test -p splitsys-spec (33 passed), clippy -D warnings passed
2026-10-24 [toolchain-engineer] docs/ENV.md; executable bits on scripts — scripts/wsl 'source scripts/env.sh && scripts/check_env.sh' passed (ALL REQUIRED OK)
2026-10-24 [rtl-designer] array.sv (FULL/STRIP, row-4 W mux, drain mux, inb masks, quadrant popcounts) — iverilog smoke tb_array ENABLE_STRIP=1 and =0 passed
2026-10-24 [spec-steward] int32 drain per mode (FULL 8x2, STRIP 4x4 = 16), BENCH shapes table, legal FLAGS values — cargo test -p splitsys-spec (36 passed), clippy, verilator -Wall + iverilog pkg passed
2026-10-24 [rtl-designer] pe/skew/array Verilator -Wall clean (ES=1,0) — verilator --lint-only -Wall + iverilog smokes passed
2026-10-24 [spec-steward] SPEC v1.1 + DECISIONS D-001..D-015: Fletcher-32, addressing, flags, int32 drain, RUN_GEMM validation, counter order/mapping, skew fix, protocol — cargo test -p splitsys-spec passed, ge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
2026-10-24 [rtl-designer] buffers.sv (UG901 byte-write TDP BRAM, host byte port, L_RD=2) — iverilog smoke tb_buffers (WBUF/ABUF/RQ geometries) + verilator -Wall passed
2026-10-24 [lead] track sw/Cargo.lock (binaries in workspace) — n/a
2026-10-24 [golden-modeler] splitsys-vec: unit/gemm/directed/selftest/bench generators + tests — cargo test -p splitsys-vec passed; clippy -D warnings clean
2026-10-24 [verification-engineer] tb infra (Makefile, common/sim.mk, splitsys_tb helpers, golden oracle) + PE suite — make -C tb pe passed (8/8, SEED=1)
2026-10-24 [fpga-integrator] project XDC, build/program Tcl, heartbeat_uart_echo bring-up top + sim smoke — scripts/wsl fpga/bringup/heartbeat_uart_echo/sim/run.sh passed (SMOKE PASS, 500 bytes echoed)
2026-10-24 [perf-modeler] regenerate results/model at model_git_hash 37d0b2a (SPEC v1.1; int8 numbers unchanged) — cargo run -p splitsys-cycle -- all, twice byte-identical
2026-10-24 [rtl-designer] requant.sv (16 lanes, bit-exact SPEC 1.2, 6-stage, int32 bypass); skew D = BASE[j] + (j mod COLS) per SPEC v1.1 D-008 — iverilog smokes tb_requant/tb_skew/tb_array + verilator -Wall pa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
2026-10-24 [rtl-designer] packet.sv (framing, CRC-8, SPEC v1.1/D-010 precedence+BUSY+oversize drop, D-005 RUN_GEMM validation, byte-enable mem bus); named elab checks in uart_* — verilator --lint-only -Wall (4 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
2026-10-24 [verification-engineer] skew suite, RTL_REV (test committed rtl by hash), SIGNOFF pe+skew — make -C tb pe skew passed at rtl 36771b6 (8/8, 6/6, SEED=1)
2026-10-24 [fpga-integrator] build.tcl: git_dirty covers exactly the files the build reads — heartbeat_uart_echo build passed (WNS 5.197)
2026-10-24 [fpga-integrator] build.tcl: accept NAME VALUE generics split by cmd.exe '=' — DIV_OVERRIDE=2 refused (exit 2), BUILD_ID override refused (exit 2)
2026-10-24 [golden-modeler] vec provenance hash = last commit touching generator inputs (stable across unrelated commits) — cargo clippy -p splitsys-vec -D warnings clean
2026-10-24 [verification-engineer] requant suite (vec unit/requant 100k + oracle b2b/param timing) + BUGS.md BUG-001 L_RQ mismatch — make -C tb requant: 3/4 pass, latency test fails (6 vs L_RQ 4)
2026-10-24 [golden-modeler] canonical vectors: selftest ROM (464 words, FULL 6c1d81af / STRIP 8b1c6e80) + directed.json at generator d8d5eb17d112 — two runs sha256-identical
2026-10-24 [host-dashboard] splitsys-host: framing/CRC-8, transports (mock/serial/tcp), driver w/ NACK retry, mock board (SPEC v1.1 BUSY/precedence), runner, run records, CLI, dashboard server + scenes 1-3 — ca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
2026-10-24 [fpga-integrator] heartbeat_uart_echo reports (WNS 5.671, 190 LUT, 316 FF, 0 DRC err, 0 latches) + HW_CHECKLIST skeleton H-1/H-2 — scripts/vivado -mode batch -source fpga/tcl/build.tcl -tclargs heart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
2026-10-24 [rtl-designer] board_io.sv (reset root: POR+BTN1+ext, BTN0 debounce, LEDs, heartbeat, 2x4-digit 7-seg scan, polarity from Urbana XDC) — verilator --lint-only -Wall clean; tb_board_io smoke (iverilog 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
2026-10-24 [spec-steward] D-016: L_PE=3, L_RD=2 confirmed (provisional=false), L_RQ=7 (provisional), drop legacy INT32_DRAIN_FACTOR — cargo test -p splitsys-spec (36 passed), clippy, gen --check, workspace buil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
2026-10-24 [spec-steward] SPEC §3.6: L_RQ measured at sequencer level (drain mux + requant) — doc only
2026-10-24 [fpga-integrator] XDC: UART pins swapped per schematic (FPGA RX=B16, TX=A16), LED/BTN active-high, 7-seg active-low with sch page refs — fact check only, rebuild follows
2026-10-24 [rtl-designer] buffers.sv port A = word address + full word + byte enables (packet.sv mem bus contract) — iverilog smoke tb_buffers (3 geometries) + verilator -Wall passed
2026-10-24 [rtl-designer] selftest.sv (ROM loader, FULL+STRIP jobs over run iface, Fletcher-32 D-001) — verilator -Wall clean; iverilog smoke tb_selftest (core stub): loads == job JSON images, fl 6c1d81af/8b1c6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
2026-10-24 [verification-engineer] packet suite (9 tests: PING, mem round trips all regions, NACK_CRC/OPCODE/RANGE/BUSY + precedence, RUN_GEMM §3.5 rules, POLL/counters/selftest, timeout/truncation/oversize, 10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
2026-10-24 [host-dashboard] SET_DISPLAY after each run, mock-over-tcp tagged model, server rescans results, layout fixes from 1920x1080 screenshots — cargo test -p splitsys-host (41 passed) + clippy -D warnings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
2026-10-24 [fpga-integrator] packet_mem bring-up top (uart+packet+4x buffers+board_io, seq/selftest/counter stubs) + Verilator smoke — bash fpga/bringup/packet_mem/sim/run.sh passed (SMOKE PASS, 328 checks; OBU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
2026-10-24 [lead] .gitignore: Vivado root droppings (red-team S0 SEV-3) — git status clean of them
2026-10-24 [fpga-integrator] mark bring-up sim run.sh executable — mode change only
2026-10-24 [fpga-integrator] heartbeat_uart_echo rebuilt with schematic-corrected UART pins (WNS 5.726, build_id 2148101a) + HW_CHECKLIST board facts with schematic page refs — scripts/vivado ... build.tcl -tcl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
2026-10-24 [perf-modeler] regenerate results/model for D-016 (L_RQ 4->7) + timing-contract README section, model_git_hash 8efa5ac — cargo run -p splitsys-cycle -- all, twice byte-identical
2026-10-24 [lead] ignore results/mock (mock-board records) — n/a
2026-10-24 [fpga-integrator] packet_mem built (WNS 2.692, 1316 LUT, 25 BRAM, 0 DRC err, 0 latches) + HW_CHECKLIST H-3 row, H-2 uses existing echo subcommand — scripts/vivado ... build.tcl -tclargs packet_mem pa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
2026-10-24 [verification-engineer] uart suite (tx format/b2b, rx ±3% baud, frame err/glitch, 10k loopback, spec divisor); requant latency per D-016 (L_RQ-1); PE first-without-vld; BUG-001 closed — make -C tb ua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
2026-10-24 [verification-engineer] buffers suite (4 geometries: latency==L_RD both ports, power-up zero, first/last word, byte enables, same-cycle read-first collisions, 12k random cycles) — make -C tb buffers 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
2026-10-24 [fpga-integrator] UART pins split into urbana_uart.xdc / urbana_uart_swap.xdc, build.tcl UART_SWAP=1 option, clear board.repoPaths in build/program Tcl — builds follow
2026-10-24 [host-dashboard] memtest (H-3): random region/unaligned addr/len 1..1019 WRITE_MEM+READ_MEM round trips, flip_read_byte mock fault; WRITE_CHUNK=1019 — cargo test -p splitsys-host (46 passed), clippy 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
2026-10-24 [verification-engineer] counters suite (cycle-model timeline-driven taps, all 12 counters == splitsys-cycle, §3.7 invariants, window/freeze/clear/live snapshot, read port) — make -C tb counters passe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
2026-10-24 [toolchain-engineer] screenshot: per-run Edge profile, hard timeout, kill only this run's Edge, no default virtual-time budget (SSE hang); ENV.md board facts + UART caveat — scripts/screenshot on SSE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
2026-10-24 [fpga-integrator] UART-swap fallback bitstreams (heartbeat_uart_echo_uartswap WNS 5.484, packet_mem_uartswap WNS 2.922) + heartbeat rebuild with 0 critical warnings (board repo cleared), io.rpt confi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
2026-10-24 [fpga-integrator] write_cost.py: results/cost.json from top/top_nostrip summaries (same commit, clean, pass, ENABLE_STRIP 1/0) — refusal path checked (rc 1 on bring-up summaries)
2026-10-24 [verification-engineer] array suite (FULL+STRIP, ES=1 and ES=0: identity/all-ones/-128 K=256, single nonzero per position 64+64 tiles, quadrant isolation, mode switching, 500+500 random tiles, per-cy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
2026-10-24 [verification-engineer] tb/system (UART-pin system suite: full/strip/directed/modeswitch/selftest, frames+outputs+counters from Rust) + tb/cosim (Verilator top behind TCP<->UART bridge, host_check) —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
2026-10-24 [verification-engineer] harness: force fresh sim runs (cocotb sim target could skip under -j and exit 0); SIGNOFF all 8 S1 units — make -C tb -j8 units passed 8/8 suites 50/50 tests SEED=1,2 at rtl 6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
2026-10-24 [rtl-designer] top.sv (pins per XDC contract; board_io reset root; packet/selftest bus+run mux in front of core; counters from core taps) — verilator --lint-only -Wall --top-module top rtl/*.sv clean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
2026-10-24 [golden-modeler] packet vectors: back_to_back labelled parser-level only; add request_response sequenced variant — cargo test -p splitsys-golden -p splitsys-vec passed; clippy -D warnings clean
2026-10-24 [golden-modeler] regenerate canonical vectors at generator 7140392 (provenance only; data sha256 unchanged) — cargo test -p splitsys-golden -p splitsys-vec passed, two runs sha256-identical
2026-10-24 [spec-steward] SPEC/DECISIONS D-017..D-019: latencies confirmed, name parity, operand offset, strict req/resp, exact RX timeout, baud plan — docs only (cargo test -p splitsys-spec 38 passed at 714039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
2026-10-24 [perf-modeler] use splitsys_spec::OPERAND_PORT_OFFSET (D-018); README status caveat (MODEL, not yet reconciled) for confirmed latencies (D-017) — cargo test -p splitsys-cycle (23 passed) + clippy -D 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
2026-10-24 [perf-modeler] regenerate results/model at 90939f4: latencies_provisional false (D-017), numbers unchanged — cargo run -p splitsys-cycle -- all, twice byte-identical
2026-10-24 [verification-engineer] packet: D-019 exact RX timeout edge (g=RX_TIMEOUT continues, +1 resets; both off-by-one mutants caught) and strict request/response discard (during execution and during respon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
2026-10-24 [perf-modeler] model_git_hash = last commit touching model inputs (sw/crates/cycle, sw/crates/spec, spec/), --abbrev=12, -dirty, env override (red-team S1 SEV-3) — cargo test -p splitsys-cycle (24 pa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
2026-10-24 [perf-modeler] regenerate results/model at model_git_hash 72da65248adf (inputs-scoped hash; numbers unchanged) — cargo run -p splitsys-cycle -- all, twice byte-identical
2026-10-24 [rtl-designer] top: per-block registered resets (core/selftest/packet/counters/uart, keep + max_fanout 256, INIT 1); board_io rst_r max_fanout 50 — verilator -Wall --top-module top clean (ENABLE_STRI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
2026-10-24 [demo-storyteller] README, docs/devpost.md, DEMO §7–§9 (3 pitches ≤280 words, Q&A 8.1–8.3, fallback scripts) — skeletons with ⟦HW/SIM/HUMAN⟧ placeholders; MODEL [72da65248adf] and BUILD [cost.json 35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
2026-10-24 [host-dashboard] run records: model_git_hash = splitsys_cycle::report::model_git_hash (inputs-scoped, -dirty, env override); git_hash = host binary's own hash embedded by build.rs — cargo test -p spl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
2026-10-24 [toolchain-engineer] pin matplotlib 3.9.2 + numpy/pillow and transitive deps; check_env requires matplotlib — scripts/wsl 'scripts/check_env.sh' passed (ALL REQUIRED OK), fresh venv from requirements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
2026-10-24 [fpga-integrator] build.tcl PHYS_OPT=<directive> / POST_ROUTE_PHYS_OPT=1 options (recorded in summary.json); report_paths.tcl (worst 10 paths + reset-register fan-out from a checkpoint) — builds foll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
2026-10-24 [verification-engineer] SIGNOFF: clean make -C tb signoff at b53783d (tb ddc358f) — 11/11 suites, 74/74 tests
2026-10-24 [verification-engineer] SIGNOFF: fix test count (64/64, not 74) — doc only
2026-10-24 [verification-engineer] tb/system + tb/cosim adopt tb/common/provenance.mk (SPLITSYS_CACHE_TAG default ve2, namespaced oracle/sw-target/sim_build, per-run logs, SIGNOFF=1 = PROV_ELIGIBLE) — make -C t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
2026-10-24 [demo-storyteller] fill SIM slots from results/sim (f70dec9, 46 co-sim records, 0 counter diffs) and refresh cost to results/cost.json 8bbd7ba6 (+2,239 LUT/+1,590 FF/+16 DSP; Fmax delta routing-domin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
2026-10-24 [verification-engineer] SIGNOFF_SYSTEM: clean system sign-off — make -C tb/system SIGNOFF=1 SEED=1 passed 617/617 at HEAD 30475dc (rtl adca4a3, tb a96ca75, eligible YES); cosim-check 8/8 at 34cbc27 (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
2026-10-24 [fpga-integrator] HW_CHECKLIST: H-4 selftest --dump + OBUF dump capture linked to T-1, H-5 first-failure PE/quadrant, Windows host build pre-flight (P-5a), win_build_host -Ping at H-2 — doc only
2026-10-24 [fpga-integrator] one-shot S4 rebuild (fpga/tcl/s4_rebuild.sh, run with bash) + manifest.py; HW_CHECKLIST rows now reference a generated Bitstream manifest (build_id, git, WNS/WHS, pins, md5) — manif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
2026-10-24 [verification-engineer] untrack results/sim/session.json (written concurrently by two host processes during the evidence run: 56 of 66 GEMMs, lost update); dirty-era copy stays in archive_dirty/ — no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
2026-10-24 [fpga-integrator] s4_rebuild.sh executable bit — mode change only
2026-10-24 [fpga-integrator] S4 freeze rebuild: 6 bitstreams at 52a66216, cost.json, manifest — bash fpga/tcl/s4_rebuild.sh passed
2026-10-24 [lead] STATUS: resume note at pause (12:12), gate board, corrected times — n/a
2026-10-24 [lead] STATUS: S4 rebuild done (8ccb333), resume steps updated — n/a
2026-10-24 [lead] STATUS: storyteller pause state in resume note — n/a
2026-10-24 [host-dashboard] S4: re-shot sim scenes 1-3 at build 05900507 (rebuilt cost, all-12-counter table, int32 labels) + 4 scripted-demo sim records (git_hash 5900507, 0 mismatches) + derived session.json 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
2026-10-24 [toolchain-engineer] WSL idle-shutdown mitigation: scripts/wsl_keepalive start|stop|status, check_env optional row, ENV.md known issue + .wslconfig snippet — tested by agent (distro stayed up 24 min)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
2026-10-24 [demo-storyteller] red-team S4: cost figures from S4 freeze cost.json (52a66216: +2,247 LUT / +43.7%, +16 DSP, muxing 666 LUT; Fmax est. 126.5/105.5 not headlined, split worst path = reset net 0 leve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
2026-10-24 [toolchain-engineer] scripts/wsl_keepalive executable bit — mode change only (committed by lead)
2026-10-24 [lead] STATUS: S2/S3 PASS, S4 PASS w/ conditions; Phase H may begin — n/a
2026-10-24 [fpga-integrator] insurance build top_uartswap (full top, UART_SWAP=1, RX A16/TX B16) pinned to 52a66216: pass, not dirty, WNS +2.388 / WHS +0.028, 0 DRC errors, 96 DSP, 26 BRAM, ROM read + kept (u_s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
2026-10-24 [rtl-designer] H-1 board facts: LEFT_IS_D1=0, AN0_IS_RIGHT=0 defaults (top, board_io); header comments mark display orientation + active-high buttons as hardware-confirmed (H-1, Sat 2026-10-24, build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
2026-10-24 [verification-engineer] tb/system display suite: 7-seg image rebuilt from real top D0/D1 AN/SEG pins with the H-1 hardware-confirmed rule (D0 left, AN[0] leftmost; '6.126 6A25' observed for build 52a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
2026-10-24 [lead] Phase H H-3/H-5 hardware evidence: memtest 10000 frames PASS; run --random 100 --mode both --seed 1 BATCH PASS (200 GEMMs, 0 mismatches, 0 counter mismatches vs model 72da65248adf) on build 52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
2026-10-24 [fpga-integrator] Phase H fixes: UNUSEDPIN PULLDOWN (H-1 RGB glow; safety reasoning in XDC + Board facts), H-1 expected 7-seg = build_id reversed with DP after first digit ('6.126 6A25' for 0x52A6621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
2026-10-24 [fpga-integrator] KG1: archive top bit (md5 6a85a822b28e7d9f2097a8a902d865bf, build 52a66216) + reports + HW test logs; CURRENT -> KG1
2026-10-24 [demo-storyteller] G4: README/devpost/DEMO 7-9 filled from results/hw (256 board GEMMs, build 52a66216 = KG1); plots regenerated with HW overlays
    - Every HW placeholder replaced from the 256 per-run records (counts derived, session.json agrees):
    ffn_up M=1 6.95% FULL / 14.40% STRIP (2.07x), M=1 range 2.02-2.07x, M=64 55.65/57.65%;
    0 of 3,072 counter values != model; 118,801,362 MACs, 952,012 outputs, 0 mismatches; cycles_stall 0.
    - New honest finding from H-5: STRIP slower on 31 of 97 shape-matched random pairs (max 1.32x,
    all with more STRIP tiles); README, devpost and Q&A say so.
    - KG1 build id resolved (fpga/known_good/KG1/summary.json 0x52A66216); exact H-3..H-6 commands.
    - Red-tea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
2026-10-24 [host-dashboard] start_demo.ps1: fix single-match host path ($candidates[0] was 'C'), probe / with 3 s timeout for up to 40 s (state snapshot ~330 KB), add -WindowPosition for the kiosk monitor — fou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
2026-10-24 [fpga-integrator] KG2 prep: ENV.md display row -> H-1 rule (D0 left, AN[0] leftmost); drop heartbeat_uart_echo_uartswap/packet_mem_uartswap from s4_rebuild.sh JOBS and manifest TAGS (UART pins confir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
2026-10-24 [fpga-integrator] S4 freeze rebuild: 4 bitstreams at 38a3950a, cost.json, manifest — bash fpga/tcl/s4_rebuild.sh passed
2026-10-24 [fpga-integrator] HW_CHECKLIST Board facts: display fix lands in build 38a3950a (KG2 candidate), H-1 heartbeat text for it 'A.059 3A83'
2026-10-24 [lead] H-7 dashboard scripted demo on live board (4 extra hw records @52a66216), session totals, STATUS (solo entry, H-7 dashboard PASS) — n/a
2026-10-24 [fpga-integrator] H-8 QSPI flash prep: fpga/tcl/flash.tcl (image/program/verify/erase, boot + DONE check), flash part IC10 MT25QL128ABA8ESF / Vivado mt25ql128-spi-x1_x2_x4 and boot jumper J14 (M2) fr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
2026-10-24 [fpga-integrator] KG2: archive top bit (md5 63dea71fd7e8c151f836143c8bac2b2a, build 38a3950a) + reports + HW test logs; CURRENT -> KG2
2026-10-25 [lead] Phase H H-8 PASS: KG2 flashed to QSPI (MT25QL128, J14 fitted), boots from flash in ~1 s; cold start to dashboard ~2 s — log results/hw/logs/KG2/H-8_flash_program.log
2026-10-25 [fpga-integrator] PULLDOWN safety wording corrected; HW_CHECKLIST session results + booth fallback
    - fpga/xdc/urbana_splitsys.xdc: COMMENT-ONLY edit. Constraint values are
    unchanged (non-comment lines identical to the previous commit), so KG2's
    bitstream stays valid and a rebuild would get the same constraints.
    The comment no longer says "no pin in the master XDC is an active-low
    enable": USB_SS_B (T12) and ddr3_ras_n/cas_n/we_n are active low and are
    asserted by the pull-down. That is harmless because USB_RESET_B and
    ddr3_reset_n are also low (both devices held in reset). SEL_JOYSTICK (F6)
    also goes low; its purpose is not stated and the pin is unused.
    - docs/HW_CHECKLIST.md: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
2026-10-25 [toolchain-engineer] ENV.md sync with Phase H: UART direction confirmed (H-2), fallback retired; QSPI/J14 boot facts + KG2 flash boot; FT2232H/COM3 facts; Windows host build verified; keepalive recom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
2026-10-25 [lead] track results/hw/logs (Phase H evidence was gitignored by *.log; docs cite these paths): H-3..H-6 KG1, KG2 H-4/H-5/H-8 flash, P-4 USB/COM; dated KG1 H-7 row (approx time, flagged) — n/a
2026-10-25 [host-dashboard] --version shows host git hash; mock-over-tcp labelled model; roofline counts all records
    - splitsys-host --version: 0.1.0 (git <HOST_GIT_HASH>); /api/state host_version +
    host_git_hash; dashboard header tooltip.
    - Board::effective_source(): a board that PINGs with the mock build id ("MOCK")
    is MODEL on any transport. serve adopts it on every (re)connect: source model,
    mock: true, results/mock runs/totals swapped in, DEMO DATA, never verified;
    a real build id on tcp: goes back to sim. ping/selftest/memtest print it.
    - Roofline measured int8 dots were drawn from the snapshot runs list (latest
    MAX_RUNS=400), so results/hw showed 379 of 439 int8 records. The server now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
2026-10-25 [lead] STATUS: host 21d7b04 live on KG2 — n/a
2026-10-25 [lead] STATUS: G4 PARTIAL + human AI-disclosure decision — n/a
2026-10-25 [fpga-integrator] KG2: add H-8 flash log evidence; H-7 expects CURRENT KG (38a3950a)
    Copy results/hw/logs/KG2/H-8_flash_program.log into fpga/known_good/KG2/logs/
    (evidence only; top.bit, reports, summary.json unchanged) and note it in
    archive.txt. HW_CHECKLIST H-7 now derives the expected PING build_id from
    fpga/known_good/CURRENT (KG2 = 38a3950a) instead of hard-coded KG1 52a66216.
2026-10-25 [demo-storyteller] G4 red-team fixes: Built with + Claude Code (AI coding agents) in README/devpost; tagline 'up to 2.07x'; mutants-or-sensitivity wording (devpost, DEMO 7.3/8.1); model commit timing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
2026-10-25 [host-dashboard] start_demo.ps1: -WindowPosition auto (default) = first non-primary display, so a replugged/moved monitor is found — fixed by lead after the monitor moved to X=-1536 on replug
2026-10-25 docs(DEMO): fix mutant sentence in Annapurna pitch; add live-counter Q&A row
2026-10-25 [lead] STATUS: G4 agent items PASS; booth-runs-not-committed policy — n/a
2026-10-25 [lead] STATUS: human checked Scenes 2-3 on the monitor — n/a
2026-10-25 [lead] STATUS: G5 stretch decisions (auto mode; stories260K tiny LM phase 1/2) — n/a
2026-10-25 [host-dashboard] G5 stretch: --mode auto (model-scored mode selection per GEMM)
    run (named, gemm.json, --random) and bench take --mode auto: per GEMM the host
    calls splitsys_cycle::choose_mode with the frozen default Latencies (ties ->
    FULL) and runs only that mode, with every existing check (bit-exact, 12
    counters vs model, invariants). Run records gain mode_select: chosen mode,
    automatic, policy, and the model's cycles/tiles for BOTH modes (validated:
    chosen == gemm.mode == argmin). run_id ends -<mode>-auto.
    run --random N --mode auto reuses the FULL generator's operands/bases (FULL
    picks byte-identical; STRIP picks re-targeted with golden) and prints an AUTO
    summary: picks, measured cycl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
2026-10-25 [lead] STATUS: auto mode on hardware — n/a
2026-10-25 [host-dashboard] G5: splitsys-host lm + Scene 4 — stories260K with every linear layer on the board
    `splitsys-host lm --prompt P --tokens N [--mode full|strip|auto] [--model-dir D]`
    drives splitsys_lm::Generator; each LinearCall (37 per token: 7 x 5 layers + cls0/cls1,
    M=1, int32 bypass) runs through the driver: WRITE_MEM W/A (skipped if resident),
    OBUF poison on the compared bytes, RUN_GEMM, poll, READ_COUNTERS, READ_MEM of the
    in-bounds int32 ranges. The read-back must equal expected_acc bit for bit (abort
    naming step / call / layer / matrix), all 12 counters are compared with
    splitsys_cycle::predict, SPEC 3.7 invariants checked. The board's output (not the
    expectation) feeds the generato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
2026-10-25 [lead] G5 tiny LM on hardware: stories260K (karpathy/tinyllamas, MIT) 'Once upon a time' + 8 greedy tokens on KG2 38a3950a, host 5c59139: 444/444 linear-layer GEMMs bit-exact, counters == model 444/4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
2026-10-25 [spec-steward] D-020: BAUD 115200 -> 1,562,500 (BAUD_DIV 54 -> 4, exact) for KG3
    G5 stretch "KG3 faster UART". The tiny-LM run on KG2 at 115200 is bound by the UART:
    30.76 s per step of wall time against 295 us on chip
    (results/hw/logs/KG2/G5_lm_stories260k_8tok.log). RX_TIMEOUT is unchanged at
    1,000,000 cycles (10 ms, now about 1,562 character times of 640 cycles each).
    KG2 remains the 115200 fallback. A new test keeps 115200, 1,562,500, and
    3,125,000 valid. SPEC §3.8 is updated.
2026-10-25 [fpga-integrator] KG3 candidate build 21dd6850 (BAUD 1,562,500, BAUD_DIV 4): kg3_top/kg3_heartbeat_uart_echo/kg3_packet_mem pass, timing-clean; HW_CHECKLIST KG3 qualification
    Built at 21dd6850 (HEAD pinned via GIT_HASH, canonical flow PHYS_OPT=AggressiveFanoutOpt POST_ROUTE_PHYS_OPT=1). All pass, git_dirty false, 0 DRC errors, 0 latches.
    - kg3_top: WNS +0.473 / WHS +0.022 ns, LUT 7377 FF 7928 DSP 96 BRAM 26, md5 94bb7160ee61aff4b7f8cb9112cd7ed9
    - kg3_heartbeat_uart_echo: WNS +5.145 / WHS +0.024, md5 7429e8659d6994a1363e280336b1d502
    - kg3_packet_mem: WNS +3.230 / WHS +0.089, md5 5ef34d4aa4421b54a1c4b41a3795cd04
    DIV_OVERRIDE bound to 0 everywhere; routed netlists: u_rx/div_cnt 2 bits, tick = d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
2026-10-25 [host-dashboard] baud: --baud auto probes 1562500 (KG3) then 115200 (KG2) at PING; hints, start scripts, header link
    - --baud <rate|auto> (default auto): over serial, PING at spec BAUD first, then the KG2 rate
    once; only PING is ever sent at a rate that has not answered. An explicit rate never probes;
    on no answer it prints "no answer at <b> baud (...) - KG2 runs at 115200, KG3 at 1562500:
    retry with --baud <other>". Server reconnects probe too, last good rate first.
    - ping prints "baud N"; start_demo.ps1 -Baud (default auto) parses it and pins serve to it;
    .bat takes it as 2nd arg, .sh as 3rd.
    - LM wall-time note takes the baud from the record's transport (no hard-coded 115200).
    - /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
2026-10-25 [lead] G5 tiny LM backup story on KG2: stories260K 'Once upon a time' + 30 tokens → 1258/1258 GEMMs bit-exact, counters == model 1258/1258; 'Once upon a time, there was a little girl named Lily. She 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
2026-10-25 [lead] STATUS: KG2 backup story, KG3 built, host baud auto — n/a
2026-10-25 [verification-engineer] KG3 (D-020, BAUD_DIV 4): real-divisor UART tests, cosim/system UART_DIV=0, clean-host cosim-check
    tb/uart: the spec-divisor pair gets an external RX line. test_spec_divisor_baud checks the
    package against spec.toml [uart] and runs 308 back-to-back bytes at 64 clk/bit with exact
    bit timing. New test_spec_rx_line_error drives the real divisor at the FT2232H's actual
    rates (12 MHz/7.625 = +0.72%, 12 MHz/7.75 = -0.90%), the opposite signs, and +-1.5%/+-3%,
    both at full line rate and with idle gaps. New test_spec_rx_frame_error_and_glitch covers
    glitches of 1..31 clk at every divider phase, a frame error, and recovery.
    tb/packet: assert that the RX_TIMEOUT_CYC override is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
2026-10-25 [verification-engineer] KG3 sign-off: units 66/66, system 625/625, cosim-check 8/8 at ac893cd (BAUD_DIV 4)
    The unit sign-off covers the real UART divisor: 64 clk/bit with 0 error; FT2232H line error +0.72% and -0.90%;
    +-1.5% and +-3%; back-to-back frames at full rate; glitch rejection. The real-divisor system smoke passes 6/7.
    The one failure is selftest_busy, which cannot meet its own window precondition at 640 clk/byte.
    This is documented as a test limitation, not an RTL bug.
2026-10-25 [lead] KG3 (21dd6850, 1,562,500 baud) hardware qualification: Q-1 echo 100k 0 mismatched (25.4 s @16 ms latency timer → 1.57 s @1 ms); Q-2 ping; Q-3 selftest --dump PASS; Q-4 memtest 10000 frames PAS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
2026-10-25 [lead] KG3 Q-3: human BTN0 self-test on kg3_top -> LED0+LED1 — n/a
2026-10-25 [fpga-integrator] KG3: archive kg3_top bit (md5 94bb7160ee61aff4b7f8cb9112cd7ed9, build 21dd6850) + reports + HW test logs; CURRENT -> KG3
2026-10-25 [lead] KG3 archive note: FTDI latency timer per log + baud context for wall-time comparisons (red-team SEV-2/SEV-3)
2026-10-25 [lead] KG3 flashed + live demo; STATUS — n/a
2026-10-25 [demo-storyteller] G5 refresh: KG3 live (21dd6850, 1,562,500 baud), 773 committed HW GEMMs (KG1 272 / KG2 301 incl. 100 auto / KG3 200), auto mode, stories260K on the board; pitches + Q&A + booth che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
    Every number recomputed from git-tracked results/hw records, results/hw/lm, logs, cost.json and fpga/reports/kg3_top/summary.json.
2026-10-25 [lead] untrack results/session.json (derived from records, rewritten live by the server; docs count totals from committed records) — n/a
2026-10-25 [host-dashboard] Scene 4: operator prompt + token count controls; token cap 48 -> 200
    - demo: prompt box (prefilled "Once upon a time", max 80), token box (8) with -/+
    steppers, Generate / Stop buttons, info line: inline server validation errors,
    or an estimate of laptop wall time = tokens x measured s/token from the newest
    LM record on the same transport+baud (labelled estimate, + per-prompt-token cost).
    G / X use the box values; global keys (1-4, Space, A, R, F, G, X) are ignored
    while a text box has focus (app.js typingTarget); Enter = Generate, Esc = blur.
    Generate disabled while a run is in progress or in REPLAY view.
    - server: lm_opts token cap 1..=200 (prompt <= 80 chars -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
2026-10-25 [lead] really untrack results/session.json (369124a re-added it via a path-limited commit); ignore hw/mock session totals, keep the committed results/sim/session.json (cited evidence) — red-team SEV-1
2026-10-25 [host-dashboard] G5 red-team fixes: Scene 2/3 benchmark + sweep points from ALL records on disk (newest per M,K,N,mode,requant; was capped at 400 and lost the KG1 sweep); auto panel says 'all builds'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
    cargo test -p splitsys-host (86 lib + app_js + lm_js passed); screenshots of scenes 2/3/4 on a scratch server
2026-10-25 [lead] docs/WINNERS_RESEARCH.md: Cal Hacks 11/12 winners analysis + SplitSys framing/video plan (research agent, cited); note: its 'large M → FULL' limitation line is superseded by the data (STRIP ≥ 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
2026-10-25 DEMO: 3-minute judging pitch, category angles, live-table checklist; README: hook aligned with approved framing
2026-10-25 video: burned-in caption track (SRT, 2:00 voiceover)
2026-10-25 [lead] devpost: red-team 05:14 fixes — tagline drops 'real LLM' overclaim ('a real (tiny) model's matmuls'), Limits line lists everything on the laptop (37 linear matmuls/token on the FPGA)
2026-10-25 video: VIDEO.md kit (2:00 shot list + VO, 60 s cut, phone and screen checklists, Clipchamp recipe, sources)
2026-10-25 [lead] video end card: Zhicheng (Daniel) Song · built solo; GitHub link via Devpost — n/a
2026-10-25 [lead] README: repository layout table for GitHub visitors — n/a
